prod1cys-cmd/RVN/README.md

# RVN — НИР «Равенство»: модуль первичной обработки сигналов судовой РЛС

НИР «Формирование облика программно-аппаратных средств первичной обработки сигналов судовой радиолокационной станции S- и X-диапазонов» для АО «Равенство» (договор № ОПР-002Н/8-2д от 01.04.2026, ДС № 1 от 18.09.2026). Исполнитель — ОКБ РЭС ГУАП.

В репозитории лежат отчёт о НИР, программа и методика испытаний с протоколами, конструкторская документация на модуль ПОС, плату ПОС, рабочее место и кабели, а также исходные документы (ТЗ, письма, закупки).

## Структура

| Папка | Что внутри |
|---|---|
| [Отчетная документация](Отчетная%20документация/) | Книги отчёта о НИР, ПМ АРБМ.468332.022ПМ, протоколы К-01…К-22 |
| [АРБМ.468332.022 Модуль ПОС](АРБМ.468332.022%20Модуль%20ПОС/) | КД на модуль ПОС (Э2, Э4), плату ПОС АРБМ.468157.011, рабочее место АРБМ.468915.018 и кабели |
| [Документы](Документы/) | ТЗ и ДС, протокол совещания ОПР-2, план-график, перечень отчётной документации, письма заказчику, закупки, патентный поиск, рабочие материалы |

## Состав отчёта о НИР (на 10.11.2026)

| Книга | Название | Файл |
|---|---|---|
| 1 | Аналитический обзор, методология и технические требования | `Отчетная документация/…Книга 1` |
| 2 | Алгоритмы, математическое моделирование и программное обеспечение (объединяются бывшие книги 2 и 4) | `…Книга 2`, `…Книга 2 Модели`, `…Книга 4` — до объединения |
| 3 | Техническая реализация и описание макетов | `…Книга 3` |
| 4 | Технико-экономическое обоснование | — |

Ссылки между книгами даются на уровне книги и раздела («книга 1, раздел 1»); книги отчёта в списки источников не включаются.

## Обозначения

| Обозначение | Изделие / документ |
|---|---|
| АРБМ.468332.022 | Модуль первичной обработки сигналов (модуль ПОС) |
| АРБМ.468157.011 | Плата ПОС (основа функциональных макетов 1 и 2) |
| АРБМ.468915.018 | Рабочее место модуля ПОС |
| АРБМ.468915.104…114 | Кабели рабочего места К4, К5, К6, К10, К14 |
| АРБМ.468332.022ПМ | Программа и методика лабораторных испытаний макетов |

Микросхема АЦП/ЦАП АО «Цифровые решения» в документах обозначается по ГОСТ — **К5119ПВ1Я** (в файлах САПР — Bazalt, А-ЦАП 8-400/8-1600).

## Форматы файлов

`.cdw` — КОМПАС-3D (рядом лежит PDF), `.docx` — Word, `.dxf` — чертежи для КОМПАС/AutoCAD, `.GTL/.GBL/…` — Gerber, `.NET` — списки соединений Altium.
