prod1cys-cmd/RVN/АРБМ.468332.022 Модуль ПОС/АРБМ.468157.011 - Плата ПОС/README.md

# АРБМ.468157.011 Плата ПОС

Печатная плата обработки на СнК Zynq-7000 XC7Z030-1FFG676I с АЦП/ЦАП К5119ПВ1Я, синтезатором HMC7044, усилителями ПЧ AD8367, памятью DDR3 1 ГБ, флеш-памятью 2 × MT25QU02G, микроконтроллером STM32H745, коммутатором Ethernet KSZ9893 и преобразователем USB FT4232HL. На ней собраны функциональные макеты 1 и 2.

| Файл / папка | Содержание |
|---|---|
| АРБМ.468157.011Э3 - Плата ПОС.pdf | Схема электрическая принципиальная |
| АРБМ.468157.011ПЭ3 - Плата ПОС (.docx, .pdf) | Перечень элементов |
| АРБМ.468157.011Э2 - Схема тактирования платы ПОС (.cdw, .pdf) | Тактирование: внешний опорный 10 МГц (X12, SMA) → HMC7044 с генераторами 100 МГц G3, G4 → 400 МГц на К5119ПВ1Я и банк 112 приёмопередатчиков |
| АРБМ.468157.011Э2- Схема питания платы ПОС (.cdw, .pdf) | Вторичное электропитание: ADP2384, TPS54622, TPS7A9201 |
| [Project Outputs for PCB_Project](Project%20Outputs%20for%20PCB_Project/) | Выходные файлы Altium: BOM, списки соединений, отчёты |
| [POS26 gerbers](POS26%20gerbers/) | Gerber-файлы, стек слоёв и бланк заказа плат |

Связанные документы: ТЗ на трассировку — `Документы/АРБМ.468157.011ТЗ…`; сборочный чертёж и альбом — `Документы/АРБМ_468157.011…pdf`; статус закупки компонентов — `Документы/Закупки (КП и перечни)/Статус_закупки.xlsx`.
