prod1cys-cmd/RVN/АРБМ.468332.022 Модуль ПОС/АРБМ.468157.011 - Плата ПОС/POS26 gerbers/README.md

# Gerber-файлы платы ПОС (POS26)

Файлы для изготовления платы находятся в папке [Gerbers](Gerbers/).
