prod1cys-cmd/RVN/АРБМ.468332.022 Модуль ПОС/АРБМ.468915.018 Рабочее место/Кабели/КД_кабели_АРБМ.468915.018/Результат/АРБМ.468915.114СБ К14.pdf

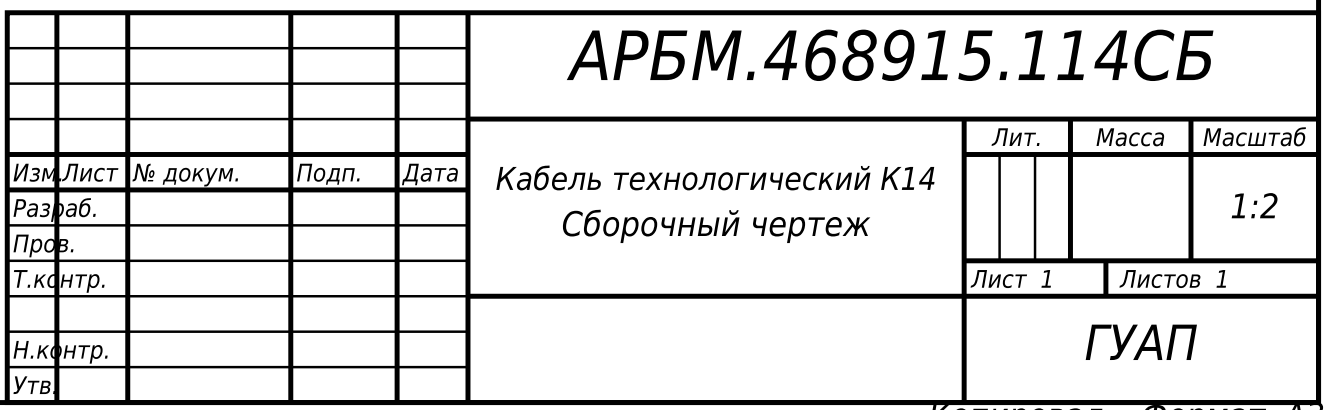
[picture p1: figure]
Изм.Лист; № докум.; Подп.; Дата; Разраб. Пров. Т.контр.; Н.контр. Утв.; Лит.; Масса; Масштаб; Лист 1; Листов 1; АРБМ.468915.114СБ; Кабель технологический К14 Сборочный чертеж; ГУАП

Копировал Формат A3

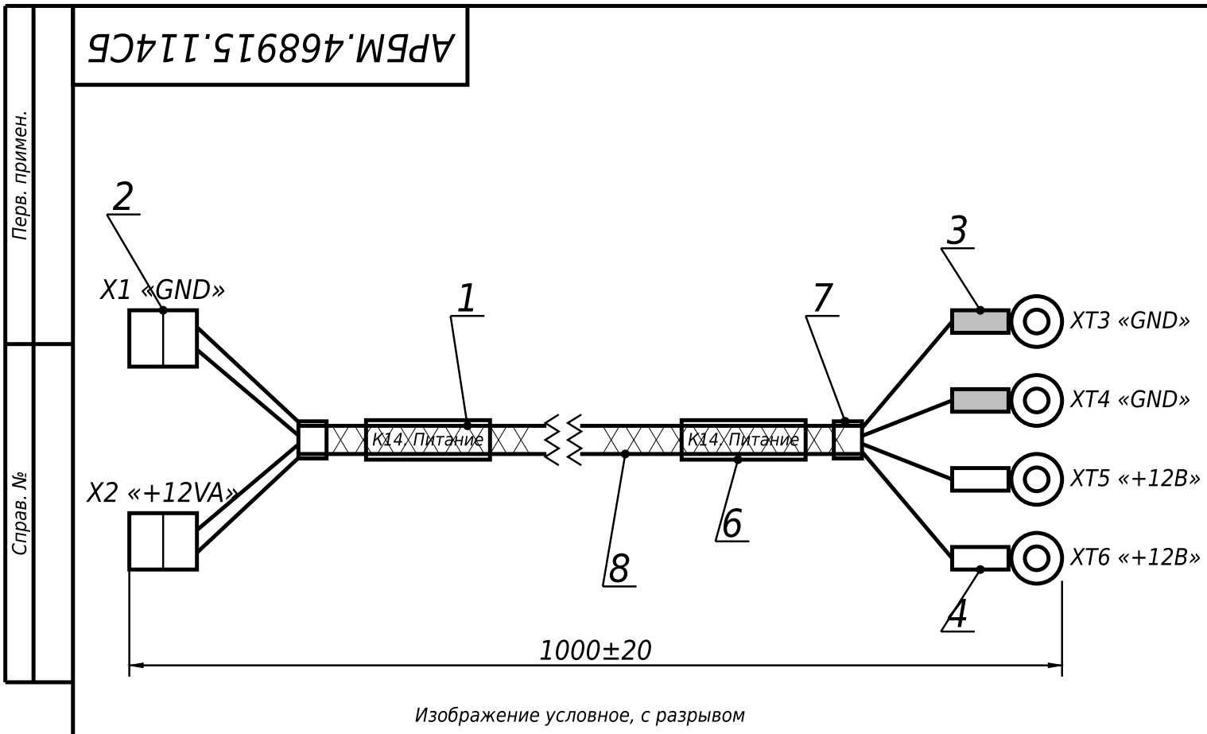
[picture p2: figure]
X1 «GND»; К14. Питание; XT3 «GND»; XT4 «GND»; Изображение условное, с разрывом

Инв. № подл. Подп. и дата Взам. инв. № Инв. № дубл. Подп. и дата Перв. примен. Справ. №

Схема соединений (запараллеливание цепей питания)

X1:1 | П1 | XT3
X1:2 | П2 | XT4
X2:1 | П3 | XT5
X2:2 | П4 | XT6

A8 CH1−

A8 CH1+

Таблица соединений
Провод | Откуда Цепь | | Марка, бирка | Куда | Примечание
П1 | X1:1 | GND | МГТФ 0,5; «П1» | XT3 (НКИ 1,5-4 чёрный) → A8 CH1− | Парал. с П2
П2 | X1:2 | GND | МГТФ 0,5; «П2» | XT4 (НКИ 1,5-4 чёрный) → A8 CH1− | Парал. с П1
П3 | X2:1 | +12VA | МГТФ 0,5; «П3» | XT5 (НКИ 1,5-4 красный) → A8 CH1+ | Парал. с П4
П4 | X2:2 | +12VA | МГТФ 0,5; «П4» | XT6 (НКИ 1,5-4 красный) → A8 CH1+ | Парал. с П3

1 * Размеры для справок.
2 Длину L = 1000 ± 20 мм измерять от торца розеток X1, X2 до торцов наконечников XT3–XT6.
3 Монтаж цепей П1–П4 вести проводом МГТФ 0,5 ТУ 16-505.185-71 по таблице соединений.
4 Цепи питания выполнить запараллеленными: П1 и П2 (GND) — от контактов X1:1 и X1:2 к наконечникам XT3, XT4; П3 и П4 (+12VA) — от X2:1 и X2:2 к XT5, XT6. Наконечники XT3, XT4 подключать к одной клемме CH1−, XT5, XT6 — к клемме CH1+ источника A8.
5 Заделку проводов в розетки 3-640427-2 выполнять методом IDC инструментом TE 58074-1 с головкой для MTA-156 согласно спецификации применения TE. Повторная заделка провода в тот же контакт не допускается.
6 Наконечники НКИ 1,5-4 обжимать инструментом для изолированных наконечников (матрица 0,5–1,5 мм²). Усилие на отрыв провода — не менее
40 Н.
7 Провода ствола заключить в оплётку поз. 8; торцы оплётки оплавить и закрепить трубкой поз. 7 длиной 25 мм.
8 Провода маркировать с двух сторон бирками поз. 5 «П1» … «П4» (шрифт 2,5 ГОСТ 2.304). У розеток X1, X2 и у наконечников установить бирки поз. 6 «К14. Питание».
9 Проверить цепи на обрыв и короткое замыкание по таблице соединений; сопротивление изоляции между цепями GND и +12VA — не менее 20 МОм при 100 В. Сопротивление каждой цепи (два провода параллельно) — не более 0,05 Ом.
