prod1cys-cmd/RVN/Документы/README.md

# Документы

Исходные и организационные документы НИР.

| Файл / папка | Содержание |
|---|---|
| [ТЗ](ТЗ/) | Техническое задание и дополнительное соглашение № 1 |
| Протокол № ОПР-2 от.docx | Протокол совещания по НИР с АО «Равенство» (02.09.2026) |
| План-график_работ_НИР.docx | План-график работ (приложение № 2 к ДС № 1) |
| Перечень_отчётной_документации_НИР (1).docx; Перечень отчетной документации (.cdw, .pdf) | Перечень отчётных документов и распределение содержания по книгам |
| [Письма](Письма/) | Письма главному конструктору АО «Равенство» |
| АРБМ.468157.011ТЗ - Техническое задание на проектирование платы ПОС.docx | ТЗ на трассировку платы ПОС |
| АРБМ_468157.011 - Плата ПОС.pdf, АРБМ_468157.011СБ - Плата ПОС.pdf | Альбом КД платы (СБ, Э3, ПЭ3) и сборочный чертёж |
| НИР Равенство Метрологическое обеспечение.docx | Рабочий документ метролога: контролируемые параметры, методы измерений, средства |
| НИРп1.3Отве(схема).docx | Рабочие материалы к п. 1.3 (функциональная архитектура) |
| Отчет_ПО_судового_локатора.docx | Исходный технический отчёт по ПО локатора (материал для книги ПО) |
| [Патентный поиск](Патентный%20поиск/) | Ссылки на найденные патенты |
| [Закупки (КП и перечни)](Закупки%20(КП%20и%20перечни)/) | Коммерческие предложения, счета, накладные, статус закупки ЭКБ |
