prod1cys-cmd/RVN/Отчетная документация/README.md

# Отчётная документация

Книги отчёта о НИР, программа и методика испытаний и протоколы. У каждого документа есть DOCX (редактируемый) и PDF.

| Файл | Содержание | Статус |
|---|---|---|
| АРБМ.468332.022ПЗ Модуль ПОС Книга 1 | Аналитический обзор, нормативные документы, патентные исследования, методология, технические требования | v8.5 |
| АРБМ.468332.022ПЗ Модуль ПОС Книга 2 | Алгоритмы первичной обработки: основной цикл, обработка градуса и оборота, азимутальная привязка, АПЧ, АРУ, оценка шума… | объединяется с книгой 4 в новую книгу 2 |
| АРБМ.468332.022ПЗ Модуль ПОС Книга 2 Модели | Математическая модель формирования и приёма сигнала, сценарии и результаты моделирования, программа модели | входит в новую книгу 2 |
| АРБМ.468332.022ПЗ Модуль ПОС Книга 3 | Техническая реализация и описание макетов: схемотехника модуля, макеты 1 и 2, стоимость компонентов, рекомендации на ОКР | v6 |
| АРБМ.468332.022ПЗ Модуль ПОС Книга 4 | Программное обеспечение (архитектура ПО, режимы, циклограмма, обмен, загрузка, журнал) | входит в новую книгу 2 |
| АРБМ.468332.022ПМ Модуль ПОС | Программа и методика лабораторных испытаний макетов (контроль 9.1–9.22) | — |
| [Протоколы_испытаний_К01-К22](Протоколы_испытаний_К01-К22/) | Бланки протоколов по каждому виду контроля ПМ | заполняются при испытаниях |

Нумерация книг после объединения: 1 — обзор, 2 — алгоритмы, модели и ПО, 3 — техническая реализация и макеты, 4 — ТЭО.

Замечания по согласованию книг ведутся в документах «Сверка книг 1–4» и «Проверка книги 1 и книги 3» (вне репозитория).
