prod1cys-cmd/RVN/АРБМ.468332.022 Модуль ПОС/АРБМ.468915.018 Рабочее место/README.md

# АРБМ.468915.018 Рабочее место модуля ПОС

Рабочее место для лабораторных испытаний макетов по АРБМ.468332.022ПМ.

| Файл / папка | Содержание |
|---|---|
| АРБМ.468915.018Э4 - Рабочее место модуля ПОС (.cdw, .pdf) | Схема соединений рабочего места: осциллограф TDS2022C, анализатор спектра R&S FSW26, генератор HP E4400B, ST-LINK, Platform Cable USB II, ПК, источник питания, мультиметр; кабели К1–К16 |
| [Кабели](Кабели/) | Чертежи кабелей рабочего места и модуля |
