prod1cys-cmd/RVN/Документы/Закупки (КП и перечни)/README.md

# Закупки ЭКБ

| Файл | Содержание |
|---|---|
| Статус_закупки.xlsx | Статус закупки по актуальному BOM платы ПОС (2 платы): заказано, пришло, недостающие позиции; лист «Накладные» |
| Коммерческое предложение № ГК-64486 488 от 28.07.2026 (5).pdf | КП ООО «ГК «СНАБЖЕНИЕ» |
| Счет NO ГК611392-488-1 от 24 августа 2026.pdf | Счёт ГК «СНАБЖЕНИЕ» (скан) |
| 17774774_061738882.pdf | Счёт АО «ЧИП и ДИП» № 17774774 |
| ГК СНАБЖЕНИЕ 2826-…, 2827-…, 2869-…, 2870-….pdf | УПД ГК «СНАБЖЕНИЕ» за 26.10 и 30.10.2026 (сканы) |
| Наклад.pdf, накладная_послед.pdf, накладная_последняя.pdf | Накладные (сканы) |

Цены из этих документов использованы в книге 3 (расчёт стоимости основных компонентов).
