prod1cys-cmd/RVN/Документы/Патентный поиск/README.md

# Патентный поиск

`патенты.docx` — ссылки на патенты (Google Patents), сгруппированные по темам поиска. Итоги патентных исследований — книга 1, раздел 5.
