prod1cys-cmd/RVN/Документы/Письма/README.md

# Письма

| Файл | Содержание |
|---|---|
| Письмо_параметры_импульсных_сигналов.docx | Запрос параметров импульсных сигналов модуля (запуск модулятора, защитный импульс и др.) |
| Письмо_взаимодействие_со_смежными_системами.docx | Запрос параметров взаимодействия модуля со смежными системами РЛС |

Адресат — главный конструктор НИР АО «Равенство» А.А. Козлов.
