prod1cys-cmd/RVN/Документы/ТЗ/README.md

# ТЗ

| Файл | Содержание |
|---|---|
| ТЗ НИР РЛС 3 (1).docx | Техническое задание на НИР (редактируемый текст) |
| ТЗ Равенство с подписями .pdf | Подписанное ТЗ |
| ДС 1 Равенство.pdf | Дополнительное соглашение № 1 от 18.09.2026: новая редакция ТЗ (два режима, два макета, примечание к п. 1.3.10) и план-график |
