prod1cys-cmd/RVN/АРБМ.468332.022 Модуль ПОС/АРБМ.468915.018 Рабочее место/Кабели/README.md

# Кабели

| Файл / папка | Содержание |
|---|---|
| Кабель BAZALT и HMC.cdw | Кабель к розетке XS3 «BAZALT и HMC» (сброс и сигналы К5119ПВ1Я и HMC7044) |
| Кабель CAN.cdw | Кабель к XS2 «CAN» |
| Кабель IO 1V8.cdw, Кабель IO 3V3 STM.cdw, Кабель IO 3V3 ZYNQ.cdw | Кабели линий ввода-вывода к XS4–XS6 |
| Кабель TO.cdw | Кабель к XS1 «ТО» (RS-232, RS-422, UART) |
| Кабель_технологический.cdw, СВЧ_Кабель.cdw | Технологический и СВЧ-кабели |
| [Кабели пдф](Кабели%20пдф/) | PDF тех же чертежей |
| [КД_кабели_АРБМ.468915.018](КД_кабели_АРБМ.468915.018/) | Сгенерированная КД на кабели рабочего места К4, К5, К6, К10, К14 |
