prod1cys-cmd/RVN/АРБМ.468332.022 Модуль ПОС/АРБМ.468915.018 Рабочее место/Кабели/Кабели пдф/README.md

# Кабели — PDF

PDF-копии чертежей кабелей из папки [Кабели](../): BAZALT и HMC, линии ввода-вывода 1,8 В, IO, кабель внешнего управления, технологический и СВЧ-кабель.
