prod1cys-cmd/RVN/АРБМ.468332.022 Модуль ПОС/АРБМ.468915.018 Рабочее место/Кабели/КД_кабели_АРБМ.468915.018/README.md

# КД на кабели рабочего места АРБМ.468915.018

| Папка | Содержание |
|---|---|
| [Генератор](Генератор/) | Python-скрипты, которые строят КД (чертежи СБ, спецификации) |
| [Результат](Результат/) | Готовые PDF, DXF, CSV и сводный `КД_кабели.md` |

Кабели: К4 (ЦАП1), К5 (ЦАП0), К6 — измерительные РК 50-3-29 с SMA; К10 — кабель внешнего управления; К14 — технологический.
