prod1cys-cmd/RVN/АРБМ.468332.022 Модуль ПОС/АРБМ.468915.018 Рабочее место/Кабели/КД_кабели_АРБМ.468915.018/Результат/README.md

# КД на кабели — результат генерации

| Файлы | Кабель |
|---|---|
| АРБМ.468915.104 К4 спецификация (.csv, .pdf), АРБМ.468915.104СБ К4 (.pdf, лист1.dxf) | К4 — измерительный, ЦАП1 |
| АРБМ.468915.105 … К5 | К5 — измерительный, ЦАП0 |
| АРБМ.468915.106 … К6 | К6 — измерительный |
| АРБМ.468915.110 … К10 (2 листа) | К10 — кабель внешнего управления |
| АРБМ.468915.114 … К14 | К14 — технологический |
| Комплект КД кабели (все листы).pdf | Все листы одним файлом |
| КД_кабели.md | Спецификации, таблицы соединений и технические требования в текстовом виде |
