prod1cys-cmd/RVN/АРБМ.468332.022 Модуль ПОС/АРБМ.468157.011 - Плата ПОС/Project Outputs for PCB_Project/BOM.xlsx

Designator | Name | Quantity | Comment
C1, C2, C7, C8, C15, C81, C82, C435, C436, C438, C494, C495, C496, C497, C498, C499, C500, C501, C502, C503, C504, C505, C506, C507, C508, C509 | GRM155R71C104KA88D | 26 | 0,1 мкФ 10% X7R 16В 0402_(Murata)
C3, C5, C9, C11, C17, C40, C53, C76, C474, C475, C476, C477, C478, C479, C480, C481 | GRM155R61C103KA01D | 16 | 0,01 мкФ 10% X5R 16В 0402_(Murata)
C4, C6, C10, C12, C437, C439 | CL10B475KQ8NQNC | 6 | 4,7 мкФ 10% X7R 6,3В 0603_(Samsung)
C13 | GCQ1555C1H180FB01D | 1 | 18 пФ 1% C0G 50В 0402_(Murata)
C14, C38, C174, C175, C176, C177, C178, C184, C185, C186, C187, C188, C195, C196, C197, C198, C199, C205, C206, C207, C208, C209, C215, C216, C217, C218, C219, C227, C228, C229, C230, C231, C236, C237, C238, C239, C240, C244, C245, C246, C247, C254, C255, C256, C257, C261, C262, C263, C264, C303, C304, C307, C308, C359, C362, C363 | GCM155R71C104JA55J | 56 | 0,1 мкФ 5% X7R 16В 0402_(Murata)
C16 | CC0402JRX7R9BB561 | 1 | 560 пФ 5% X7R 50В 0402_(Yageo)
C18, C117, C120, C336, C342, C358, C360, C364, C367 | GRT188R61C106KE13D | 9 | 10 мкФ 10% X5R 16В 0603_(Murata)
C19 | GRM188R61E475KE11D | 1 | 4,7 мкФ 10% X5R 25В 0603_(Murata)
C20, C148, C161, C169, C170, C265, C407, C409, C510, C511 | GRM21BR60J107ME15 | 10 | 100 мкФ 20% X5R 6,3В 0805_(Murata)
C21, C41, C44, C47, C48, C66, C69, C74, C97, C99, C100, C101, C102, C103, C104, C356, C357, C433, C434, C440, C441, C442 | GMC10X7R105J16NT | 22 | 1 мкФ 5% X7R 16V 0603_(Cal-chip electronics)
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
C296, C297, C298, C347, C351, C427, C429 | CC0603BRNPO9BN3R9 | 7 | 3,9 пФ 0.1 пФ NP0 50В 0603_(Yageo)
C299, C300, C301, C302, C348, C349, C350 | GRM155R61H105KE05D | 7 | 1 мкФ 10% X5R 50В 0402_(Murata)
C328 | 298D106X0016R2 | 1 | 10 мкФ 20% Тант. 16В 0805_(Vishay)
C332, C369 | GRM21BR61A476ME15K | 2 | 47 мкФ 20% X5R 10В 0805_(Murata)
C431, C432 | CC0201CPNPO9BN1R5 | 2 | 1,5 пФ 0.25 пФ NP0 50В 0603_(Yageo)
C444, C445, C446, C448, C449 | GRM1885C1H100JA01D | 5 | 10 пФ 5% NPO 50В 0603_(Murata)
C447 | GRM188R60J105KA01D | 1 | 1 мкФ 10% X5R 6,3В 0603_(Murata)
C450, C451, C455 | GRM188C81C225KA12D | 3 | 2,2 мкФ 10% X6S 16В 0603_(Murata)
C523, C527, C583, C588 | CBR06C101J5GACAUTO | 4 | 100 пФ 0,05пФ C0G 50В 0603_(Kemet)
C536, C537, C538, C539, C540, C541, C542, C543, C544, C545, C546, C547, C548, C549, C550, C551, C552, C553, C554, C555, C556, C557, C558, C559, C589, C590, C591, C592, C593, C594, C595, C596, C597, C598, C599, C600, C601, C602, C603, C604, C605, C606, C607, C622, C623, C624, C625, C626, C627, C628 | GRM033R71C103KE14D | 50 | 0,01 мкФ 10% C0G 16В 0201_(Murata)
C630, C631, C632, C634, C635, C636, C637, C638, C639, C640, C641, C642, C643, C644 | CGA2B2X8R2A222K050BA | 14 | 2200 пФ 10% X8R 100В 0402_(TDK)
C645, C646 | VJ0402D270FXCAJ | 2 | 27 пФ 1% NP0 200В 0402_(Vishay)
C647 | GRM033R61E104ME14D | 1 | 0,1 мкФ 20% X5R 25В 0201_(Murata)
DA2, DA3, DA4, DA5, DA6, DA7, DA8, DA9, DA10, DA11, DA12, DA13 | TPS7A9201DSKT | 12 | _(Texas Instruments)
DD1 | KSZ9893RNXC-TR | 1 | _(Microchip Technology)
DD5, DD6 | MT25QU02GCBB8E12-0SIT | 2 | _(Micron Technology)
DD7 | XC7Z030-1FFG676I | 1 | _(Xilinx)
DD9, DD25, DD46 | TMP112AIDRLT | 3 | _(Texas Instruments)
DD10 | HMC7044LP10BE | 1 | PLL HMC7044LP10BE Analog Devices
DD11, DD12, DD13, DD14, DD27, DD31, DD32, DD33 | TPS54622RHLR | 8 | _(Texas Instruments)
DD16, DD17, DD18, DD19, DD20 | 74AVC4T774GU | 5 | Supply Transceiver 74AVC4T774GU Nexperia
DD21, DD22, DD23, DD24, DD28, DD29, DD30 | ADP2384ACPZN-R7 | 7 | _(Analog Device)
DD26 | ADP2370ACPZ-1.8-R7 | 1 | _(Analog Devices)
DD34, DD37 | MCP2562FD-E/SN | 2 | _(Microchip Technology)
DD35 | STM32H745IIT6 | 1 | _(STMicroelectronics)
DD36 | 93LC56A | 1 | _(Microchip)
DD38 | FT4232HL | 1 | _(FTDI)
DD39 | MAX232ECDR | 1 | _(Texas Instruments)
DD40 | SN65C1168EMPWSEP | 1 | _(Texas Instruments)
DD41, DD42, DD43, DD44, DD45 | 74HC2G34 | 5 | _(Nexperia)
DD48 | IS43TR16512B-125KBL | 1 | _(ISSI)
G1 | ASEM1-25.000MHZ-LC-T | 1 | _(Abracon)
G2 | ASEM1-50.000MHZ-LC-T | 1 | _(Abracon)
G3 | DSC1123CI2-100.0000 | 1 | _(Microcip)
G4 | ABLNO-V-100.000MHZ-T2 | 1 | Generator ABLNO-V-100.000MHZ-T2 Abracon
L1, L2, L20, L21, L22, L23 | BLM18SG121TN1D | 6 | 0.025 Ohms 25% 3А 0603_(Murata)
L3, L13, L18 | XAL6060-682MEB | 3 | 6,8 мкГн 20% 9 А_(Coilcraft)
L4, L6 | 744771003 | 2 | 3,5 мкГн 20% 9,25А 12x12_(Wurth)
L5, L10, L15, L17, L19 | XAL4030-472MEC | 5 | 4,7 мкГн 20% 5,1А 1616_(Coilcraft)
L7, L8, L9, L14, L16 | AWVF006060282R2M00 | 5 | 2,2 мкГн 20% 5А 2424_(Pulse)
L12 | XAL4030-682ME | 1 | 6,8 мкГн 20% 3,9А 1616_(Coilcraft)
L24, L25, L26, L27, L28, L29, L30, L31 | LQW15CA1R0K00D | 8 | LQW15CA1R0K00D
L32, L33, L34, L35, L36, L37 | BLM15PX330SZ1D | 6 | 22 мОм 25% 3А 0402_(Murata)
R1, R2, R4, R5, R6, R18, R19, R20, R21, R22, R23, R24, R131, R132, R133, R134, R135, R136, R137, R138, R139, R140, R141, R142, R143, R144, R145, R147, R148, R149, R150, R151, R152, R153, R154, R155, R157, R158, R159, R160, R161, R164, R180, R321, R322, R324, R328, R329, R333, R335, R339, R340, R341, R342, R343, R349, R350, R351, R352, R353, R354, R355, R356, R357, R358, R359, R360, R397 | CR0603-J/-000ELF | 69 | 0 Ом 1% 0,1Вт 0603_(Bourns)
R7, R8, R9, R16, R17, R49, R50, R52, R61, R236, R388 | RC0402FR-074K7L | 11 | 4,7 кОм 1% 0,063Вт 0402_(Yageo)
R10, R100 | RT0402FRE076K04L | 2 | 6,04 кОм 1% 0,063Вт 0402_(Yageo)
R11, R12, R13, R14, R51, R53 | RT0603BRE07330RL | 6 | 330 Ом 0,1% 0,1Вт 0603_(Yageo)
R15, R91, R92, R106, R110, R239, R286, R287, R288 | RC0603FR-07100KP | 9 | 100 кОм 1% 0,1Вт 0603_(Yageo)
R25, R57 | RT0402BRD0733RL | 2 | 33 Ом 0,1% 0,063Вт 0402_(Yageo)
R26, R27, R28, R29, R30, R31, R32, R33 | RT0603BRD0749R9L | 8 | 49,9 Ом 0,1% 0,1Вт 0603_(Yageo)
R34 | RC0402FR-07240RL | 1 | 240 Ом 1% 62,5 мВт 0402_(Yageo)
R35, R36 | RC0402JR-0775RL | 2 | 75 Ом 5% 0,063Вт 0402_(Yageo)
R37, R38, R54, R56, R62, R63, R64, R65, R66, R67, R68, R69, R70, R71, R74, R75, R76, R87, R88, R209, R213, R215, R217, R250, R252, R253, R265, R266, R272, R281, R282, R305, R306, R313, R314, R315, R325, R327, R331, R332, R361, R362, R363, R364 | RC0402FR-070RL | 46 | 0 Ом 1% 0,063Вт 0402_(Yageo)
R41, R42, R43, R44, R45, R46 | RC0402FR-0722RL | 6 | 22 Ом 1% 0,062Вт 0402_(Yageo)
R47, R48 | CR0402-JW-101GLF | 2 | 100 Ом 5% 0,063Вт 0402_(Bourns)
R55 | RC0402FR-07200RL | 1 | 200 Ом 1% 0,063Вт 0402_(Yageo)
R58, R59, R60, R233, R234, R235, R385, R386, R387 | RC0402FR-075K1L | 9 | 5,1 кОм 1% 0,063Вт 0402_(Yageo)
R72, R73, R78, R80, R117, R118, R119, R120, R121, R122, R123, R124, R125, R126, R127, R128, R129, R146, R165, R166, R167, R168, R169, R170, R171, R172, R173, R174, R175, R176, R177, R178, R179, R181, R182, R183, R184, R185, R186, R187, R188, R189, R190, R191, R192, R193, R194, R195, R196, R197, R198, R199, R326, R330, R337, R344 | RC0603FR-0710KL | 56 | 10 кОм 1% 0,1Вт 0603_(Yageo)
R77 | RC0402FR-073K3L | 1 | 3,3 кОм 1% 0,063Вт 0402_(Yageo)
R79, R86, R130, R156, R162, R163, R320 | ERJ2RKF5100X | 7 | 510 Ом 1% 0,063Вт 0402_(Panasonic)
R81 | RC0402FR-1356R2L | 1 | 56,2 Ом 1% 0,063Вт 0402_(Yageo)
R82, R83 | RC0201FR-070RL | 2 | 0 Ом 1% 50мВт 0201_(YAGEO)
R84, R85, R97, R259, R260, R307, R309 | RT0402BRE071K5L | 7 | 1,5 кОм 0,1% 0,063Вт 0402_(Yageo)
R89, R90, R105, R109, R238, R283, R284, R285 | RC0402FR-1337K4L | 8 | 37,4 кОм 1% 0,063Вт 0402_(Yageo)
R93, R99, R240, R261, R262, R289, R310, R312 | CRCW04021K87FKED | 8 | 1,87 кОм 1% 0,063Вт 0402_(Vishay)
R94, R111, R114, R299, R304 | RC0603FR-076K8P | 5 | 6,8 кОм 1% 0,1Вт 0603_(Yageo)
R95, R96, R107, R112, R241, R290, R292, R293 | RC0402FR-1391KL | 8 | 91 кОм 1% 0,063Вт 0402_(Yageo)
R98 | RT0603BRE0711K8L | 1 | 11,8 кОм 1% 0,1Вт 0603_(Yageo)
R101, R104, R113, R115, R242, R297, R298, R302 | ERJ-1GEJ103C | 8 | 10 кОм 5% 0,05Вт 0603_(Panasonic)
R102 | RT0402BRD072K21L | 1 | 2,21 кОм 1% 0,062Вт 0402_(Yageo)
R103, R243, R303 | RC0402BR-0720KL | 3 | 20 кОм 0,1% 0,063Вт 0402_(Yageo)
R108, R291, R294 | RC0603FR-074R75L | 3 | 4,75 кОм 1% 0,1Вт 0603_(Yageo)
R116 | RC0603FR-0715KP | 1 | 15 кОм 1% 0,1Вт 0603_(Yageo)
R200, R201, R202, R203, R232, R244, R245, R246 | CSSH0805FTL500 | 8 | 0,5 мОм 1% 1Вт 0805_(Stackpole Electronics)
R204, R205, R206, R207, R247, R248, R249, R345, R346 | RC0402FR-0710KL | 9 | 10 кОм 1% 0,0625Вт 0402_(Yageo)
R208, R212, R214, R216, R256, R257, R258, R316, R317, R318, R319, R323, R338 | CR0603-FX-1200ELF | 13 | 120 Ом 1% 0,1Вт 0603_(Bourns)
R210 | RT0402BRE0733KL | 1 | 33 кОм 0,1% 0,063Вт 0402_(Yageo)
R211, R218, R255 | RC0603FR-0731K6L | 3 | 31,6 кОм 1% 0,1Вт 0603_(Yageo)
R219, R251, R254 | RC0603FR-1347KL | 3 | 47 кОм 1% 0,1Вт 0603_(Yageo)
R220 | TNPW040254K2BEED | 1 | 54,2 кОм 0,1% 0,063Вт 0402_(Vishay)
R221, R222, R223, R267, R268, R269 | RC0402FR-07100KL | 6 | 100 кОм 1% 0,063Вт 0402_(Yageo)
R224, R225, R226, R228, R237, R275 | RC0603FR-1010KL | 6 | 10 кОм 1% 0,1Вт 0603_(Yageo)
R227, R229, R276, R336 | AT0402BRD072K21L | 4 | 2,21 кОм 0,1% 0,063Вт 0402_(Yageo)
R230, R273 | TNPW060322K0BEEA | 2 | 22 кОм 0,1% 0,1Вт 0603_(Vishay)
R231, R264, R274, R279, R280, R300, R301, R311 | RC0603FR-073KP | 8 | 3 кОм 1% 0,1Вт 0603_(Yageo)
R263, R277, R278, R295, R296, R308, R334 | RC0603FR-0712KP | 7 | 12 кОм 1% 0,1Вт 0603_(Yageo)
R270 | RT0603BRE0747K5L | 1 | 47,5 кОм 0,1% 0,1Вт 0603_(Yageo)
R271 | RT0603BRD0715KL | 1 | 15 кОм 0,1% 0,1Вт 0603_(Yageo)
R347, R348, R373, R374, R375, R376 | RC0402FR-07100RL | 6 | 100 Ом 1% 0,063Вт 0402_(Yageo)
R365, R366, R367, R368, R369, R370, R371, R372, R389, R390, R391, R392, R393, R394, R395, R396 | CRCW020149R9FNED | 16 | 49,9 Ом 1% 0,063Вт 0201_(Vishay)
R377, R378, R379, R380, R381, R382, R383, R384 | CRCW060310R0JNEA | 8 | 10 Ом 5% 0,1Вт 0603_(Vishay)
T1 | PT61020EL | 1 | _(Bourns)
T2, T3, T4, T5, T6, T7, T8, T9, T10, T11, T12 | TCM2-33WX+ | 11 | RF Transformer TCM2-33WX+ Mini-Circuits
VD1, VD2, VD3, VD4, VD7, VD8, VD9, VD10 | SML-P11MTT86R | 8 | _(ROHM Semiconductors)
VD5, VD6 | SML-P11UTT86R | 2 | _(Semiconductors)
VD11, VD12 | PESD2CAN | 2 | _(Nexperia)
X1 | 17 21 110 2102 | 1 | _(Harting)
X2, X3 | 17 24 110 2102 | 2 | _(Harting)
X4, X6, X7, X13 | PLS-2 | 4 | PLS-2
X5 | PLS-3 | 1 | PLS-3
X8, X11 | 5103308-1 | 2 | _(TE Connectivity)
X10 | 5009010801 | 1 | _(Molex)
X12, X20, X21, X23, X24, X25, X26, X35, X36, X37, X38 | SMA-J-P-H-ST-TH1 | 11 | _(Samtec)
X14, X15, X16, X17, X18, X19, X27, X28, X29, X30, X31, X32, X33, X34 | S0991-46R | 14 | _( Harwin)
X39 | DS1095-06-BNR0 | 1 | _(Zhenqin)
Z1, Z13, Z14, Z15, Z16, Z17, Z18, Z19, Z20, Z23, Z24 | BLM18SN220TN1D | 11 | 22 Ом 25% 8А 0603_(Murata)
Z2, Z4, Z5, Z6, Z7, Z8, Z9, Z10, Z11, Z12, Z21, Z22 | MI0603M121R-10 | 12 | 120 Ом 2,5А 0603_(Laird Performance Materials)
Z3 | BLM31PG330SZ1L | 1 | 9 мОм 25% 6А 1206_(Murata)
ZQ1 | NX3225HA-25MHz-EXS00A-CH00343 | 1 | _(NDK)
ZQ2 | 7U-12.000-12-30-80-C-50 | 1 | _(SJK)
ZQ3 | NX3215SA-32.768KHZ-EXS00A-MU00525 | 1 | _(NDK)
