prod1cys-cmd/RVN/Документы/Закупки (КП и перечни)/Статус_закупки.xlsx

Sheet: Статус BOM
Статус закупки по актуальному BOM.xlsx
 |  | Количество плат: | 2
№ | Поз. обозначения | P/N по BOM | Параметры (BOM) | Нужно на 1 плату | Нужно на все платы | P/N поставки (осн.) | P/N поставки (доп.) | Заказано у ГК, шт (62100 + 492) | Заказано у ЧиД, шт | Пришло всего, шт | Нужно всего по этому P/N | Ручная отметка | СТАТУС | Комментарий
1 | C1, C2, C7, C8, C15, C81, C82, C435, C436, C438, C494, C495, C496, C497, C498, C499, C500, C501, C502, C503, C504, C505, C506, C507, C508, C509 | GRM155R71C104KA88D | 0,1 мкФ 10% X7R 16В 0402_(Murata) | 26 | 52 | GRM155R71C104KA88D |  | 485 | 0 | 485 | 52 |  | Пришло
2 | C3, C5, C9, C11, C17, C40, C53, C76, C474, C475, C476, C477, C478, C479, C480, C481 | GRM155R61C103KA01D | 0,01 мкФ 10% X5R 16В 0402_(Murata) | 16 | 32 | GRM155R61C103KA01D |  | 102 | 0 | 102 | 32 |  | Пришло
3 | C4, C6, C10, C12, C437, C439 | CL10B475KQ8NQNC | 4,7 мкФ 10% X7R 6,3В 0603_(Samsung) | 6 | 12 | CL10B475KQ8NQNC |  | 46 | 0 | 46 | 12 |  | Пришло
4 | C13, C128, C145 | GCM1555C1H180FA16D | 18 пФ 1% C0G 50В 0402_(Murata) | 3 | 6 | GCM1555C1H180FA16D |  | 33 | 0 | 33 | 6 |  | Пришло
5 | C14, C38, C121, C124, C132, C133, C146, C147, C155, C156, C158, C159, C160, C162, C163, C165, C166, C171, C172, C173, C174, C175, C176, C177, C178, C182, C183, C184, C185, C186, C187, C188, C193, C194, C195, C196, C197, C198, C199, C203, C204, C205, C206, C207, C208, C209, C213, C214, C215, C216, C217, C218, C219, C225, C226, C227, C228, C229, C230, C231, C236, C237, C238, C239, C240, C244, C245, C246, C247, C254, C255, C256, C257, C261, C262, C263, C264, C327, C333, C335, C345, C359, C362, C363, C371, C400, C401, C403, C404, C415, C416, C417, C424, C425, C426, C428, C430, C443 | GRM155R71C104JA88D | 100 нФ 5% X7R 16В 0402_(Murata) | 98 | 196 | GRM155R71C104JA88D |  | 398 | 0 | 336 | 204 |  | Пришло
6 | C16 | CC0402JRX7R9BB561 | 560 пФ 5% X7R 50В 0402_(Yageo) | 1 | 2 | CC0402JRX7R9BB561 |  | 33 | 0 | 33 | 2 |  | Пришло
7 | C18, C117, C120, C336, C342, C358, C360, C364, C367 | CC0603KRX5R7BB106 | 10 мкФ 10% X5R 16В 0603_(Yageo) | 9 | 18 | CC0603KRX5R7BB106 |  | 54 | 0 | 54 | 28 |  | Пришло
8 | C19, C35, C36, C150, C151, C152, C153, C154, C249, C250 | GRM188R60J476ME15D | 47 мкФ 20% X5R 6,3В 0603_(Murata) | 10 | 20 | GRM188R60J476ME15D |  | 49 | 0 | 49 | 20 |  | Пришло
9 | C20, C148, C161, C169, C170, C265, C409, C510, C511 | GRM21BR60J107ME15L | 100 мкФ 20% X5R 6,3В 0805_(Murata) | 9 | 18 | GRM21BR60J107ME15L |  | 82 | 0 | 82 | 18 |  | Пришло
10 | C21, C41, C44, C47, C48, C66, C69, C74, C97, C99, C100, C101, C102, C103, C104, C282, C355, C356, C357, C402, C433, C434, C440, C441, C442, C446, C447 | GMC10X7R105J16NT | 1 мкФ 5% X7R 16V 0603_(Cal-chip electronics) | 27 | 54 | GMC10X7R105J16NT |  | 50 | 0 | 50 | 54 |  | Пришло частично | недостаток добить GRM155R61H105KE05D
11 | C22, C23, C24, C25, C30, C32, C37, C91, C92, C93, C94, C95, C96, C98, C105, C106, C107, C108, C109, C110, C118, C119, C137, C140, C268, C270, C271, C272, C273, C274, C275, C277, C278, C279, C280, C281, C380, C381, C383, C384, C385, C386, C387, C390, C392, C406, C407, C418, C419, C456, C457, C458, C459, C460, C461, C462, C463, C464, C465, C466, C467, C468, C469, C470, C471, C472, C482, C483, C484, C485, C486, C487, C488, C489, C490, C491, C492, C493, C633, C642, C647, C648 | CC0603JRX7R7BB104 | 0,1 мкФ 5% X7R 16В 0603_(Yageo) | 82 | 164 | CC0603JRX7R7BB104 |  | 41 | 120 | 161 | 164 |  | Пришло частично | недостаток добить GCM155R71C104JA55J
12 | C26, C27 | GRT155R71A474KE01D | 0,47 мкФ 10% X7R 10В 0402_(Murata) | 2 | 4 | GRT155R71A474KE01D |  | 36 | 0 | 36 | 4 |  | Пришло
13 | C28, C29 | GRM32ER61E226KE15L | 22 мкФ 10% X5R 25В 0603_(Murata) | 2 | 4 | GRM32ER61E226KE15L |  | 36 | 0 | 36 | 4 |  | Пришло
14 | C31, C444, C445, C448, C449 | GRM1885C1H100JA01D | 10 пФ 5% NPO 50В 0603_(Murata) | 5 | 10 | CC0603JRNPO9BN100 | GRM1885C2A100JA01D | 16 | 15 | 31 | 10 |  | Пришло | Аналоги: CC0603JRNPO9BN100 (ГК, дог. 492) и GRM1885C2A100JA01D (ЧиД)
15 | C33, C34, C189, C192, C202, C210, C211, C212, C220, C221, C222, C223, C224, C232, C233, C234, C241, C242, C243, C248, C259, C260, C266, C267 | GRM155R61E474KE01D | 0,47 мкФ 10% X5R 25В 0402_(Murata) | 24 | 48 | GRM155R61E474KE01D |  | 93 | 0 | 93 | 48 |  | Пришло
16 | C39 | GRM155R71E103JA01D | 0,01 мкФ 5% X7R 25В 0402_(Murata) | 1 | 2 | GRM155R71E103JA01D |  | 41 | 0 | 41 | 6 |  | Пришло
17 | C42, C43, C45, C46, C50, C51, C52, C57, C58, C59, C60, C61, C62, C63, C64, C67, C70, C71, C72, C75, C83, C84, C85, C86, C87, C88, C89, C90, C520, C521, C524, C525, C528, C529, C530, C531, C532, C533, C534, C535, C570, C571, C572, C573, C574, C575, C576, C577, C578, C579, C580, C581, C584, C585, C586, C615, C616, C617, C618, C619, C620, C621 | GRM033R61C104KE84D | 0,1 мкФ 10% X5R 16В 0201_(Murata) | 62 | 124 | GRM033R61C104KE84D |  | 114 | 66 | 180 | 124 |  | Пришло
18 | C49, C284, C285, C286, C289, C290, C291, C292, C334, C337, C338, C339, C340, C341, C344 | GRM188R61E106KA73D | 10 мкФ 10% X5R 25В 0603_(Murata) | 15 | 30 | GRM188R61E106KA73D |  | 69 | 0 | 69 | 30 |  | Пришло
19 | C54, C55, C56, C68, C73, C77, C111, C112, C113, C114, C115, C116, C294, C522, C526, C582, C587 | GRM188R71H102KA01D | 1000 пФ 10% X7R 50В 0603_(Murata) | 17 | 34 | GRM188R71H102K |  | 0 | 46 | 46 | 34 |  | Пришло
20 | C65, C79, C80, C523, C527, C583, C588 | GRM1555C1H101JA01D | 100 пФ 5% NPO 50В 0402_(Murata) | 7 | 14 | GRM1555C1H101JA01D |  | 0 | 15 | 15 | 14 |  | Пришло
21 | C78, C126, C144 | GCM155R71H102KA37D | 1000 пФ 10% X7R 50В 0402_(Murata) | 3 | 6 | GCM155R71H102KA37D |  | 33 | 0 | 33 | 6 |  | Пришло
22 | C122, C123, C135, C136, C138, C143, C149, C324, C329, C379, C388, C389, C408 | GMC10X5R226M16NT | 22 мкФ 20% X5R 16В 0603_(Cal-chip electronics) | 13 | 26 | GMC10X5R226M16NT |  | 67 | 0 | 67 | 26 |  | Пришло
23 | C125, C305, C306, C309, C310, C325, C361, C365, C366, C393 | CC0402KRX7R9BB223 | 0,022 мкФ 10% X7R 50В 0402_(Yageo) | 10 | 20 | CC0402KRX7R9BB223 |  | 49 | 0 | 49 | 20 |  | Пришло
24 | C127, C326, C396 | GRM1885C2A220JA01J | 22 пФ 5% C0G 100В 0603_(Murata) | 3 | 6 | GRM1885C2A220JA01D |  | 0 | 15 | 15 | 6 |  | Пришло
25 | C129, C293, C313, C314, C315, C317, C318, C319, C332, C343, C369, C373, C374, C375, C376, C377, C378 | GRM21BR61A476ME15L | 47 мкФ 20% X5R 10В 0805_(Murata) | 17 | 34 | GRM21BR61A476ME15L |  | 103 | 0 | 103 | 34 |  | Пришло
26 | C130, C311, C312, C316, C320, C321, C352 | GRM32ER60J107ME20L | 100 мкФ 20% X5R 6,3В 1210_(Murata) | 7 | 14 | GRM32ER60J107ME20L |  | 43 | 0 | 43 | 14 |  | Пришло
27 | C131, C134, C330, C331, C353, C354, C368, C382, C397, C398, C410, C411, C412, C413, C414, C421, C422, C423 | GRM188R60J226MEA0D | 22 мкФ 20% X5R 6,3В 0603_(Murata) | 18 | 36 | GRM188R60J226MEA0D |  | 82 | 0 | 82 | 36 |  | Пришло
28 | C139, C391, C452, C453, C454 | CL05A106MQ5NUNC | 10 мкФ 20% X5R 6,3В 0402_(Samsung) | 5 | 10 | CC0603KRX5R7BB106 | GRM188R61E106KA73D | 123 | 0 | 123 | 28 |  | Пришло | Замена GRM188R61E106KA73D, CC0603KRX5R7BB106
29 | C141, C394 | GRM155R61C333KA01D | 0,033 мкФ 10% X5R 16В 0402_(Murata) | 2 | 4 | GRM155R61C333KA01D |  | 38 | 0 | 38 | 4 |  | Пришло
30 | C142, C399 | CC0201FRNPO9BN330 | 33 пФ 1% NP0 50В 0201_(Yageo) | 2 | 4 | CC0201FRNPO9BN330 |  | 38 | 0 | 38 | 4 |  | Пришло
31 | C157, C167 | 194D105X5015B2B | 1 мкФ 5% Тант. 15В Case"B"_(Vishay) | 2 | 4 | 194D105X5015B2B |  | 36 | 0 | 36 | 4 |  | Пришло
32 | C164, C168, C179, C180, C181, C190, C191, C200, C201, C251, C252, C253, C258, C512, C513, C514, C515, C516, C517, C518, C519, C560, C561, C562, C563, C564, C565, C566, C567, C568, C569, C608, C609, C610, C611, C612, C613, C614 | GRM155R61H474KE11D | 0,47 мкФ 10% X5R 50В 0402_(Murata) | 38 | 76 | GRM155R61H474KE11D |  | 64 | 46 | 110 | 76 |  | Пришло
33 | C235 | 293D475X9016A2TE3 | 4,7 мкФ 10% Тант. 16В 1206_(Vishay) | 1 | 2 | 293D475X9016A2TE3 |  | 33 | 0 | 23 | 2 |  | Пришло
34 | C269, C276, C370, C372, C395, C405, C420, C629 | GRT1885C1E103FA02D | 10 нФ 1% NP0 25В 0603_(Murata) | 8 | 16 | GRT1885C1E103FA02D |  | 62 | 0 | 62 | 16 |  | Пришло
35 | C283, C287 | C2012X7R1A475K125AC | 4,7 мкФ 10% X7R 10В 0805_(TDK) | 2 | 4 | C2012X7R1A475K125AC | GRM21BR71A475KA73L | 41 | 0 | 41 | 4 |  | Пришло
36 | C288, C346 | 600S4R7BW250XT | 4,7 пФ 0,1пФ NPO 250В 0603_(Kyocera) | 2 | 4 | 600S4R7BW250XT |  | 33 | 0 | 33 | 4 |  | Пришло
37 | C295 | GJM1555C1H6R4BB01D | 6,4 пФ 0,1пФ C0G 50В 0402_(Murata) | 1 | 2 | GJM1555C1H6R4BB01D | GJM1555C1H6R4CB01D | 70 | 0 | 60 | 2 |  | Пришло
38 | C296, C297, C298, C347, C351, C427, C429 | CC0603BRNPO9BN3R9 | 3,9 пФ 0,1пФ NP0 50В 0603_(Yageo) | 7 | 14 | CC0603BRNPO9BN3R9 |  | 46 | 0 | 46 | 14 |  | Пришло
39 | C299, C300, C301, C302, C348, C349, C350 | GRM155R61H105KE05D | 1 мкФ 10% X5R 50В 0402_(Murata) | 7 | 14 | GRM155R61H105KE05D |  | 85 | 0 | 85 | 14 |  | Пришло
40 | C303, C304, C307, C308 | GCM155R71C104JA55J | 0,1 мкФ 5% X7R 16В 0402_(Murata) | 4 | 8 | GRM155R71C104JA88D |  | 398 | 0 | 336 | 204 |  | Пришло
41 | C322, C473 | C0402C103J8RACTU | 0,01 мкФ 5% X7R 10В 0402_(Kemet) | 2 | 4 | GRM155R71E103JA01D | C0402C103J3RACTU | 41 | 9 | 50 | 6 |  | Пришло
42 | C323 | CC0603KRX5R7BB475 | 4,7 мкФ 10% X5R 16В 0603_(Yageo) | 1 | 2 | CC0603KRX5R7BB475 |  | 51 | 0 | 51 | 2 |  | Пришло
43 | C328 | 298D106X0016R2T | 10 мкФ 20% Тант. 16В 0805_(Vishay) | 1 | 2 | 298D106X0016R2T |  | 36 | 0 | 36 | 2 |  | Пришло
44 | C431, C432 | CC0201CPNPO9BN1R5 | 1,5 пФ 0.25 пФ NP0 50В 0603_(Yageo) | 2 | 4 | CC0201CPNPO9BN1R5 |  | 36 | 0 | 36 | 4 |  | Пришло
45 | C450, C451, C455 | GRM188C81C225KA12D | 2,2 мкФ 10% X6S 16В 0603_(Murata) | 3 | 6 | GRM188C81C225KA12D |  | 38 | 0 | 38 | 6 |  | Пришло
46 | C536, C537, C538, C539, C540, C541, C542, C543, C544, C545, C546, C547, C548, C549, C550, C551, C552, C553, C554, C555, C556, C557, C558, C559, C589, C590, C591, C592, C593, C594, C595, C596, C597, C598, C599, C600, C601, C602, C603, C604, C605, C606, C607, C622, C623, C624, C625, C626, C627, C628 | GRM033R71C103KE14D | 0,01 мкФ 10% C0G 16В 0201_(Murata) | 50 | 100 | GRM033R71C103KE14D |  | 36 | 109 | 145 | 100 |  | Пришло
47 | C630, C631, C632, C634, C635, C636, C637, C638, C639, C640, C641, C643, C644 | CGA2B2X8R2A222K050BA | 2200 пФ 10% X8R 100В 0402_(TDK) | 13 | 26 | GRM155R71E222KA01D |  | 0 | 41 | 41 | 26 |  | Пришло
48 | C645, C646 | VJ0402D270FXCAJ | 27 пФ 1% NP0 200В 0402_(Vishay) | 2 | 4 | CC0402JRNPO9BN270 |  | 0 | 10 | 10 | 4 |  | Пришло
49 | DA1, DA8, DA14, DA15 | AD8367ARU | _(Analog Devices) | 4 | 8 | AD8367ARUZ-RL7 |  | 8 | 0 | 0 | 8 |  | Заказано, не пришло
50 | DA2, DA3, DA4, DA5, DA6, DA7, DA9, DA10, DA11, DA12, DA13 | TPS7A9201DSKR | _(Texas Instruments) | 11 | 22 | TPS7A9201DSKR |  | 32 | 0 | 32 | 22 |  | Пришло
51 | DD1 | KSZ9893RNXC-TR | _(Microchip Technology) | 1 | 2 | KSZ9893RNXC-TR |  | 0 | 0 | 0 | 2 |  | Не заказано | В дог. 492 не вошёл, в других заказах нет — ЗАКАЗАТЬ
52 | DD2, DD41, DD43, DD44, DD45 | 74HC2G34GV | _(Nexperia) | 5 | 10 | 74HC2G34GV |  | 21 | 14 | 14 | 10 |  | Пришло
53 | DD5, DD6 | MT25QU02GCBB8E12-0SIT | _(Micron Technology) | 2 | 4 | MT25QU02GCBB8E12-0SIT |  | 0 | 4 | 4 | 4 |  | Пришло
54 | DD7 | XC7Z030-1FFG676I | _(Xilinx) | 1 | 2 | XC7Z030-1FFG676I |  | 3 | 0 | 3 | 2 |  | Пришло
55 | DD9, DD25, DD46 | TMP112AIDRLR | _(Texas Instruments) | 3 | 6 | TMP112AIDRLR |  | 12 | 0 | 12 | 6 |  | Пришло
56 | DD10 | HMC7044LP10BETR | PLL HMC7044LP10BETR Analog Devices | 1 | 2 | HMC7044LP10BETR |  | 3 | 0 | 3 | 2 |  | Пришло
57 | DD11, DD12, DD13, DD14, DD27, DD32, DD33 | TPS54622RHLR | _(Texas Instruments) | 7 | 14 | TPS54622RHLR |  | 3 | 0 | 3 | 14 |  | Пришло частично | Ожидаем поставку с Aliexpress 20шт
58 | DD16, DD17, DD18, DD19, DD20 | 74AVC4T774GUX | Supply Transceiver 74AVC4T774GUX Nexperia | 5 | 10 | 74AVC4T774GUX |  | 13 | 0 | 13 | 10 |  | Пришло
59 | DD21, DD22, DD23, DD24, DD28, DD29, DD30 | ADP2384ACPZN-R7 | _(Analog Device) | 7 | 14 | ADP2384ACPZN-R7 |  | 22 | 2 | 21 | 14 |  | Пришло
60 | DD26 | ADP2370ACPZ-1.8-R7 | _(Analog Devices) | 1 | 2 | ADP2370ACPZ-1.8-R7 |  | 6 | 0 | 0 | 2 |  | Заказано, не пришло
61 | DD34, DD37 | MCP2562FD-E/SN | _(Microchip Technology) | 2 | 4 | MCP2562FD-E/SN |  | 8 | 0 | 8 | 4 |  | Пришло
62 | DD35 | STM32H745IIT6 | _(STMicroelectronics) | 1 | 2 | STM32H745IIT6 |  | 5 | 0 | 0 | 2 |  | Заказано, не пришло
63 | DD36 | 93LC56A-I/SN | _(Microchip) | 1 | 2 | 93LC56A-I/SN |  | 0 | 3 | 3 | 2 |  | Пришло
64 | DD38 | FT4232HL | _(FTDI) | 1 | 2 | FT4232HL |  | 3 | 0 | 0 | 2 |  | Заказано, не пришло
65 | DD39 | MAX232ECDR | _(Texas Instruments) | 1 | 2 | MAX232ECDR |  | 22 | 0 | 19 | 2 |  | Пришло
66 | DD40 | SN65C1168EMPWSEP | _(Texas Instruments) | 1 | 2 | SN65C1168EPWR |  | 3 | 0 | 3 | 2 |  | Пришло
67 | DD47 | Bazalt-SBIS_MPW4_subst_v1 | Bazalt-SBIS_MPW4_subst_v1 | 1 | 2 | K5119ПВ1Я |  | 0 | 0 | 3 | 2 |  | Пришло
68 | DD48 | IS43TR16512B-125KBL | _(ISSI) | 1 | 2 | IS43TR16512B-125KBL |  | 11 | 0 | 0 | 2 |  | Заказано, не пришло
69 | G1 | ASEM1-25.000MHZ-LC-T | _(Abracon) | 1 | 2 | ASEM1-25.000MHZ-LC-T |  | 6 | 0 | 3 | 2 |  | Пришло
70 | G2 | ASEMB-50.000MHZ-LC-T | _(Abracon) | 1 | 2 | ASEMB-50.000MHZ-LC-T |  | 0 | 6 | 6 | 2 |  | Пришло | Получен в ЧиД (6 шт). ASEM1-50 от ГК (3 шт) в новом BOM не используется
71 | G3 | DSC1123CI2-100.0000 | _(Microcip) | 1 | 2 | DSC1123CI2-100.0000 |  | 3 | 0 | 3 | 2 |  | Пришло
72 | G4 | ABLNO-V-100.000MHZ-T2 | Generator ABLNO-V-100.000MHZ-T2 Abracon | 1 | 2 | ABLNO-V-100.000MHZ-T2 |  | 3 | 0 | 3 | 2 |  | Пришло
73 | L1, L2, L20, L21, L22, L23 | BLM18SG121TN1D | 0.025 Ohms 25% 3А 0603_(Murata) | 6 | 12 | BLM18SG121TN1D |  | 0 | 28 | 28 | 12 |  | Пришло
74 | L3, L13, L18 | XAL6060-682MEB | 6,8 мкГн 20% 9 А_(Coilcraft) | 3 | 6 | XAL6060-682MEB |  | 8 | 0 | 8 | 6 |  | Пришло
75 | L4, L5, L6, L10, L15, L19 | XAL4030-472MEC | 4,7 мкГн 20% 5,1А 1616_(Coilcraft) | 6 | 12 | XAL4030-472MEC |  | 13 | 0 | 13 | 12 |  | Пришло
76 | L7, L8, L9, L14, L16 | IHLP2020ABER2R2M01 | 2,2 мкГн 20% 3,4А 2020 _(Vishay) | 5 | 10 | IHLP2020ABER2R2M01 |  | 16 | 0 | 16 | 10 |  | Пришло
77 | L12 | XAL4030-682MEC | 6,8 мкГн 20% 3,9А 1616_(Coilcraft) | 1 | 2 | XAL4030-682MEC |  | 3 | 0 | 3 | 2 |  | Пришло
78 | L24, L25, L26, L27, L28, L29, L30, L31 | LQW15CA1R0K00D | 1 мкГн 10% 180мА 0402_(Murata) | 8 | 16 | MLZ1005M1R0WT000 | LQW15CA1R0K00D | 21 | 23 | 44 | 16 |  | Пришло | MLZ1005M1R0WT000 (ГК, 21) + оригинал (ЧиД, 23)
79 | L32, L33, L34, L35, L36, L37 | BLM15PX330SZ1D | 22 мОм 25% 3А 0402_(Murata) | 6 | 12 | BLM15PX330SZ1D |  | 0 | 17 | 17 | 12 |  | Пришло
80 | R1, R2, R4, R5, R6, R18, R19, R20, R21, R131, R132, R133, R134, R135, R136, R137, R138, R139, R140, R141, R142, R143, R144, R145, R147, R148, R149, R150, R151, R152, R153, R154, R155, R157, R158, R159, R160, R161, R164, R180, R321, R322, R324, R328, R329, R333, R335, R339, R340, R341, R342, R343, R349, R350, R351, R352, R353, R354, R355, R356, R357, R358, R359, R360, R397, R398, R422, R423, R424, R425 | CR0603-J/-000ELF | 0 Ом 1% 0,1Вт 0603_(Bourns) | 70 | 140 | CR0603-J/-000ELF |  | 147 | 0 | 147 | 140 |  | Пришло
81 | R3 | Не устанавливать 0603 | Резистор Не устанавливаем 0603 | 1 | 2 | Не устанавливать 0603 |  | 0 | 0 | 0 | 2 | Не устанавливается | Не устанавливается
82 | R7, R8, R9, R16, R17, R49, R50, R52, R61, R236, R280, R388, R399 | RC0402FR-074K7L | 4,7 кОм 1% 0,063Вт 0402_(Yageo) | 13 | 26 | RC0402FR-074K7L |  | 82 | 0 | 82 | 38 |  | Пришло
83 | R10, R100 | RT0402FRE076K04L | 6,04 кОм 1% 0,063Вт 0402_(Yageo) | 2 | 4 | RT0402FRE076K04L |  | 53 | 0 | 53 | 4 |  | Пришло
84 | R11, R12, R13, R14, R51, R53 | RT0603BRE07330RL | 330 Ом 0,1% 0,1Вт 0603_(Yageo) | 6 | 12 | RT0603BRE07330RL |  | 69 | 0 | 69 | 12 |  | Пришло
85 | R15, R91, R92, R106, R110, R219, R239, R287, R288 | ERJ3EKF1003V | 100 кОм 1% 0,1Вт 0603_(Panasonic Industry) | 9 | 18 | ERJ3EKF1003V |  | 74 | 0 | 74 | 18 |  | Пришло
86 | R22, R108, R294, R400, R401, R426 | RC0603FR-074K75L | 4,75 кОм 1% 0,1Вт 0603_(Yageo) | 6 | 12 | RC0402FR-074K7L |  | 82 | 0 | 82 | 38 |  | Пришло | Замена RC0402FR-074K7L
87 | R23, R24, R79, R86, R130, R156, R162, R163, R320 | ERJ2RKF5100X | 510 Ом 1% 0,063Вт 0402_(Panasonic) | 9 | 18 | ERJ2RKF5100X |  | 58 | 0 | 58 | 18 |  | Пришло
88 | R25, R57 | RT0402BRD0733RL | 33 Ом 0,1% 0,063Вт 0402_(Yageo) | 2 | 4 | RT0402BRD0733RL |  | 80 | 0 | 80 | 4 |  | Пришло
89 | R26, R27, R28, R29, R30, R31, R32, R33 | RT0603BRD0749R9L | 49,9 Ом 0,1% 0,1Вт 0603_(Yageo) | 8 | 16 | RT0603BRD0749R9L |  | 71 | 0 | 71 | 16 |  | Пришло
90 | R34 | RC0402FR-07240RL | 240 Ом 1% 62,5 мВт 0402_(Yageo) | 1 | 2 | RC0402FR-07240RL |  | 53 | 0 | 53 | 2 |  | Пришло
91 | R35, R36 | RC0402JR-0775RL | 75 Ом 5% 0,063Вт 0402_(Yageo) | 2 | 4 | RC0402JR-0775RL |  | 56 | 0 | 56 | 4 |  | Пришло
92 | R37, R38, R54, R56, R62, R63, R64, R65, R66, R67, R68, R69, R70, R71, R74, R75, R76, R87, R88, R209, R213, R215, R217, R250, R252, R253, R265, R266, R272, R278, R281, R305, R306, R313, R314, R315, R325, R327, R331, R332, R361, R362, R363, R364 | RC0402FR-070RL | 0 Ом 1% 0,063Вт 0402_(Yageo) | 44 | 88 | RC0402FR-070RL |  | 149 | 0 | 149 | 88 |  | Пришло
93 | R39, R40 | Не устанавливаем | Резистор Не устанавливаем 0402 | 2 | 4 | Не устанавливаем |  | 0 | 0 | 0 | 4 | Не устанавливается | Не устанавливается
94 | R41, R42, R43, R44, R45, R46 | RC0402FR-0722RL | 22 Ом 1% 0,062Вт 0402_(Yageo) | 6 | 12 | RC0402FR-0722RL |  | 66 | 0 | 66 | 12 |  | Пришло
95 | R47, R48 | CR0402-JW-101GLF | 100 Ом 5% 0,063Вт 0402_(Bourns) | 2 | 4 | RC0402JR-07100RL |  | 6 | 0 | 6 | 4 |  | Пришло
96 | R55 | RC0402FR-07200RL | 200 Ом 1% 0,063Вт 0402_(Yageo) | 1 | 2 | RC0402FR-07200RL |  | 56 | 0 | 56 | 2 |  | Пришло
97 | R58, R59, R60, R233, R234, R235, R385, R386, R387 | RC0402FR-075K1L | 5,1 кОм 1% 0,063Вт 0402_(Yageo) | 9 | 18 | RC0402FR-075K1L |  | 79 | 0 | 79 | 18 |  | Пришло
98 | R72, R73, R78, R80, R101, R104, R113, R115, R117, R118, R119, R120, R121, R122, R123, R124, R125, R126, R127, R128, R129, R146, R165, R166, R167, R168, R169, R170, R171, R172, R173, R174, R175, R176, R177, R178, R179, R181, R182, R183, R184, R185, R186, R187, R188, R189, R190, R191, R192, R193, R194, R195, R196, R197, R198, R199, R204, R205, R206, R207, R224, R225, R226, R228, R237, R242, R247, R248, R249, R275, R282, R297, R298, R299, R302, R326, R330, R337, R344, R377, R378, R379, R380, R381, R382, R383, R384, R410, R417 | RC0603FR-0710KL | 10 кОм 1% 0,1Вт 0603_(Yageo) | 89 | 178 | RC0603FR-0710KL |  | 84 | 95 | 179 | 178 |  | Пришло
99 | R77 | RC0402FR-073K3L | 3,3 кОм 1% 0,063Вт 0402_(Yageo) | 1 | 2 | RC0402FR-073K3L |  | 53 | 0 | 53 | 2 |  | Пришло
100 | R81 | RC0402FR-1356R2L | 56,2 Ом 1% 0,063Вт 0402_(Yageo) | 1 | 2 | RC0402FR-1356R2L |  | 53 | 0 | 53 | 2 |  | Пришло
101 | R82, R83 | RC0201FR-070RL | 0 Ом 1% 50мВт 0201_(YAGEO) | 2 | 4 | RC0201FR-070RL |  | 141 | 0 | 141 | 4 |  | Пришло
102 | R84, R85, R97, R259, R260, R307, R309 | RT0402BRE071K5L | 1,5 кОм 0,1% 0,063Вт 0402_(Yageo) | 7 | 14 | RT0402BRE071K5L |  | 63 | 0 | 63 | 14 |  | Пришло
103 | R89, R90, R105, R109, R238, R284, R285 | RC0402FR-1337K4L | 37,4 кОм 1% 0,063Вт 0402_(Yageo) | 7 | 14 | RC0402FR-1337K4L |  | 71 | 0 | 71 | 14 |  | Пришло
104 | R93, R99, R240, R261, R262, R289, R310, R312 | CRCW04021K87FKED | 1,87 кОм 1% 0,063Вт 0402_(Vishay) | 8 | 16 | CRCW04021K87FKED |  | 63 | 0 | 63 | 16 |  | Пришло
105 | R94, R111, R114, R304 | RC0603FR-076K8P | 6,8 кОм 1% 0,1Вт 0603_(Yageo) | 4 | 8 | RC0603FR-076K8P |  | 58 | 0 | 58 | 8 |  | Пришло
106 | R95, R96, R107, R112, R241, R292, R293 | RC0402FR-1391KL | 91 кОм 1% 0,063Вт 0402_(Yageo) | 7 | 14 | RC0402FR-1391KL |  | 71 | 0 | 71 | 14 |  | Пришло
107 | R98 | RT0603BRE0711K8L | 11,8 кОм 1% 0,1Вт 0603_(Yageo) | 1 | 2 | RT0603BRE0711K8L |  | 53 | 0 | 53 | 2 |  | Пришло
108 | R102, R227, R229, R276, R336 | RT0402BRD072K21L | 2,21 кОм 0,1% 0,063Вт 0402_(Yageo) | 5 | 10 | RT0402BRD072K21L |  | 61 | 0 | 61 | 10 |  | Пришло
109 | R103, R243, R303 | RC0402BR-0720KL | 20 кОм 0,1% 0,063Вт 0402_(Yageo) | 3 | 6 | RC0402BR-0720KL |  | 63 | 0 | 63 | 6 |  | Пришло
110 | R116 | RC0603FR-0715KP | 15 кОм 1% 0,1Вт 0603_(Yageo) | 1 | 2 | RC0603FR-0715KP |  | 53 | 0 | 53 | 2 |  | Пришло
111 | R200, R201, R202, R203, R232, R244, R245, R246 | CSSH0805FTL500 | 0,5 мОм 1% 1Вт 0805_(Stackpole Electronics) | 8 | 16 | CSSH0805FTL500 |  | 71 | 0 | 71 | 16 |  | Пришло
112 | R208, R212, R214, R216, R256, R257, R258, R316, R317, R318, R319, R323, R338 | ERJ3EKF1200V | 120 Ом 1% 0,1Вт 0603_(Panasonic Industry) | 13 | 26 | ERJ3EKF1200V |  | 84 | 0 | 84 | 26 |  | Пришло
113 | R210 | RT0402BRE0733KL | 33 кОм 0,1% 0,063Вт 0402_(Yageo) | 1 | 2 | RT0402BRE0733KL |  | 53 | 0 | 53 | 2 |  | Пришло
114 | R211, R218, R255 | RC0603FR-0731K6L | 31,6 кОм 1% 0,1Вт 0603_(Yageo) | 3 | 6 | RC0603FR-0731K6L |  | 58 | 0 | 58 | 6 |  | Пришло
115 | R220 | TNPW040254K2BEED | 54,2 кОм 0,1% 0,063Вт 0402_(Vishay) | 1 | 2 | TNPW040254K2BEED |  | 53 | 0 | 53 | 2 |  | Пришло
116 | R221, R222, R223, R267, R268, R269, R345, R346, R347, R348, R373, R374, R375, R376, R411, R418 | RC0402FR-07100KL | 100 кОм 1% 0,063Вт 0402_(Yageo) | 16 | 32 | RC0402FR-07100KL |  | 66 | 0 | 66 | 32 |  | Пришло
117 | R230, R273 | TNPW060322K0BEEA | 22 кОм 0,1% 0,1Вт 0603_(Vishay) | 2 | 4 | TNPW060322K0BEEA |  | 56 | 0 | 56 | 4 |  | Пришло
118 | R231, R264, R274, R279, R300, R301, R311 | RC0603FR-073KL | 3 кОм 1% 0,1Вт 0603_(Yageo) | 7 | 14 | RC0603FR-073KL |  | 69 | 23 | 92 | 14 |  | Пришло
119 | R251, R254 | RC0603FR-1347KL | 47 кОм 1% 0,1Вт 0603_(Yageo) | 2 | 4 | RC0603FR-1347KL |  | 58 | 0 | 58 | 4 |  | Пришло
120 | R263, R277, R295, R296, R308, R334 | RC0603FR-0712KP | 12 кОм 1% 0,1Вт 0603_(Yageo) | 6 | 12 | RC0603FR-0712KP |  | 53 | 0 | 53 | 12 |  | Пришло
121 | R270 | RT0603BRE0747K5L | 47,5 кОм 0,1% 0,1Вт 0603_(Yageo) | 1 | 2 | RT0603BRE0747K5L |  | 53 | 0 | 53 | 2 |  | Пришло
122 | R271 | RT0603BRD0715KL | 15 кОм 0,1% 0,1Вт 0603_(Yageo) | 1 | 2 | RT0603BRD0715KL |  | 53 | 0 | 53 | 2 |  | Пришло
123 | R283, R286, R408, R415 | RC0603FR-0757R6L | 57,6 Ом 1% 0,1Вт 0603_(Yageo) | 4 | 8 | RC0603FR-0757R6L |  | 0 | 0 | 16 | 8 |  | Пришло
124 | R290, R291, R403, R405, R409, R413, R416, R419 | RC0603FR-07174RL | 174 Ом 1% 0,1 Вт 0603 _(Yageo) | 8 | 16 | RC0603FR-07174RL |  | 0 | 0 | 16 | 16 |  | Пришло
125 | R365, R366, R367, R368, R369, R370, R371, R372, R389, R390, R391, R392, R393, R394, R395, R396 | CRCW020149R9FNED | 49,9 Ом 1% 0,063Вт 0201_(Vishay) | 16 | 32 | CRCW020149R9FNED |  | 100 | 0 | 100 | 32 |  | Пришло
126 | R402, R404, R406, R407, R412, R414, R420, R421 | RC0603FR-074R7L | 4,7 Ом 1% 0,1Вт 0603_(Yageo) | 8 | 16 | RC0603FR-074R7L |  | 0 | 0 | 30 | 16 |  | Пришло
127 | T1 | PT61020EL | _(Bourns) | 1 | 2 | PT61020EL |  | 3 | 0 | 3 | 2 |  | Пришло
128 | T2, T3, T4, T5, T6, T7, T8, T9, T10, T11, T12 | TCM2-33WX+ | RF Transformer TCM2-33WX+ Mini-Circuits | 11 | 22 | TCM2-33WX+ |  | 0 | 20 | 20 | 22 |  | Пришло частично | 2 шт не хватает
129 | VD1, VD2, VD3, VD4, VD7, VD8, VD9, VD10 | SML-P11MTT86R | _(ROHM Semiconductors) | 8 | 16 | SML-P11MTT86R |  | 24 | 0 | 24 | 16 |  | Пришло
130 | VD5, VD6 | SML-P11UTT86R | _(Semiconductors) | 2 | 4 | SML-P11UTT86R |  | 6 | 0 | 6 | 4 |  | Пришло
131 | VD11, VD12 | PESD2CAN215 | _(Nexperia) | 2 | 4 | PESD2CAN215 |  | 6 | 0 | 6 | 4 |  | Пришло
132 | VD13, VD14, VD15, VD16, VD17, VD18 | PESD3V3L2BT | _(Nexperia) | 6 | 12 | PESD3V3L2BT |  | 16 | 0 | 0 | 12 |  | Заказано, не пришло
133 | X1 | 17 21 110 2102 | _(Harting) | 1 | 2 | 17 21 110 2102 |  | 0 | 0 | 3 | 2 |  | Пришло
134 | X2, X3 | 17 24 110 2102 | _(Harting) | 2 | 4 | 5352152-1 |  | 6 | 0 | 6 | 4 |  | Пришло
135 | X4, X6, X7, X13, X43 | PLS-2 | PLS-2 | 5 | 10 | DS1021-1x4SF11-B |  | 50 | 0 | 50 | 16 |  | Пришло
136 | X5, X22, X40 | PLS-3 | PLS-3 | 3 | 6 | DS1021-1x4SF11-B |  | 50 | 0 | 50 | 16 |  | Пришло
137 | X8, X11 | 5103308-1 | _(TE Connectivity) | 2 | 4 | 5103308-1 |  | 6 | 0 | 6 | 4 |  | Пришло
138 | X9 | 09 35 002 2102 | _(Harting) | 1 | 2 | TJ8P8C (DS1125) |  | 0 | 0 | 0 | 2 | Заказано, не пришло | Заказано, не пришло | заказано на ЧиД 3шт
139 | X10 | 500901-0801 | _(Molex) | 1 | 2 | 500901-0801 |  | 0 | 3 | 3 | 2 |  | Пришло
140 | X12, X20, X21, X23, X24, X25, X26, X35, X36, X37, X38 | SMA-J-P-H-ST-TH1 | _(Samtec) | 11 | 22 | SMA-KWE-14.5 |  | 0 | 0 | 0 | 22 | Заказано, не пришло | Заказано, не пришло | заменен на угловой разъем SMA-KWE-14.5, заказано на Aliexpress 15 шт
141 | X14, X15, X16, X17, X18, X19, X27, X28, X29, X30, X31, X32, X33, X34 | S0991-46R | _( Harwin) | 14 | 28 | S0991-46R |  | 37 | 0 | 37 | 28 |  | Пришло
142 | X39 | DS1095-06-BNR0 | _(Zhenqin) | 1 | 2 | DS1095-06-BNR0 |  | 3 | 0 | 3 | 2 |  | Пришло
143 | X41, X42 | 640445-2 | _(TE Connectivity) | 2 | 4 | 640445-2 |  | 0 | 10 | 10 | 4 |  | Пришло
144 | X44, X45 | 47053-1000 | _(Molex) | 2 | 4 | 47053-1000 |  | 0 | 0 | 0 | 4 | Заказано, не пришло | Заказано, не пришло | заказано на ЧиД 4шт
146 | Z1, Z13, Z14, Z15, Z16, Z17, Z18, Z19, Z20, Z23, Z24, Z25 | BLM18SN220TN1D | 22 Ом 25% 8А 0603_(Murata) | 12 | 24 | BLM18SN220TN1D |  | 19 | 0 | 0 | 24 |  | Заказано, не пришло
147 | Z2, Z4, Z5, Z6, Z7, Z8, Z9, Z10, Z11, Z12 | MI0603M121R-10 | 120 Ом 2,5А 0603_(Laird Performance Materials) | 10 | 20 | MI0603M121R-10 |  | 37 | 0 | 37 | 20 |  | Пришло
148 | Z3 | BLM31PG330SZ1L | 9 мОм 25% 6А 1206_(Murata) | 1 | 2 | BLM31PG330SZ1L |  | 6 | 0 | 6 | 2 |  | Пришло
149 | Z21, Z22 | BLM18AG102SN1D | 500 mOhms 25% 400 mА 0603_(Murata) | 2 | 4 | BLM18AG102SN1D |  | 6 | 0 | 6 | 4 |  | Пришло
150 | ZQ1 | NX3225HA-25MHz-EXS00A-CH00343 | _(NDK) | 1 | 2 | NX3225HA-25MHZ |  | 3 | 0 | 3 | 2 |  | Пришло
151 | ZQ2 | 7U-12.000-12-30-80-C-50 | _(SJK) | 1 | 2 | 7U-12.000-12-30-80-C-50 |  | 0 | 3 | 3 | 2 |  | Пришло
152 | ZQ3 | NX3215SA-32.768KHZ-EXS00A-MU00525 | _(NDK) | 1 | 2 | NX3215SA |  | 10 | 0 | 5 | 2 |  | Пришло

Sheet: Накладные
Документ | Договор / счёт | № п/п | P/N | Кол-во, шт | Есть в BOM?
УПД 2298/611392 от 14.09.2026 | 62100 | 1 | GRM155R71C104JA88D | 336 | да
УПД 2298/611392 от 14.09.2026 | 62100 | 2 | CC0603BRNPO9BN3R9 | 46 | да
УПД 2298/611392 от 14.09.2026 | 62100 | 3 | GRM155R71C104KA88D | 485 | да
УПД 2298/611392 от 14.09.2026 | 62100 | 4 | GRM155R61C103KA01D | 102 | да
УПД 2298/611392 от 14.09.2026 | 62100 | 5 | CL10B475KQ8NQNC | 46 | да
УПД 2298/611392 от 14.09.2026 | 62100 | 6 | GCM1555C1H180FA16D | 33 | да
УПД 2298/611392 от 14.09.2026 | 62100 | 7 | CC0402JRX7R9BB561 | 33 | да
УПД 2298/611392 от 14.09.2026 | 62100 | 8 | CC0603KRX5R7BB106 | 54 | да
УПД 2298/611392 от 14.09.2026 | 62100 | 9 | GRM188R61E475KE11D | 43 | НЕТ
УПД 2298/611392 от 14.09.2026 | 62100 | 10 | GRM21BR60J107ME15L | 82 | да
УПД 2298/611392 от 14.09.2026 | 62100 | 11 | CC0603JRX7R7BB104 | 41 | да
УПД 2298/611392 от 14.09.2026 | 62100 | 12 | GRT155R71A474KE01D | 36 | да
УПД 2298/611392 от 14.09.2026 | 62100 | 13 | GRM32ER61E226KE15L | 36 | да
УПД 2298/611392 от 14.09.2026 | 62100 | 14 | GRM155R61E474KE01D | 93 | да
УПД 2298/611392 от 14.09.2026 | 62100 | 15 | GRM155R71E103JA01D | 41 | да
УПД 2298/611392 от 14.09.2026 | 62100 | 16 | GRM033R61C104KE84D | 114 | да
УПД 2298/611392 от 14.09.2026 | 62100 | 17 | GRM033R71C103KE14D | 36 | да
УПД 2298/611392 от 14.09.2026 | 62100 | 18 | GRM033R71E102KA01D | 62 | НЕТ
УПД 2298/611392 от 14.09.2026 | 62100 | 19 | CC0402GRNPO9BN101 | 38 | НЕТ
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
В рабочем порядке чип и дип | - | 2 | RC0603FR-0757R6L | 16 | да
В рабочем порядке чип и дип | - | 3 | RC0603FR-07174RL | 16 | да
В рабочем порядке DS | - | 4 | K5119ПВ1Я | 3 | да
В рабочем порядке со склада кб | - | 5 | 17 21 110 2102 | 3 | да

Sheet: Заказы
Поставщик | Договор / счёт | Документ | № стр. | P/N | Наименование | Заказано, шт | Пришло по этому договору, шт | Не пришло, шт | Есть в BOM?
ГК Снабжение | 62100 | Спецификация №1 к дог. 62100 от 28.07.2026 (= перечень давальческого сырья) | 1 | 594D108X06R3R2T | 594D108X06R3R2T 1 мФ 20% Тант. 6.3 В 2812 VISHAY SPRAGUE Конденсатор | 43 | 43 | 0 | НЕТ
ГК Снабжение | 62100 | Спецификация №1 к дог. 62100 от 28.07.2026 (= перечень давальческого сырья) | 2 | GRM155R71C104JA88D | GRM155R71C104JA88D Murata Конденсатор | 155 | 336 | 0 | да
ГК Снабжение | 62100 | Спецификация №1 к дог. 62100 от 28.07.2026 (= перечень давальческого сырья) | 3 | CC0603BRNPO9BN3R9 | CC0603BRNPO9BN3R9 3,9 пФ 0.1 пФ NP0 50В 0603 Yageo Конденсатор | 46 | 46 | 0 | да
ГК Снабжение | 62100 | Спецификация №1 к дог. 62100 от 28.07.2026 (= перечень давальческого сырья) | 4 | CC0201CPNPO9BN1R5 | CC0201CPNPO9BN1R5 1,5 пФ 0.25 пФ NP0 50В 0603 Yageo Конденсатор | 36 | 36 | 0 | да
ГК Снабжение | 62100 | Спецификация №1 к дог. 62100 от 28.07.2026 (= перечень давальческого сырья) | 5 | GRM188C81C225KA12D | GRM188C81C225KA12D 2,2 мкФ 10% X6S 16В 0603 Murata Конденсатор | 38 | 38 | 0 | да
ГК Снабжение | 62100 | Спецификация №1 к дог. 62100 от 28.07.2026 (= перечень давальческого сырья) | 6 | GRM155R71C104KA88D | GRM155R71C104KA88D 0,1 мкФ 10% X7R 16В 0402 Murata Конденсатор | 485 | 485 | 0 | да
ГК Снабжение | 62100 | Спецификация №1 к дог. 62100 от 28.07.2026 (= перечень давальческого сырья) | 7 | GRM155R61C103KA01D | GRM155R61C103KA01D 0,01 мкФ 10% X5R 16В 0402, мин. 102 шт. Murata Конденсатор | 102 | 102 | 0 | да
ГК Снабжение | 62100 | Спецификация №1 к дог. 62100 от 28.07.2026 (= перечень давальческого сырья) | 8 | CL10B475KQ8NQNC | CL10B475KQ8NQNC 4,7 мкФ 10% X7R 6,3В 0603 Samsung Конденсатор | 46 | 46 | 0 | да
ГК Снабжение | 62100 | Спецификация №1 к дог. 62100 от 28.07.2026 (= перечень давальческого сырья) | 9 | GCM1555C1H180FA16D | GCM1555C1H180FA16D 18 пФ 1% C0G 50В 0402 Murata Конденсатор | 33 | 33 | 0 | да
ГК Снабжение | 62100 | Спецификация №1 к дог. 62100 от 28.07.2026 (= перечень давальческого сырья) | 10 | GRM155R71C104JA88D | GRM155R71C104JA88D 0,1 мкФ 5% X7R 16В 0402 Murata Конденсатор | 181 | 336 | 0 | да
ГК Снабжение | 62100 | Спецификация №1 к дог. 62100 от 28.07.2026 (= перечень давальческого сырья) | 11 | CC0402JRX7R9BB561 | CC0402JRX7R9BB561 560 пФ 5% X7R 50В 0402 Yageo Конденсатор | 33 | 33 | 0 | да
ГК Снабжение | 62100 | Спецификация №1 к дог. 62100 от 28.07.2026 (= перечень давальческого сырья) | 12 | CC0603KRX5R7BB106 | CC0603KRX5R7BB106 10 мкФ 10% X5R 16В 0603 Yageo Конденсатор | 54 | 54 | 0 | да
ГК Снабжение | 62100 | Спецификация №1 к дог. 62100 от 28.07.2026 (= перечень давальческого сырья) | 13 | GRM188R61E475KE11D | GRM188R61E475KE11D 4,7 мкФ 10% X5R 25В 0603 Murata Конденсатор | 43 | 43 | 0 | НЕТ
ГК Снабжение | 62100 | Спецификация №1 к дог. 62100 от 28.07.2026 (= перечень давальческого сырья) | 14 | GRM21BR60J107ME15L | GRM21BR60J107ME15L 100 мкФ 20% X5R 6,3В 0805 Murata Конденсатор | 82 | 82 | 0 | да
ГК Снабжение | 62100 | Спецификация №1 к дог. 62100 от 28.07.2026 (= перечень давальческого сырья) | 15 | GMC10X7R105J16NT | GMC10X7R105J16NT 1 мкФ 5% X7R 16V 0603, мин. 50 шт. CAL-CHIP ELECTRONICS Конденсатор | 50 | 50 | 0 | да
ГК Снабжение | 62100 | Спецификация №1 к дог. 62100 от 28.07.2026 (= перечень давальческого сырья) | 16 | CC0603JRX7R7BB104 | CC0603JRX7R7BB104 0,1 мкФ 5% X7R 16В 0603 Yageo Конденсатор | 41 | 41 | 0 | да
ГК Снабжение | 62100 | Спецификация №1 к дог. 62100 от 28.07.2026 (= перечень давальческого сырья) | 17 | GRT155R71A474KE01D | GRT155R71A474KE01D Murata Конденсатор | 36 | 36 | 0 | да
ГК Снабжение | 62100 | Спецификация №1 к дог. 62100 от 28.07.2026 (= перечень давальческого сырья) | 18 | GRM32ER61E226KE15L | GRM32ER61E226KE15L 22 мкФ 10% X5R 25В 0603 Murata Конденсатор | 36 | 36 | 0 | да
ГК Снабжение | 62100 | Спецификация №1 к дог. 62100 от 28.07.2026 (= перечень давальческого сырья) | 19 | GRM155R61E474KE01D | GRM155R61E474KE01D 0,47 мкФ 10% X5R 25В 0402 Murata Конденсатор | 93 | 93 | 0 | да
ГК Снабжение | 62100 | Спецификация №1 к дог. 62100 от 28.07.2026 (= перечень давальческого сырья) | 20 | GRM155R71E103JA01D | GRM155R71E103JA01D Murata Конденсатор | 41 | 41 | 0 | да
ГК Снабжение | 62100 | Спецификация №1 к дог. 62100 от 28.07.2026 (= перечень давальческого сырья) | 21 | GRM033R61C104KE84D | GRM033R61C104KE84D 0,1 мкФ 10% X5R 16В 0201 Murata Конденсатор | 114 | 114 | 0 | да
ГК Снабжение | 62100 | Спецификация №1 к дог. 62100 от 28.07.2026 (= перечень давальческого сырья) | 22 | GRM033R71C103KE14D | GRM033R71C103KE14D 0,01 мкФ Cap 0201 X7R 16 В Murata Конденсатор | 36 | 36 | 0 | да
ГК Снабжение | 62100 | Спецификация №1 к дог. 62100 от 28.07.2026 (= перечень давальческого сырья) | 23 | GRM033R71E102KA01D | GRM033R71E102KA01D Murata Конденсатор | 62 | 62 | 0 | НЕТ
ГК Снабжение | 62100 | Спецификация №1 к дог. 62100 от 28.07.2026 (= перечень давальческого сырья) | 24 | CC0402GRNPO9BN101 | CC0402GRNPO9BN101 Yageo Конденсатор | 38 | 38 | 0 | НЕТ
ГК Снабжение | 62100 | Спецификация №1 к дог. 62100 от 28.07.2026 (= перечень давальческого сырья) | 25 | GCM155R71H102KA37D | GCM155R71H102KA37D 0,001 мкФ Cap 0402 NPO 50 В Murata Конденсатор | 33 | 33 | 0 | да
ГК Снабжение | 62100 | Спецификация №1 к дог. 62100 от 28.07.2026 (= перечень давальческого сырья) | 26 | GRM155R61C473JA01J | GRM155R61C473JA01J 4,7 мкФ Cap 0402 X5R 16 В Murata Конденсатор | 108 | 108 | 0 | НЕТ
ГК Снабжение | 62100 | Спецификация №1 к дог. 62100 от 28.07.2026 (= перечень давальческого сырья) | 27 | GRM033R6YA104KE14D | GRM033R6YA104KE14D 0,1 мкФ Cap 0201 X7R 16 В Murata Конденсатор | 140 | 140 | 0 | НЕТ
ГК Снабжение | 62100 | Спецификация №1 к дог. 62100 от 28.07.2026 (= перечень давальческого сырья) | 28 | CC0603KRX5R7BB475 | CC0603KRX5R7BB475 4,7 мкФ 10% X5R 16В 0603 Yageo Конденсатор | 51 | 51 | 0 | да
ГК Снабжение | 62100 | Спецификация №1 к дог. 62100 от 28.07.2026 (= перечень давальческого сырья) | 29 | GMC10X5R226M16NT | GMC10X5R226M16NT CAL-CHIP ELECTRONICS Конденсатор | 67 | 67 | 0 | да
ГК Снабжение | 62100 | Спецификация №1 к дог. 62100 от 28.07.2026 (= перечень давальческого сырья) | 30 | CC0603JRX7R7BB474 | CC0603JRX7R7BB474 0,47 мкФ 5% X7R 16В 0603 Yageo Конденсатор | 43 | 43 | 0 | НЕТ
ГК Снабжение | 62100 | Спецификация №1 к дог. 62100 от 28.07.2026 (= перечень давальческого сырья) | 31 | GCM1885C1H112GA16D | GCM1885C1H112GA16D 1100 пФ 2% NP0 50В 0603 Murata Конденсатор | 43 | 43 | 0 | НЕТ
ГК Снабжение | 62100 | Спецификация №1 к дог. 62100 от 28.07.2026 (= перечень давальческого сырья) | 32 | GRT1885C1E103FA02D | GRT1885C1E103FA02D 10 нФ 1% NP0 25В 0603 Murata Конденсатор | 62 | 62 | 0 | да
ГК Снабжение | 62100 | Спецификация №1 к дог. 62100 от 28.07.2026 (= перечень давальческого сырья) | 33 | GRM188R60J226MEA0D | GRM188R60J226MEA0D 22 мкФ 20% X5R 6,3В 0603 Murata Конденсатор | 82 | 82 | 0 | да
ГК Снабжение | 62100 | Спецификация №1 к дог. 62100 от 28.07.2026 (= перечень давальческого сырья) | 34 | GRM155R61C333KA01D | GRM155R61C333KA01D 0,033 мкФ 10% X5R 16В 0402 Murata Конденсатор | 38 | 38 | 0 | да
ГК Снабжение | 62100 | Спецификация №1 к дог. 62100 от 28.07.2026 (= перечень давальческого сырья) | 35 | CC0201FRNPO9BN330 | CC0201FRNPO9BN330 33 пФ 1% NP0 50В 0201 Yageo Конденсатор | 38 | 38 | 0 | да
ГК Снабжение | 62100 | Спецификация №1 к дог. 62100 от 28.07.2026 (= перечень давальческого сырья) | 36 | GRM188R60J476ME15D | GRM188R60J476ME15D 47 мкФ 20% X5R 6,3В 0603 Murata Конденсатор | 49 | 49 | 0 | да
ГК Снабжение | 62100 | Спецификация №1 к дог. 62100 от 28.07.2026 (= перечень давальческого сырья) | 37 | 194D105X5015B2B | 194D105X5015B2B 1 мкФ 5% Тант. 15В Case"B" VISHAY Конденсатор | 36 | 36 | 0 | да
ГК Снабжение | 62100 | Спецификация №1 к дог. 62100 от 28.07.2026 (= перечень давальческого сырья) | 38 | GRM155R61H474KE11D | GRM155R61H474KE11D 4,7 мкФ 10% X5R 50В 0402 Murata Конденсатор | 64 | 64 | 0 | да
ГК Снабжение | 62100 | Спецификация №1 к дог. 62100 от 28.07.2026 (= перечень давальческого сырья) | 39 | 293D475X9016A2TE3 | 293D475X9016A2TE3 4,7 мкФ 10% Тант. 16В 1206 VISHAY Конденсатор | 33 | 23 | 10 | да
ГК Снабжение | 62100 | Спецификация №1 к дог. 62100 от 28.07.2026 (= перечень давальческого сырья) | 40 | C2012X7R1A475K125AC | C2012X7R1A475K125AC 4,7 мкФ 10% X7R 10В 0805 TDK Конденсатор | 36 | 36 | 0 | да
ГК Снабжение | 62100 | Спецификация №1 к дог. 62100 от 28.07.2026 (= перечень давальческого сырья) | 41 | GRM188R61E106KA73D | GRM188R61E106KA73D 10 мкФ 10% X5R 25В 0603 Murata Конденсатор | 69 | 69 | 0 | да
ГК Снабжение | 62100 | Спецификация №1 к дог. 62100 от 28.07.2026 (= перечень давальческого сырья) | 42 | 600S4R7BW250XT | 600S4R7BW250XT 4,7 пФ 0,1пФ NPO 250В 0603 KYOCERA AVX COMPONENTS Конденсатор | 33 | 33 | 0 | да
ГК Снабжение | 62100 | Спецификация №1 к дог. 62100 от 28.07.2026 (= перечень давальческого сырья) | 43 | GRM21BR61A476ME15L | GRM21BR61A476ME15L 47 мкФ 20% X5R 10В 0805 Murata Конденсатор | 67 | 103 | 0 | да
ГК Снабжение | 62100 | Спецификация №1 к дог. 62100 от 28.07.2026 (= перечень давальческого сырья) | 44 | CC0402KRX7R7BB102 | CC0402KRX7R7BB102 1000 пФ 10% X7R 16В 0402 Yageo Конденсатор | 33 | 33 | 0 | НЕТ
ГК Снабжение | 62100 | Спецификация №1 к дог. 62100 от 28.07.2026 (= перечень давальческого сырья) | 45 | GJM1555C1H6R4BB01D | GJM1555C1H6R4BB01D 6,4 пФ 0,25пФ C0G 50В 0402, мин. 60 шт. Murata Конденсатор | 60 | 60 | 0 | да
ГК Снабжение | 62100 | Спецификация №1 к дог. 62100 от 28.07.2026 (= перечень давальческого сырья) | 46 | GRM155R61H105KE05D | GRM155R61H105KE05D 1 мкФ 10% X5R 50В 0402 Murata Конденсатор | 85 | 85 | 0 | да
ГК Снабжение | 62100 | Спецификация №1 к дог. 62100 от 28.07.2026 (= перечень давальческого сырья) | 47 | CC0402KRX7R9BB223 | CC0402KRX7R9BB223 0,022 мкФ 10% X7R 50В 0402 Yageo Конденсатор | 49 | 49 | 0 | да
ГК Снабжение | 62100 | Спецификация №1 к дог. 62100 от 28.07.2026 (= перечень давальческого сырья) | 48 | GRM32ER60J107ME20L | GRM32ER60J107ME20L 100 мкФ 20% X5R 6,3В 1210 Murata Конденсатор | 43 | 43 | 0 | да
ГК Снабжение | 62100 | Спецификация №1 к дог. 62100 от 28.07.2026 (= перечень давальческого сырья) | 49 | 298D106X0016R2T | 298D106X0016R2T 10 мкФ 20% Тант. 16В 0805 VISHAY Конденсатор | 36 | 36 | 0 | да
ГК Снабжение | 62100 | Спецификация №1 к дог. 62100 от 28.07.2026 (= перечень давальческого сырья) | 50 | GRM21BR61A476ME15L | GRM21BR61A476ME15L 47 мкФ 20% X5R 10В 0805 Murata Конденсатор | 36 | 103 | 0 | да
ГК Снабжение | 62100 | Спецификация №1 к дог. 62100 от 28.07.2026 (= перечень давальческого сырья) | 51 | 600S8R2BW250XT4K | 600S8R2BW250XT4K 8,2 пФ ±0,1 пФ NPO 250В 0603 KYOCERA AVX COMPONENTS Конденсатор | 33 | 0 | 33 | НЕТ
ГК Снабжение | 62100 | Спецификация №1 к дог. 62100 от 28.07.2026 (= перечень давальческого сырья) | 52 | GCM0335C1E150FA16J | GCM0335C1E150FA16J 15 пФ 1% NP0 25В 0201 Murata Конденсатор | 33 | 33 | 0 | НЕТ
ГК Снабжение | 62100 | Спецификация №1 к дог. 62100 от 28.07.2026 (= перечень давальческого сырья) | 53 | TPS7A9201DSKR | TPS7A9201DSKR Texas Instruments Микросхема | 32 | 32 | 0 | да
ГК Снабжение | 62100 | Спецификация №1 к дог. 62100 от 28.07.2026 (= перечень давальческого сырья) | 54 | TPS54622RHLR | TPS54622RHLR Texas Instruments Микросхема | 3 | 3 | 0 | да
ГК Снабжение | 62100 | Спецификация №1 к дог. 62100 от 28.07.2026 (= перечень давальческого сырья) | 55 | TMP112AIDRLR | TMP112AIDRLR R-упаковка, мин. 12 шт. Texas Instruments Микросхема | 12 | 12 | 0 | да
ГК Снабжение | 62100 | Спецификация №1 к дог. 62100 от 28.07.2026 (= перечень давальческого сырья) | 56 | MAX232ECDR | MAX232ECDR Texas Instruments Микросхема | 19 | 19 | 0 | да
ГК Снабжение | 62100 | Спецификация №1 к дог. 62100 от 28.07.2026 (= перечень давальческого сырья) | 57 | SN65C1168EPWR | SN65C1168EPWR Texas Instruments Микросхема | 3 | 3 | 0 | да
ГК Снабжение | 62100 | Спецификация №1 к дог. 62100 от 28.07.2026 (= перечень давальческого сырья) | 58 | MCP2562FD-E/SN | MCP2562FD-E/SN Microchip Микросхема | 8 | 8 | 0 | да
ГК Снабжение | 62100 | Спецификация №1 к дог. 62100 от 28.07.2026 (= перечень давальческого сырья) | 59 | STM32H745IIT6 | STM32H745IIT6 ST Microelectronics Микросхема | 3 | 0 | 3 | да
ГК Снабжение | 62100 | Спецификация №1 к дог. 62100 от 28.07.2026 (= перечень давальческого сырья) | 60 | IS43TR16512B-125KBL | IS43TR16512B-125KBL INTEGRATED SILICON SOLUTION INC Микросхема | 11 | 0 | 11 | да
ГК Снабжение | 62100 | Спецификация №1 к дог. 62100 от 28.07.2026 (= перечень давальческого сырья) | 61 | XC7Z030-1FFG676I | XC7Z030-1FFG676I XILINX Микросхема | 3 | 3 | 0 | да
ГК Снабжение | 62100 | Спецификация №1 к дог. 62100 от 28.07.2026 (= перечень давальческого сырья) | 62 | HMC7044LP10BETR | HMC7044LP10BETR Analog Devices Микросхема | 3 | 3 | 0 | да
ГК Снабжение | 62100 | Спецификация №1 к дог. 62100 от 28.07.2026 (= перечень давальческого сырья) | 63 | SN74AVC2T45DCTR | SN74AVC2T45DCTR Texas Instruments Микросхема | 3 | 3 | 0 | НЕТ
ГК Снабжение | 62100 | Спецификация №1 к дог. 62100 от 28.07.2026 (= перечень давальческого сырья) | 64 | 74AVC4T774GUX | 74AVC4T774GUX NEXPERIA Микросхема | 13 | 13 | 0 | да
ГК Снабжение | 62100 | Спецификация №1 к дог. 62100 от 28.07.2026 (= перечень давальческого сырья) | 65 | ADP2384ACPZN-R7 | ADP2384ACPZN-R7 Analog Devices Микросхема | 19 | 19 | 0 | да
ГК Снабжение | 62100 | Спецификация №1 к дог. 62100 от 28.07.2026 (= перечень давальческого сырья) | 66 | ADP2370ACPZ-1.8-R7 | ADP2370ACPZ-1.8-R7 Analog Devices Микросхема | 3 | 0 | 3 | да
ГК Снабжение | 62100 | Спецификация №1 к дог. 62100 от 28.07.2026 (= перечень давальческого сырья) | 67 | NXS0506GU-Q100X | NXS0506GU-Q100X NEXPERIA Микросхема | 3 | 3 | 0 | НЕТ
ГК Снабжение | 62100 | Спецификация №1 к дог. 62100 от 28.07.2026 (= перечень давальческого сырья) | 68 | FT4232HL | FT4232HL FTDI Микросхема | 3 | 0 | 3 | да
ГК Снабжение | 62100 | Спецификация №1 к дог. 62100 от 28.07.2026 (= перечень давальческого сырья) | 69 | ASEM1-25.000MHZ-LC-T | ASEM1-25.000MHZ-LC-T ABRACON CORPORATION Кварцевый генератор | 3 | 3 | 0 | да
ГК Снабжение | 62100 | Спецификация №1 к дог. 62100 от 28.07.2026 (= перечень давальческого сырья) | 70 | ASEM1-50.000MHZ-LC-T | ASEM1-50.000MHZ-LC-T ABRACON CORPORATION Кварцевый генератор | 3 | 3 | 0 | НЕТ
ГК Снабжение | 62100 | Спецификация №1 к дог. 62100 от 28.07.2026 (= перечень давальческого сырья) | 71 | DSC1123CI2-100.0000 | DSC1123CI2-100.0000 Microchip Кварцевый генератор | 3 | 3 | 0 | да
ГК Снабжение | 62100 | Спецификация №1 к дог. 62100 от 28.07.2026 (= перечень давальческого сырья) | 72 | ABLNO-V-100.000MHZ-T2 | ABLNO-V-100.000MHZ-T2 Abracon Кварцевый генератор | 3 | 3 | 0 | да
ГК Снабжение | 62100 | Спецификация №1 к дог. 62100 от 28.07.2026 (= перечень давальческого сырья) | 73 | BLM18AG102SN1D | BLM18AG102SN1D Murata Индуктивность | 6 | 6 | 0 | да
ГК Снабжение | 62100 | Спецификация №1 к дог. 62100 от 28.07.2026 (= перечень давальческого сырья) | 74 | XAL6060-682MEB | XAL6060-682MEB Coilcraft Индуктивность | 8 | 8 | 0 | да
ГК Снабжение | 62100 | Спецификация №1 к дог. 62100 от 28.07.2026 (= перечень давальческого сырья) | 75 | 744771003 | 744771003 3,5 мкГн 20% 9,25А 12x12 WURTH ELEKTRONIK Индуктивность | 6 | 6 | 0 | НЕТ
ГК Снабжение | 62100 | Спецификация №1 к дог. 62100 от 28.07.2026 (= перечень давальческого сырья) | 76 | XAL4030-472MEC | XAL4030-472MEC Coilcraft Индуктивность | 13 | 13 | 0 | да
ГК Снабжение | 62100 | Спецификация №1 к дог. 62100 от 28.07.2026 (= перечень давальческого сырья) | 77 | IHLP2020ABER2R2M01 | IHLP2020ABER2R2M01 2,2 мкГн 20% 5А 2424 VISHAY Индуктивность | 16 | 16 | 0 | да
ГК Снабжение | 62100 | Спецификация №1 к дог. 62100 от 28.07.2026 (= перечень давальческого сырья) | 78 | XAL4030-682MEC | XAL4030-682MEC 6,8 мкГн 20% 3,9А 1616, возможен старый год Coilcraft Индуктивность | 3 | 3 | 0 | да
ГК Снабжение | 62100 | Спецификация №1 к дог. 62100 от 28.07.2026 (= перечень давальческого сырья) | 79 | ERJ3EKF1200V | ERJ3EKF1200V 120 Ом 1% 0,1Вт 0603 Panasonic Резистор | 84 | 84 | 0 | да
ГК Снабжение | 62100 | Спецификация №1 к дог. 62100 от 28.07.2026 (= перечень давальческого сырья) | 80 | CR0603-J/-000ELF | CR0603-J/-000ELF 0 Ом 1% 0,1Вт 0603 Bourns Резистор | 147 | 147 | 0 | да
ГК Снабжение | 62100 | Спецификация №1 к дог. 62100 от 28.07.2026 (= перечень давальческого сырья) | 81 | RC0402FR-07100RL | RC0402FR-07100RL 100 Ом 1% 0,063Вт 0402 Yageo Резистор | 61 | 61 | 0 | НЕТ
ГК Снабжение | 62100 | Спецификация №1 к дог. 62100 от 28.07.2026 (= перечень давальческого сырья) | 82 | RC0402FR-070RL | RC0402FR-070RL 0 Ом 1% 0,063Вт 0402 Yageo Резистор | 149 | 149 | 0 | да
ГК Снабжение | 62100 | Спецификация №1 к дог. 62100 от 28.07.2026 (= перечень давальческого сырья) | 83 | RC0603FR-0710KL | RC0603FR-0710KL 10 кОм 1% 0,1Вт 0603 Yageo Резистор | 84 | 84 | 0 | да
ГК Снабжение | 62100 | Спецификация №1 к дог. 62100 от 28.07.2026 (= перечень давальческого сырья) | 84 | RC0402FR-074K7L | RC0402FR-074K7L 4,7 кОм 1% 0,063Вт 0402 Yageo Резистор | 82 | 82 | 0 | да
ГК Снабжение | 62100 | Спецификация №1 к дог. 62100 от 28.07.2026 (= перечень давальческого сырья) | 85 | RT0402FRE076K04L | RT0402FRE076K04L 6,04 кОм 1% 0,063Вт 0402 Yageo Резистор | 53 | 53 | 0 | да
ГК Снабжение | 62100 | Спецификация №1 к дог. 62100 от 28.07.2026 (= перечень давальческого сырья) | 86 | RT0603BRE07330RL | RT0603BRE07330RL 330 Ом 0,1% 0,1Вт 0603 Yageo Резистор | 69 | 69 | 0 | да
ГК Снабжение | 62100 | Спецификация №1 к дог. 62100 от 28.07.2026 (= перечень давальческого сырья) | 87 | ERJ3EKF1003V | ERJ3EKF1003V 100 кОм 1% 0,1Вт 0603 Panasonic Резистор | 74 | 74 | 0 | да
ГК Снабжение | 62100 | Спецификация №1 к дог. 62100 от 28.07.2026 (= перечень давальческого сырья) | 88 | RT0603BRD0749R9L | RT0603BRD0749R9L 49,9 Ом 0,1% 0,1Вт 0603 Yageo Резистор | 71 | 71 | 0 | да
ГК Снабжение | 62100 | Спецификация №1 к дог. 62100 от 28.07.2026 (= перечень давальческого сырья) | 89 | RC0402FR-07240RL | RC0402FR-07240RL 240 Ом 1% 62,5 мВт 0402 Yageo Резистор | 53 | 53 | 0 | да
ГК Снабжение | 62100 | Спецификация №1 к дог. 62100 от 28.07.2026 (= перечень давальческого сырья) | 90 | RC0402JR-0775RL | RC0402JR-0775RL 75 Ом 5% 0,063Вт 0402 Yageo Резистор | 56 | 56 | 0 | да
ГК Снабжение | 62100 | Спецификация №1 к дог. 62100 от 28.07.2026 (= перечень давальческого сырья) | 91 | RC0402FR-07200RL | RC0402FR-07200RL 200 Ом 1% 0,063Вт 0402 Yageo Резистор | 56 | 56 | 0 | да
ГК Снабжение | 62100 | Спецификация №1 к дог. 62100 от 28.07.2026 (= перечень давальческого сырья) | 92 | RT0402BRD0733RL | RT0402BRD0733RL мин. 80 шт. Yageo Резистор | 80 | 80 | 0 | да
ГК Снабжение | 62100 | Спецификация №1 к дог. 62100 от 28.07.2026 (= перечень давальческого сырья) | 93 | RC0402FR-075K1L | RC0402FR-075K1L 5,1 кОм 1% 0,063Вт 0402 Yageo Резистор | 79 | 79 | 0 | да
ГК Снабжение | 62100 | Спецификация №1 к дог. 62100 от 28.07.2026 (= перечень давальческого сырья) | 94 | RC0402FR-073K3L | RC0402FR-073K3L 3,3 кОм Res 0402 1% Yageo Резистор | 53 | 53 | 0 | да
ГК Снабжение | 62100 | Спецификация №1 к дог. 62100 от 28.07.2026 (= перечень давальческого сырья) | 95 | AC0402FR-07110KL | AC0402FR-07110KL 10 кОм Res 0402 1% Yageo Резистор | 183 | 183 | 0 | НЕТ
ГК Снабжение | 62100 | Спецификация №1 к дог. 62100 от 28.07.2026 (= перечень давальческого сырья) | 96 | RC0402FR-1356R2L | RC0402FR-1356R2L 56,2 Ом Res 0402 1% Yageo Резистор | 53 | 53 | 0 | да
ГК Снабжение | 62100 | Спецификация №1 к дог. 62100 от 28.07.2026 (= перечень давальческого сырья) | 97 | RC0201FR-070RL | RC0201FR-070RL 0 Ом 1% 50мВт 0201 Yageo Резистор | 141 | 141 | 0 | да
ГК Снабжение | 62100 | Спецификация №1 к дог. 62100 от 28.07.2026 (= перечень давальческого сырья) | 98 | RT0402BRD071K5L | RT0402BRD071K5L 1,5 кОм Res 0402 1% Yageo Резистор | 56 | 56 | 0 | НЕТ
ГК Снабжение | 62100 | Спецификация №1 к дог. 62100 от 28.07.2026 (= перечень давальческого сырья) | 99 | ERJ2RKF5100X | ERJ2RKF5100X 510 Ом Res 0402 1% Panasonic Резистор | 58 | 58 | 0 | да
ГК Снабжение | 62100 | Спецификация №1 к дог. 62100 от 28.07.2026 (= перечень давальческого сырья) | 100 | RC0402FR-1337K4L | RC0402FR-1337K4L 37,4 кОм 1% 0,063Вт 0402 Yageo Резистор | 71 | 71 | 0 | да
ГК Снабжение | 62100 | Спецификация №1 к дог. 62100 от 28.07.2026 (= перечень давальческого сырья) | 101 | RC0402FR-07470RL | RC0402FR-07470RL 470 Ом 1% 0,063Вт 0402 Yageo Резистор | 63 | 63 | 0 | НЕТ
ГК Снабжение | 62100 | Спецификация №1 к дог. 62100 от 28.07.2026 (= перечень давальческого сырья) | 102 | RC0402FR-1391KL | RC0402FR-1391KL 91 кОм 1% 0,063Вт 0402 Yageo Резистор | 71 | 71 | 0 | да
ГК Снабжение | 62100 | Спецификация №1 к дог. 62100 от 28.07.2026 (= перечень давальческого сырья) | 103 | RT0402BRE071K5L | RT0402BRE071K5L 1,5 кОм 0,1% 0,063Вт 0402 Yageo Резистор | 63 | 63 | 0 | да
ГК Снабжение | 62100 | Спецификация №1 к дог. 62100 от 28.07.2026 (= перечень давальческого сырья) | 104 | RT0603BRE0711K8L | RT0603BRE0711K8L 11,8 кОм 1% 0,1Вт 0603 Yageo Резистор | 53 | 53 | 0 | да
ГК Снабжение | 62100 | Спецификация №1 к дог. 62100 от 28.07.2026 (= перечень давальческого сырья) | 105 | CRCW04021K87FKED | CRCW04021K87FKED 1,87 кОм 1% 0,063Вт 0402 VISHAY Резистор | 63 | 63 | 0 | да
ГК Снабжение | 62100 | Спецификация №1 к дог. 62100 от 28.07.2026 (= перечень давальческого сырья) | 106 | RC0402BR-0720KL | RC0402BR-0720KL 20 кОм 0,1% 0,063Вт 0402 Yageo Резистор | 63 | 63 | 0 | да
ГК Снабжение | 62100 | Спецификация №1 к дог. 62100 от 28.07.2026 (= перечень давальческого сырья) | 107 | RC0201JR-0710KL | RC0201JR-0710KL 10 кОм 5% 0,05Вт 0603 Yageo Резистор | 71 | 71 | 0 | НЕТ
ГК Снабжение | 62100 | Спецификация №1 к дог. 62100 от 28.07.2026 (= перечень давальческого сырья) | 108 | RC0603FR-074R75L | RC0603FR-074R75L 4,75 кОм 1% 0,1Вт 0603 Yageo Резистор | 58 | 58 | 0 | НЕТ
ГК Снабжение | 62100 | Спецификация №1 к дог. 62100 от 28.07.2026 (= перечень давальческого сырья) | 109 | RC0603FR-076K8P | RC0603FR-076K8P 6,8 кОм 1% 0,1Вт 0603 Yageo Резистор | 58 | 58 | 0 | да
ГК Снабжение | 62100 | Спецификация №1 к дог. 62100 от 28.07.2026 (= перечень давальческого сырья) | 110 | RC0603FR-0715KP | RC0603FR-0715KP 15 кОм 1% 0,1Вт 0603 Yageo Резистор | 53 | 53 | 0 | да
ГК Снабжение | 62100 | Спецификация №1 к дог. 62100 от 28.07.2026 (= перечень давальческого сырья) | 111 | CSSH0805FTL500 | CSSH0805FTL500 0,5 мОм 1% 1Вт 0805 SEI STACKPOLE ELECTRONICS INC Резистор | 71 | 71 | 0 | да
ГК Снабжение | 62100 | Спецификация №1 к дог. 62100 от 28.07.2026 (= перечень давальческого сырья) | 112 | RC0402FR-0710KL | RC0402FR-0710KL 10 кОм 1% 0,0625Вт 0402 Yageo Резистор | 82 | 82 | 0 | НЕТ
ГК Снабжение | 62100 | Спецификация №1 к дог. 62100 от 28.07.2026 (= перечень давальческого сырья) | 113 | RT0402BRE0733KL | RT0402BRE0733KL 33 кОм 0,1% 0,063Вт 0402 Yageo Резистор | 53 | 53 | 0 | да
ГК Снабжение | 62100 | Спецификация №1 к дог. 62100 от 28.07.2026 (= перечень давальческого сырья) | 114 | RC0603FR-0731K6L | RC0603FR-0731K6L 31,6 кОм 1% 0,1Вт 0603 Yageo Резистор | 58 | 58 | 0 | да
ГК Снабжение | 62100 | Спецификация №1 к дог. 62100 от 28.07.2026 (= перечень давальческого сырья) | 115 | RC0603FR-1347KL | RC0603FR-1347KL 47 кОм 1% 0,1Вт 0603 Yageo Резистор | 58 | 58 | 0 | да
ГК Снабжение | 62100 | Спецификация №1 к дог. 62100 от 28.07.2026 (= перечень давальческого сырья) | 116 | TNPW040254K2BEED | TNPW040254K2BEED 54,2 кОм 0,1% 0,063Вт 0402 VISHAY DALE Резистор | 53 | 53 | 0 | да
ГК Снабжение | 62100 | Спецификация №1 к дог. 62100 от 28.07.2026 (= перечень давальческого сырья) | 117 | RC0402FR-07100KL | RC0402FR-07100KL 100 кОм 1% 0,063Вт 0402 Yageo Резистор | 66 | 66 | 0 | да
ГК Снабжение | 62100 | Спецификация №1 к дог. 62100 от 28.07.2026 (= перечень давальческого сырья) | 118 | RT0402BRD072K21L | RT0402BRD072K21L 2,21 кОм 0,1% 0,063Вт 0402 Yageo Резистор | 61 | 61 | 0 | да
ГК Снабжение | 62100 | Спецификация №1 к дог. 62100 от 28.07.2026 (= перечень давальческого сырья) | 119 | TNPW060322K0BEEA | TNPW060322K0BEEA 22 кОм 0,1% 0,1Вт 0603 VISHAY Резистор | 56 | 56 | 0 | да
ГК Снабжение | 62100 | Спецификация №1 к дог. 62100 от 28.07.2026 (= перечень давальческого сырья) | 120 | RC0603FR-073KL | RC0603FR-073KL Yageo Резистор | 69 | 69 | 0 | да
ГК Снабжение | 62100 | Спецификация №1 к дог. 62100 от 28.07.2026 (= перечень давальческого сырья) | 121 | RC0603FR-07249KL | RC0603FR-07249KL 249 кОм 1% 0,1Вт 0603 Yageo Резистор | 53 | 53 | 0 | НЕТ
ГК Снабжение | 62100 | Спецификация №1 к дог. 62100 от 28.07.2026 (= перечень давальческого сырья) | 122 | RP0603BRE07200KL | RP0603BRE07200KL 200 кОм 0.1% 100мВт 0603 Yageo Резистор | 53 | 53 | 0 | НЕТ
ГК Снабжение | 62100 | Спецификация №1 к дог. 62100 от 28.07.2026 (= перечень давальческого сырья) | 123 | AC0402FR-0744K2L | AC0402FR-0744K2L 44,2 кОм 1% 0,063Вт 0402 Yageo Резистор | 53 | 53 | 0 | НЕТ
ГК Снабжение | 62100 | Спецификация №1 к дог. 62100 от 28.07.2026 (= перечень давальческого сырья) | 124 | RC0603FR-0712K4L | RC0603FR-0712K4L 12,4 кОм 1% 0,1Вт 0603 Yageo Резистор | 53 | 53 | 0 | НЕТ
ГК Снабжение | 62100 | Спецификация №1 к дог. 62100 от 28.07.2026 (= перечень давальческого сырья) | 125 | RT0603BRE0747K5L | RT0603BRE0747K5L 47,5 кОм 0,1% 0,1Вт 0603 Yageo Резистор | 53 | 53 | 0 | да
ГК Снабжение | 62100 | Спецификация №1 к дог. 62100 от 28.07.2026 (= перечень давальческого сырья) | 126 | RT0603BRD0715KL | RT0603BRD0715KL 15 кОм 0,1% 0,1Вт 0603 Yageo Резистор | 53 | 53 | 0 | да
ГК Снабжение | 62100 | Спецификация №1 к дог. 62100 от 28.07.2026 (= перечень давальческого сырья) | 127 | RC0402FR-0722RL | RC0402FR-0722RL 22 Ом 0402 Yageo Резистор | 66 | 66 | 0 | да
ГК Снабжение | 62100 | Спецификация №1 к дог. 62100 от 28.07.2026 (= перечень давальческого сырья) | 128 | RC0603FR-0712KP | RC0603FR-0712KP 12 кОм 1% 0,1Вт 0603 Yageo Резистор | 53 | 53 | 0 | да
ГК Снабжение | 62100 | Спецификация №1 к дог. 62100 от 28.07.2026 (= перечень давальческого сырья) | 129 | RC0201FR-0718RL | RC0201FR-0718RL 18 Ом Res 0201 1% Yageo Резистор | 61 | 61 | 0 | НЕТ
ГК Снабжение | 62100 | Спецификация №1 к дог. 62100 от 28.07.2026 (= перечень давальческого сырья) | 130 | RC0201FR-071K1L | RC0201FR-071K1L 1,1 кОм Res 0201 1% Yageo Резистор | 61 | 61 | 0 | НЕТ
ГК Снабжение | 62100 | Спецификация №1 к дог. 62100 от 28.07.2026 (= перечень давальческого сырья) | 131 | CRCW020149R9FNED | CRCW020149R9FNED мин. 100 шт. VISHAY Резистор | 100 | 100 | 0 | да
ГК Снабжение | 62100 | Спецификация №1 к дог. 62100 от 28.07.2026 (= перечень давальческого сырья) | 132 | RC0201FR-07100RL | RC0201FR-07100RL 100 Ом Res 0201 1% Yageo Резистор | 71 | 71 | 0 | НЕТ
ГК Снабжение | 62100 | Спецификация №1 к дог. 62100 от 28.07.2026 (= перечень давальческого сырья) | 133 | RC0201FR-0710RL | RC0201FR-0710RL 07-упаковка Yageo Резистор | 71 | 71 | 0 | НЕТ
ГК Снабжение | 62100 | Спецификация №1 к дог. 62100 от 28.07.2026 (= перечень давальческого сырья) | 134 | RC0603FR-07887KL | RC0603FR-07887KL 887K kOhm 0603 1% Yageo Резистор | 76 | 76 | 0 | НЕТ
ГК Снабжение | 62100 | Спецификация №1 к дог. 62100 от 28.07.2026 (= перечень давальческого сырья) | 135 | RC0402JR-07200KL | RC0402JR-07200KL 0402 200 кОм, 5% Yageo Резистор | 76 | 76 | 0 | НЕТ
ГК Снабжение | 62100 | Спецификация №1 к дог. 62100 от 28.07.2026 (= перечень давальческого сырья) | 136 | RC0402JR-07820RL | RC0402JR-07820RL 820 Ом 0402 ± 5% Yageo Резистор | 76 | 76 | 0 | НЕТ
ГК Снабжение | 62100 | Спецификация №1 к дог. 62100 от 28.07.2026 (= перечень давальческого сырья) | 137 | RC0402FR-078K06L | RC0402FR-078K06L 8.06кОм 0402 +1% 0.063Вт Yageo Резистор | 76 | 76 | 0 | НЕТ
ГК Снабжение | 62100 | Спецификация №1 к дог. 62100 от 28.07.2026 (= перечень давальческого сырья) | 138 | RC0402JR-074K7L | RC0402JR-074K7L 0.062Вт 0402 4.7 кОм, 5% Yageo Резистор | 76 | 76 | 0 | НЕТ
ГК Снабжение | 62100 | Спецификация №1 к дог. 62100 от 28.07.2026 (= перечень давальческого сырья) | 139 | RC0402FR-0739RL | RC0402FR-0739RL 0.062Вт 0402 39 Ом 1% Yageo Резистор | 260 | 260 | 0 | НЕТ
ГК Снабжение | 62100 | Спецификация №1 к дог. 62100 от 28.07.2026 (= перечень давальческого сырья) | 140 | PT61020EL | PT61020EL Bourns Индуктивность | 3 | 3 | 0 | да
ГК Снабжение | 62100 | Спецификация №1 к дог. 62100 от 28.07.2026 (= перечень давальческого сырья) | 141 | PESD2CAN215 | PESD2CAN215 NEXPERIA Диод | 6 | 6 | 0 | да
ГК Снабжение | 62100 | Спецификация №1 к дог. 62100 от 28.07.2026 (= перечень давальческого сырья) | 142 | SML-P11MTT86R | SML-P11MTT86R ROHM SEMICONDUCTOR Светодиод | 24 | 24 | 0 | да
ГК Снабжение | 62100 | Спецификация №1 к дог. 62100 от 28.07.2026 (= перечень давальческого сырья) | 143 | SMLD12EN1WT86 | SMLD12EN1WT86 ROHM SEMICONDUCTOR Светодиод | 47 | 47 | 0 | НЕТ
ГК Снабжение | 62100 | Спецификация №1 к дог. 62100 от 28.07.2026 (= перечень давальческого сырья) | 144 | SML-P11UTT86R | SML-P11UTT86R ROHM SEMICONDUCTOR Светодиод | 6 | 6 | 0 | да
ГК Снабжение | 62100 | Спецификация №1 к дог. 62100 от 28.07.2026 (= перечень давальческого сырья) | 145 | DS1021-1x4SF11-B | DS1021-1x4SF11-B Connfly Соединитель | 50 | 50 | 0 | да
ГК Снабжение | 62100 | Спецификация №1 к дог. 62100 от 28.07.2026 (= перечень давальческого сырья) | 146 | 5103308-1 | 5103308-1 TE Соединитель | 6 | 6 | 0 | да
ГК Снабжение | 62100 | Спецификация №1 к дог. 62100 от 28.07.2026 (= перечень давальческого сырья) | 147 | DS1021-2x3SF11-B | DS1021-2x3SF11-B Connfly Соединитель | 3 | 3 | 0 | НЕТ
ГК Снабжение | 62100 | Спецификация №1 к дог. 62100 от 28.07.2026 (= перечень давальческого сырья) | 148 | DS1021-2x6SF11-B | DS1021-2x6SF11-B Connfly Соединитель | 3 | 3 | 0 | НЕТ
ГК Снабжение | 62100 | Спецификация №1 к дог. 62100 от 28.07.2026 (= перечень давальческого сырья) | 149 | DS1021-2x5SF11-B | DS1021-2x5SF11-B Connfly Разъем | 16 | 16 | 0 | НЕТ
ГК Снабжение | 62100 | Спецификация №1 к дог. 62100 от 28.07.2026 (= перечень давальческого сырья) | 150 | 09350022102 | 09350022102 Harting Разъем | 3 | 3 | 0 | НЕТ
ГК Снабжение | 62100 | Спецификация №1 к дог. 62100 от 28.07.2026 (= перечень давальческого сырья) | 151 | S0991-46R | S0991-46R HARW Разъем | 37 | 37 | 0 | да
ГК Снабжение | 62100 | Спецификация №1 к дог. 62100 от 28.07.2026 (= перечень давальческого сырья) | 152 | SMA-J-P-H-ST-TH1 | SMA-J-P-H-ST-TH1 SAMTEC INC Разъем | 37 | 37 | 0 | НЕТ
ГК Снабжение | 62100 | Спецификация №1 к дог. 62100 от 28.07.2026 (= перечень давальческого сырья) | 153 | USB3140-30-0170-0-C | USB3140-30-0170-0-C USB type B GLOBAL CONNECTOR TECHNOLOGY Разъем | 3 | 3 | 0 | НЕТ
ГК Снабжение | 62100 | Спецификация №1 к дог. 62100 от 28.07.2026 (= перечень давальческого сырья) | 154 | BLM18SN220TN1D | BLM18SN220TN1D 22 Ом 25% 8А 0603 Murata Индуктивность | 19 | 0 | 19 | да
ГК Снабжение | 62100 | Спецификация №1 к дог. 62100 от 28.07.2026 (= перечень давальческого сырья) | 155 | MI0603M121R-10 | MI0603M121R-10 120 Ом 2,5А 0603 QNITY LAIRD Ферритовый сердечник | 37 | 37 | 0 | да
ГК Снабжение | 62100 | Спецификация №1 к дог. 62100 от 28.07.2026 (= перечень давальческого сырья) | 156 | BLM31PG330SZ1L | BLM31PG330SZ1L 9 мОм 25% 6А 1206 Murata Индуктивность | 6 | 6 | 0 | да
ГК Снабжение | 62100 | Спецификация №1 к дог. 62100 от 28.07.2026 (= перечень давальческого сырья) | 157 | NX3225HA-25MHZ | NX3225HA-25MHZ NDK Кварцевый резонатор | 3 | 3 | 0 | да
ГК Снабжение | 62100 | Спецификация №1 к дог. 62100 от 28.07.2026 (= перечень давальческого сырья) | 158 | NX3215SA | NX3215SA 32.768KHz EXS00A-MU00525 мин. 5 шт. NDK Кварцевый резонатор | 5 | 5 | 0 | да
ЧИП и ДИП | 17774774 | Счёт 17774774 от 26.08.2026 | 1 | ADP2384ACPZN-R7 | ADP2384ACPZN-R7, Синхронный понижающий DC-DC преобразователь, ADJ, 4A, 1.4МГц [FCSP_WQ-24]\Analog Devices | 2 | 2 | 0 | да
ЧИП и ДИП | 17774774 | Счёт 17774774 от 26.08.2026 | 2 | 93LC56A-I/SN | 93LC56A-I/SN, Микросхема\Microchip | 3 | 3 | 0 | да
ЧИП и ДИП | 17774774 | Счёт 17774774 от 26.08.2026 | 3 | CC0603JRX7R7BB104 | 0.1мкФ X7R 16В 5% 0603, CC0603JRX7R7BB104, Конденсатор керамический smd\Yageo | 120 | 120 | 0 | да
ЧИП и ДИП | 17774774 | Счёт 17774774 от 26.08.2026 | 4 | GRM1885C2A220JA01D | 22пФ NP0 100В 5% 0603,GRM1885C2A220JA01D, Конденсатор керамический smd\Murata | 15 | 15 | 0 | да
ЧИП и ДИП | 17774774 | Счёт 17774774 от 26.08.2026 | 5 | CC0402JRNPO9BN270 | 27пФ NP0 50В 5% 0402, CC0402JRNPO9BN270, Конденсатор керамический smd\Yageo | 10 | 10 | 0 | да
ЧИП и ДИП | 17774774 | Счёт 17774774 от 26.08.2026 | 6 | GRM033R61C104KE84D | GRM033R61C104KE84D, Конденсатор\Murata | 66 | 66 | 0 | да
ЧИП и ДИП | 17774774 | Счёт 17774774 от 26.08.2026 | 7 | GRM155R61H474KE11D | GRM155R61H474KE11D, Конденсатор\Murata | 46 | 46 | 0 | да
ЧИП и ДИП | 17774774 | Счёт 17774774 от 26.08.2026 | 8 | GRM188R71H102K | 1000пФ X7R 50В 10% 0603, GRM188R71H102K, Конденсатор керамический smd\Murata | 46 | 46 | 0 | да
ЧИП и ДИП | 17774774 | Счёт 17774774 от 26.08.2026 | 9 | GRM033R71C103KE14D | GRM033R71C103KE14D, Многослойный керамический конденсатор, 0.01 мкФ, 16 В, 0201 [0603 Метрический], ± 10%, X7R\Murata | 109 | 109 | 0 | да
ЧИП и ДИП | 17774774 | Счёт 17774774 от 26.08.2026 | 10 | GRM155R71E222KA01D | Кер.чип.конд. 0402 X7R 2.2нФ 25В 10%, GRM155R71E222KA01D, Конденсатор\Murata | 41 | 41 | 0 | да
ЧИП и ДИП | 17774774 | Счёт 17774774 от 26.08.2026 | 11 | C0402C103J3RACTU | C0402C103J3RACTU, Многослойный керамический конденсатор, 0402 [1005 Метрический], 0.01 мкФ, 25 В, ± 5%, X7R, серия C\Kemet | 9 | 9 | 0 | да
ЧИП и ДИП | 17774774 | Счёт 17774774 от 26.08.2026 | 12 | GRM1555C1H101JA01D | 100пФ 50В NP0 5% 0402, GRM1555C1H101JA01D, Конденсатор керамический smd\Murata | 15 | 15 | 0 | да
ЧИП и ДИП | 17774774 | Счёт 17774774 от 26.08.2026 | 13 | GRM1885C2A100JA01D | 10пФ NP0 100В 5% 0603, GRM1885C2A100JA01D, Конденсатор керамический smd\Murata | 15 | 15 | 0 | да
ЧИП и ДИП | 17774774 | Счёт 17774774 от 26.08.2026 | 14 | RC0603FR-073KL | 0.1Вт 0603 3 кОм, 1%, RC0603FR-073KL, Чип резистор (SMD)\Yageo | 23 | 23 | 0 | да
ЧИП и ДИП | 17774774 | Счёт 17774774 от 26.08.2026 | 15 | RC0603FR-0710KL | 0.1Вт 0603 10 кОм, 1%, RC0603FR-0710KL, Чип резистор (SMD)\Yageo | 95 | 95 | 0 | да
ЧИП и ДИП | 17774774 | Счёт 17774774 от 26.08.2026 | 16 | CRCW060310R0JNEA | CRCW060310R0JNEA, Резистор\Vishay | 23 | 23 | 0 | НЕТ
ЧИП и ДИП | 17774774 | Счёт 17774774 от 26.08.2026 | 17 | LQW15CA1R0K00D | LQW15CA1R0K00D, Индуктивность SMD 0402 \Murata | 23 | 23 | 0 | да
ЧИП и ДИП | 17774774 | Счёт 17774774 от 26.08.2026 | 18 | BLM18SG121TN1D | BLM18SG121TN1D, 120 Ом, 3А, 0603, Дроссель подавления ЭМП\Murata | 28 | 28 | 0 | да
ЧИП и ДИП | 17774774 | Счёт 17774774 от 26.08.2026 | 19 | BLM15PX330SZ1D | BLM15PX330SZ1D, 3A 1 22m- 33-@100MHz ±25% 0402 Ferrite Beads ROHS, Фильтр\Murata | 17 | 17 | 0 | да
ЧИП и ДИП | 17774774 | Счёт 17774774 от 26.08.2026 | 20 | ASEMB-50.000MHZ-LC-T | ASEMB-50.000MHZ-LC-T, Генератор\Abracon | 6 | 6 | 0 | да
ЧИП и ДИП | 17774774 | Счёт 17774774 от 26.08.2026 | 21 | 7U-12.000-12-30-80-C-50 | 12Мгц, smd 3.2×2.5×0.7мм, Кварцевый резонатор\SJK | 3 | 3 | 0 | да
ЧИП и ДИП | 17774774 | Счёт 17774774 от 26.08.2026 | 22 | TCM2-33WX+ | TCM2-33WX+, Трансформатор\Mini-Circuits | 20 | 20 | 0 | да
ЧИП и ДИП | 17774774 | Счёт 17774774 от 26.08.2026 | 23 | 640445-2 | 640445-2, Разъем, Разъём\TE Connectivity | 10 | 10 | 0 | да
ЧИП и ДИП | 17774774 | Счёт 17774774 от 26.08.2026 | 24 | 500901-0801 | 500901-0801, Держатель, Разъем\Molex | 3 | 3 | 0 | да
ЧИП и ДИП | 17774774 | Счёт 17774774 от 26.08.2026 | 25 | 74HC2G34GV | 74HC2G34GV\NXP | 14 | 14 | 0 | да
ЧИП и ДИП | 17774774 | Счёт 17774774 от 26.08.2026 | 26 | MT25QU02GCBB8E12-0SIT | Микросхема MT25QU02GCBB8E12-0SIT\Microchip | 4 | 4 | 0 | да
ГК Снабжение | 62129 | Спецификация №1 от 06.10.2026 к дог. 62129/492 | 1 | CC0603JRNPO9BN100 | CC0603JRNPO9BN100 возможная замена YAG Конденсатор | 16 | 16 | 0 | да
ГК Снабжение | 62129 | Спецификация №1 от 06.10.2026 к дог. 62129/492 | 2 | GJM1555C1H6R4CB01D | GJM1555C1H6R4CB01D мин. 10 шт. MURATA Конденсатор | 10 | 0 | 10 | да
ГК Снабжение | 62129 | Спецификация №1 от 06.10.2026 к дог. 62129/492 | 3 | DS1095-06-BNR0 | DS1095-06-BNR0 CONNFLY Разъем | 3 | 3 | 0 | да
ГК Снабжение | 62129 | Спецификация №1 от 06.10.2026 к дог. 62129/492 | 4 | 5352152-1 | 5352152-1 возможная замена TE Соединитель | 6 | 6 | 0 | да
ГК Снабжение | 62129 | Спецификация №1 от 06.10.2026 к дог. 62129/492 | 5 | RC0603JR-0710RL | RC0603JR-0710RL возможная замена YAG Резистор | 21 | 21 | 0 | НЕТ
ГК Снабжение | 62129 | Спецификация №1 от 06.10.2026 к дог. 62129/492 | 6 | RC0402JR-07100RL | RC0402JR-07100RL возможная замена YAG Резистор | 6 | 6 | 0 | да
ГК Снабжение | 62129 | Спецификация №1 от 06.10.2026 к дог. 62129/492 | 7 | MLZ1005M1R0WT000 | MLZ1005M1R0WT000 возможная замена TDK Индуктор | 21 | 21 | 0 | да
ГК Снабжение | 62129 | Спецификация №1 от 06.10.2026 к дог. 62129/492 | 8 | 17041541201 | 17041541201 возможная замена HARTING Разъем | 6 | 0 | 6 | НЕТ
ГК Снабжение | 62129 | Спецификация №1 от 06.10.2026 к дог. 62129/492 | 9 | PESD3V3L2BT | PESD3V3L2BT UMW Диод | 16 | 0 | 16 | да
ГК Снабжение | 62129 | Спецификация №1 от 06.10.2026 к дог. 62129/492 | 10 | DS1035-15FWNSISS | DS1035-15FWNSISS возможная замена CONNFLY Розетка | 16 | 16 | 0 | НЕТ
ГК Снабжение | 62129 | Спецификация №1 от 06.10.2026 к дог. 62129/492 | 11 | NX3215SA | NX3215SA 32.768KHz EXS00A-MU00525 мин. 5 шт. NDK Кварцевый резонатор | 5 | 0 | 5 | да
ГК Снабжение | 62129 | Спецификация №1 от 06.10.2026 к дог. 62129/492 | 12 | EXC-CL3225U1 | EXC-CL3225U1 EOL Panasonic Ферритовая бусина | 3 | 0 | 3 | НЕТ
ГК Снабжение | 62129 | Спецификация №1 от 06.10.2026 к дог. 62129/492 | 13 | HX1148NL | HX1148NL PULSE ELECTRONICS Трансформатор | 3 | 0 | 3 | НЕТ
ГК Снабжение | 62129 | Спецификация №1 от 06.10.2026 к дог. 62129/492 | 14 | ASEM1-25.000MHZ-LC-T | ASEM1-25.000MHZ-LC-T ABRACON Кварцевый генератор | 3 | 0 | 3 | да
ГК Снабжение | 62129 | Спецификация №1 от 06.10.2026 к дог. 62129/492 | 15 | CPC1018NTR | CPC1018NTR IXYS Реле | 10 | 10 | 0 | НЕТ
ГК Снабжение | 62129 | Спецификация №1 от 06.10.2026 к дог. 62129/492 | 16 | LQM2HPN1R0MG0L | LQM2HPN1R0MG0L MUR Катушка индуктивности | 5 | 5 | 0 | НЕТ
ГК Снабжение | 62129 | Спецификация №1 от 06.10.2026 к дог. 62129/492 | 17 | ADM7150ARDZ-3.3-R7 | ADM7150ARDZ-3.3-R7 SOP Analog Devices Микросхема | 5 | 0 | 5 | НЕТ
ГК Снабжение | 62129 | Спецификация №1 от 06.10.2026 к дог. 62129/492 | 18 | ADP2370ACPZ-1.8-R7 | ADP2370ACPZ-1.8-R7 Analog Devices Стабилизатор | 3 | 0 | 3 | да
ГК Снабжение | 62129 | Спецификация №1 от 06.10.2026 к дог. 62129/492 | 19 | MAX232ECDR | MAX232ECDR SOP16 Texas Instruments Приемопередатчик | 3 | 0 | 3 | да
ГК Снабжение | 62129 | Спецификация №1 от 06.10.2026 к дог. 62129/492 | 20 | ADM7150ARDZ-5.0-R7 | ADM7150ARDZ-5.0-R7 SOIC8 Analog Devices Стабилизатор | 3 | 0 | 3 | НЕТ
ГК Снабжение | 62129 | Спецификация №1 от 06.10.2026 к дог. 62129/492 | 21 | ADP2384ACPZN-R7 | ADP2384ACPZN-R7 QFN24 Analog Devices Стабилизатор | 3 | 0 | 3 | да
ГК Снабжение | 62129 | Спецификация №1 от 06.10.2026 к дог. 62129/492 | 22 | 74HC2G34GV | 74HC2G34GV,125 NEXPERIA Микросхема | 21 | 0 | 21 | да
ГК Снабжение | 62129 | Спецификация №1 от 06.10.2026 к дог. 62129/492 | 23 | STM32H745IIT6 | STM32H745IIT6 LQFP176 STMicroelectronics Микросхема | 2 | 0 | 2 | да
ГК Снабжение | 62129 | Спецификация №1 от 06.10.2026 к дог. 62129/492 | 24 | GRM188R60J105KA01D | GRM188R60J105KA01D MUR Конденсатор | 3 | 0 | 3 | НЕТ
ГК Снабжение | 62129 | Спецификация №1 от 06.10.2026 к дог. 62129/492 | 25 | GRM155R71C104JA88D | GRM155R71C104JA88D MURATA Конденсатор | 62 | 0 | 62 | да
ГК Снабжение | 62129 | Спецификация №1 от 06.10.2026 к дог. 62129/492 | 26 | GRM21BR71A475KA73L | GRM21BR71A475KA73L MURATA Конденсатор | 5 | 5 | 0 | да
ГК Снабжение | 62129 | Спецификация №1 от 06.10.2026 к дог. 62129/492 | 27 | RC0402FR-07301RL | RC0402FR-07301RL YAG Резистор | 10 | 10 | 0 | НЕТ
ГК Снабжение | 62129 | Спецификация №1 от 06.10.2026 к дог. 62129/492 | 28 | AD8367ARUZ-RL7 | AD8367ARUZ-RL7 Analog Devices Усилитель | 8 | 0 | 8 | да
Aliexpress | - | - | - | SMA-KWE-14.5 | SMA-KWE-14.5 разъем | 15 | 0 | 15 | да
Aliexpress | - | - | - | TPS54622RHLR | TPS54622RHLR синхронный понижающий преобразователь WYORESY | 20 | 0 | 20 | да
ЧИП и ДИП | - | - | - | 47053-1000 | 47053-1000, Разъем 4pin, 2.54 мм, штыревой, на плату | 4 | 0 | 4 | да
ЧИП и ДИП | - | - | - | TJ8P8C (DS1125) | TJ8P8C (DS1125), Розетка 8P8C (RJ45) на плату угловая экранированная | 3 | 0 | 3 | да
ЧИП и ДИП | - | - | - | RC0603FR-0757R6L |  | 16 | 16 | 0 | да
ЧИП и ДИП | - | - | - | RC0603FR-07174RL |  | 16 | 16 | 0 | да
ЧИП и ДИП | - | - | - | RC0603FR-074R7L |  | 30 | 30 | 0 | да
