prod1cys-cmd/RVN/АРБМ.468332.022 Модуль ПОС/АРБМ.468915.018 Рабочее место/Кабели/КД_кабели_АРБМ.468915.018/Результат/АРБМ.468915.105СБ К5 лист1.dxf

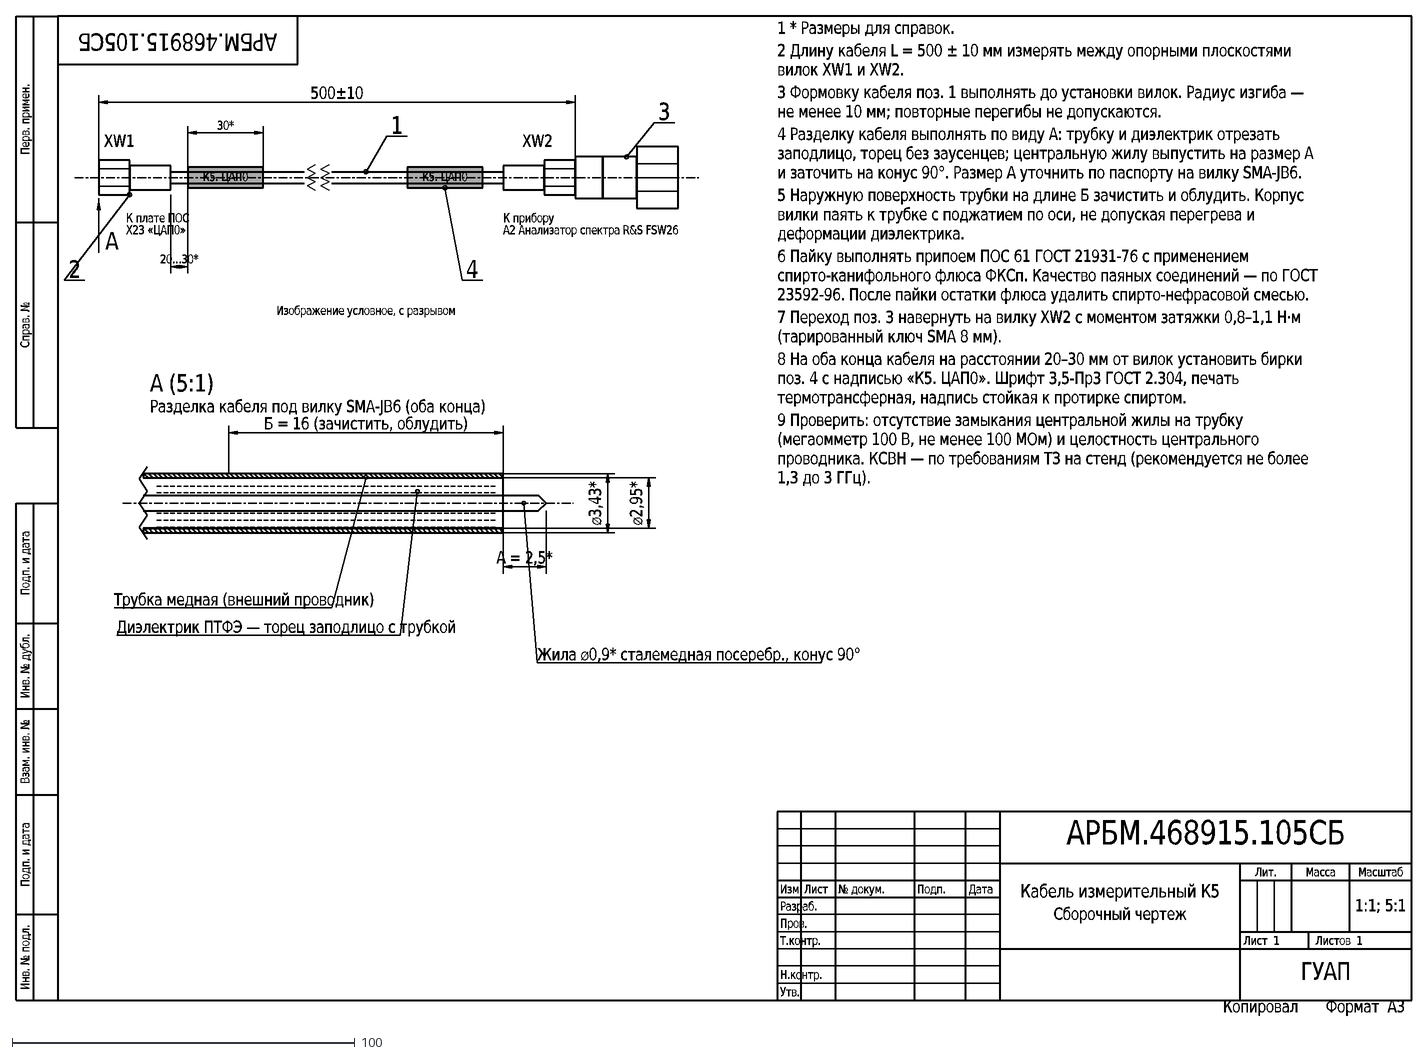
[picture p84: CAD file, 2026-11-10]
АРБМ.468332.022 Модуль ПОС/АРБМ.468915.018 Рабочее место/Кабели/КД_кабели_АРБМ.468915.018/Результат/АРБМ.468915.105СБ К5 лист1.dxf
Копировал
Формат A3
Инв. № подл.
Подп. и дата
Взам. инв. №
Инв. № дубл.
Перв. примен.
Справ. №
АРБМ.468915.105СБ
К5. ЦАП0
XW1
XW2
К плате ПОС
X23 «ЦАП0»
К прибору
A2 Анализатор спектра R&S FSW26
500±10
20…30*
30*
1
2
3
4
А
Изображение условное, с разрывом
Б = 16 (зачистить, облудить)
А = 2,5*
⌀3,43*
⌀2,95*
А (5:1)
Разделка кабеля под вилку SMA-JB6 (оба конца)
Трубка медная (внешний проводник)
Диэлектрик ПТФЭ — торец заподлицо с трубкой
Жила ⌀0,9* сталемедная посеребр., конус 90°
1 * Размеры для справок.
2 Длину кабеля L = 500 ± 10 мм измерять между опорными плоскостями
вилок XW1 и XW2.
3 Формовку кабеля поз. 1 выполнять до установки вилок. Радиус изгиба —
не менее 10 мм; повторные перегибы не допускаются.
4 Разделку кабеля выполнять по виду А: трубку и диэлектрик отрезать
заподлицо, торец без заусенцев; центральную жилу выпустить на размер А
и заточить на конус 90°. Размер А уточнить по паспорту на вилку SMA-JB6.
5 Наружную поверхность трубки на длине Б зачистить и облудить. Корпус
вилки паять к трубке с поджатием по оси, не допуская перегрева и
деформации диэлектрика.
6 Пайку выполнять припоем ПОС 61 ГОСТ 21931-76 с применением
спирто-канифольного флюса ФКСп. Качество паяных соединений — по ГОСТ
23592-96. После пайки остатки флюса удалить спирто-нефрасовой смесью.
7 Переход поз. 3 навернуть на вилку XW2 с моментом затяжки 0,8–1,1 Н·м
(тарированный ключ SMA 8 мм).
8 На оба конца кабеля на расстоянии 20–30 мм от вилок установить бирки
поз. 4 с надписью «К5. ЦАП0». Шрифт 3,5-Пр3 ГОСТ 2.304, печать
термотрансферная, надпись стойкая к протирке спиртом.
9 Проверить: отсутствие замыкания центральной жилы на трубку
(мегаомметр 100 В, не менее 100 МОм) и целостность центрального
проводника. КСВН — по требованиям ТЗ на стенд (рекомендуется не более
1,3 до 3 ГГц).
Изм.
Лист
№ докум.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
