prod1cys-cmd/RVN/АРБМ.468332.022 Модуль ПОС/АРБМ.468915.018 Рабочее место/Кабели/КД_кабели_АРБМ.468915.018/Результат/АРБМ.468915.110СБ К10 лист2.dxf

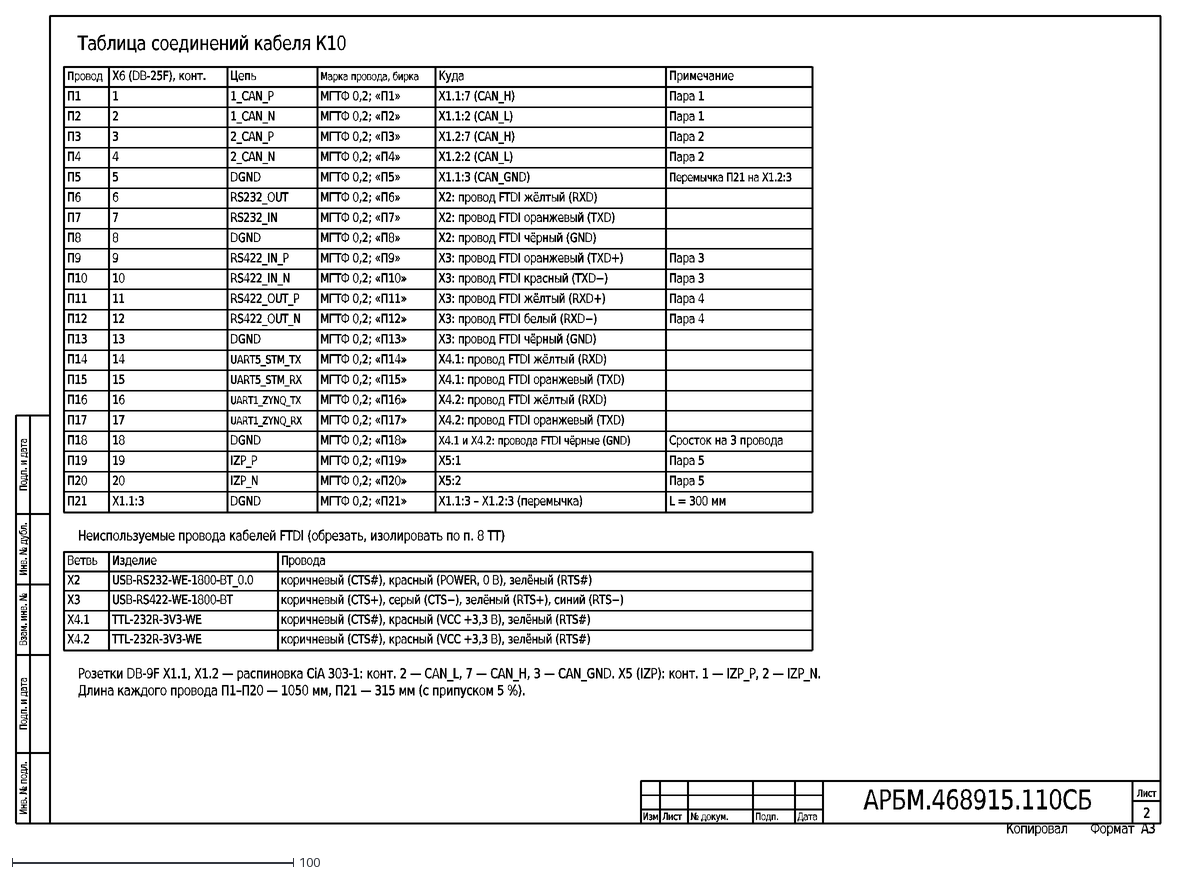
[picture p85: CAD file, 2026-11-10]
АРБМ.468332.022 Модуль ПОС/АРБМ.468915.018 Рабочее место/Кабели/КД_кабели_АРБМ.468915.018/Результат/АРБМ.468915.110СБ К10 лист2.dxf
Копировал
Формат A3
Инв. № подл.
Подп. и дата
Взам. инв. №
Инв. № дубл.
Таблица соединений кабеля К10
Провод
X6 (DB-25F), конт.
Цепь
Марка провода, бирка
Куда
Примечание
П1
1
1_CAN_P
МГТФ 0,2; «П1»
X1.1:7 (CAN_H)
Пара 1
П2
2
1_CAN_N
МГТФ 0,2; «П2»
X1.1:2 (CAN_L)
П3
3
2_CAN_P
МГТФ 0,2; «П3»
X1.2:7 (CAN_H)
Пара 2
П4
4
2_CAN_N
МГТФ 0,2; «П4»
X1.2:2 (CAN_L)
П5
5
DGND
МГТФ 0,2; «П5»
X1.1:3 (CAN_GND)
Перемычка П21 на X1.2:3
П6
6
RS232_OUT
МГТФ 0,2; «П6»
X2: провод FTDI жёлтый (RXD)
П7
7
RS232_IN
МГТФ 0,2; «П7»
X2: провод FTDI оранжевый (TXD)
П8
8
МГТФ 0,2; «П8»
X2: провод FTDI чёрный (GND)
П9
9
RS422_IN_P
МГТФ 0,2; «П9»
X3: провод FTDI оранжевый (TXD+)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
