prod1cys-cmd/RVN/АРБМ.468332.022 Модуль ПОС/АРБМ.468915.018 Рабочее место/Кабели/КД_кабели_АРБМ.468915.018/Результат/АРБМ.468915.114СБ К14 лист1.dxf

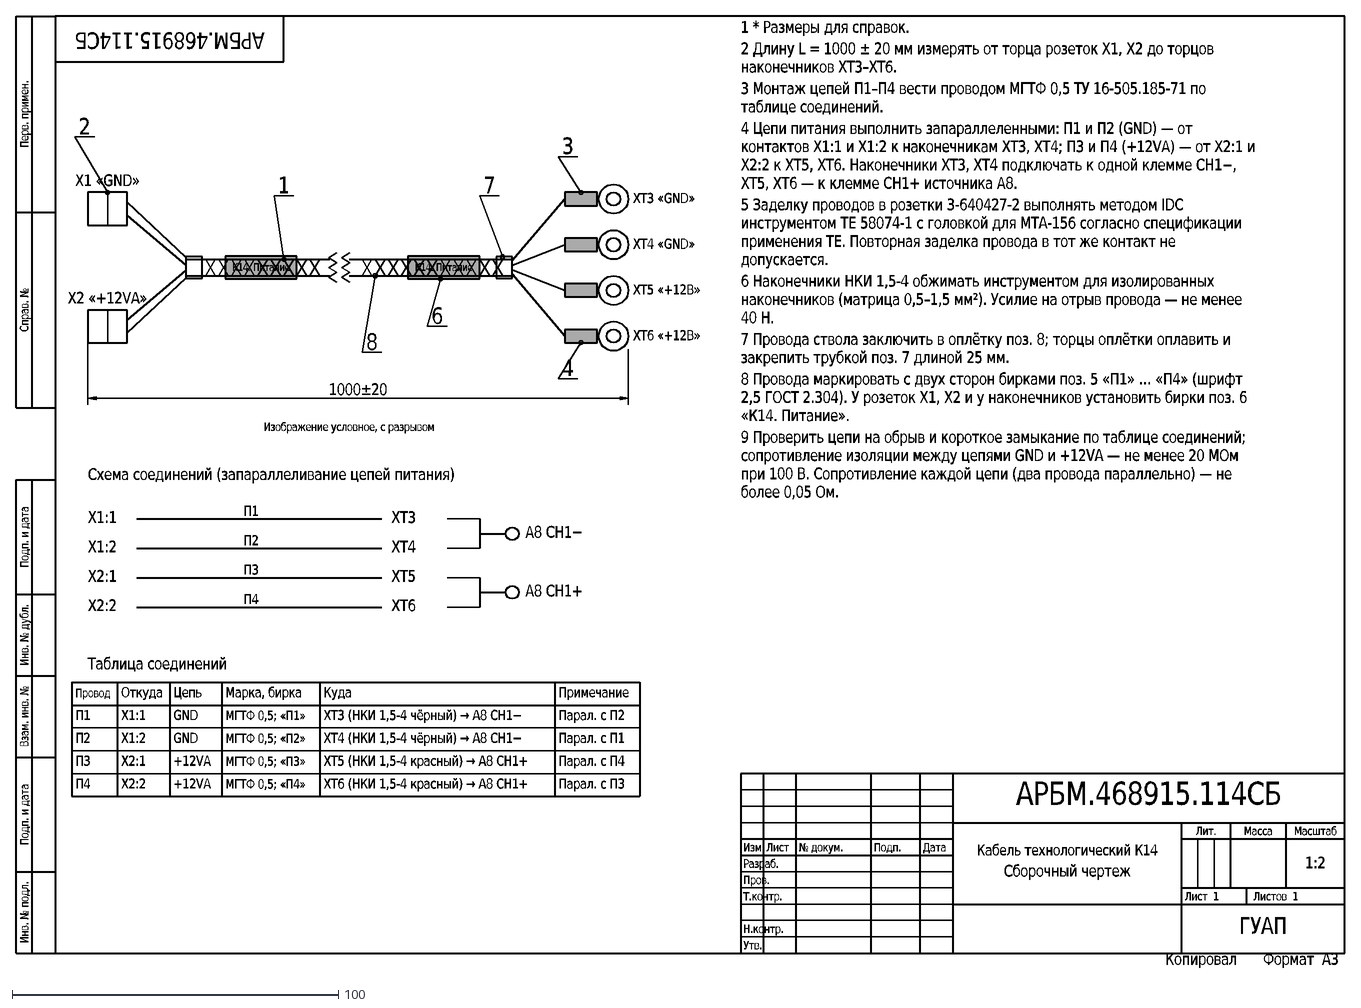
[picture p87: CAD file, 2026-11-10]
АРБМ.468332.022 Модуль ПОС/АРБМ.468915.018 Рабочее место/Кабели/КД_кабели_АРБМ.468915.018/Результат/АРБМ.468915.114СБ К14 лист1.dxf
Копировал
Формат A3
Инв. № подл.
Подп. и дата
Взам. инв. №
Инв. № дубл.
Перв. примен.
Справ. №
АРБМ.468915.114СБ
X1 «GND»
X2 «+12VA»
К14. Питание
XT3 «GND»
XT4 «GND»
XT5 «+12В»
XT6 «+12В»
1000±20
2
1
8
7
3
4
6
Изображение условное, с разрывом
Схема соединений (запараллеливание цепей питания)
X1:1
П1
XT3
X1:2
П2
XT4
X2:1
П3
XT5
X2:2
П4
XT6
A8 CH1−
A8 CH1+
Таблица соединений
Провод
Откуда
Цепь
Марка, бирка
Куда
Примечание
GND
МГТФ 0,5; «П1»
XT3 (НКИ 1,5-4 чёрный) → A8 CH1−
Парал. с П2
МГТФ 0,5; «П2»
XT4 (НКИ 1,5-4 чёрный) → A8 CH1−
Парал. с П1
+12VA
МГТФ 0,5; «П3»
XT5 (НКИ 1,5-4 красный) → A8 CH1+
Парал. с П4
МГТФ 0,5; «П4»
XT6 (НКИ 1,5-4 красный) → A8 CH1+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
