prod1cys-cmd/RVN/АРБМ.468332.022 Модуль ПОС/АРБМ.468915.018 Рабочее место/Кабели/КД_кабели_АРБМ.468915.018/Результат/АРБМ.468915.110СБ К10 лист1.dxf

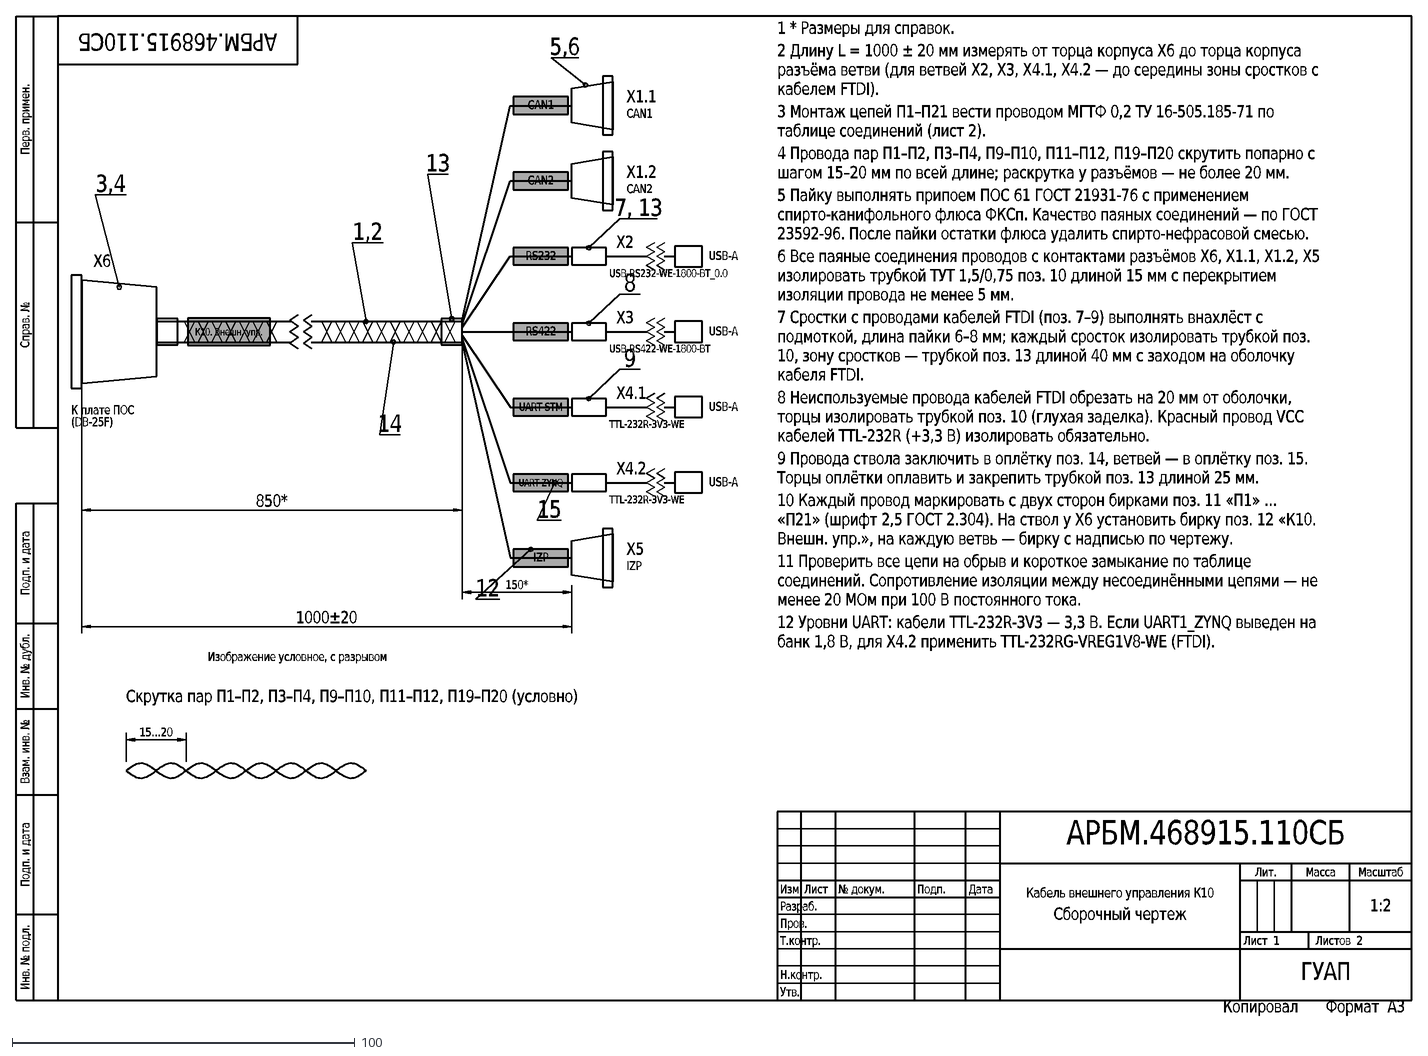
[picture p88: CAD file, 2026-11-10]
АРБМ.468332.022 Модуль ПОС/АРБМ.468915.018 Рабочее место/Кабели/КД_кабели_АРБМ.468915.018/Результат/АРБМ.468915.110СБ К10 лист1.dxf
Копировал
Формат A3
Инв. № подл.
Подп. и дата
Взам. инв. №
Инв. № дубл.
Перв. примен.
Справ. №
АРБМ.468915.110СБ
X6
К плате ПОС
(DB-25F)
К10. Внешн. упр.
X1.1
CAN1
X1.2
CAN2
X2
USB-A
USB-RS232-WE-1800-BT_0.0
RS232
X3
USB-RS422-WE-1800-BT
RS422
X4.1
TTL-232R-3V3-WE
UART STM
X4.2
UART ZYNQ
X5
IZP
1000±20
850*
150*
3,4
1,2
14
13
5,6
7, 13
8
9
15
12
Изображение условное, с разрывом
15…20
Скрутка пар П1–П2, П3–П4, П9–П10, П11–П12, П19–П20 (условно)
1 * Размеры для справок.
2 Длину L = 1000 ± 20 мм измерять от торца корпуса X6 до торца корпуса
разъёма ветви (для ветвей X2, X3, X4.1, X4.2 — до середины зоны сростков с
кабелем FTDI).
3 Монтаж цепей П1–П21 вести проводом МГТФ 0,2 ТУ 16-505.185-71 по
таблице соединений (лист 2).
4 Провода пар П1–П2, П3–П4, П9–П10, П11–П12, П19–П20 скрутить попарно с
шагом 15–20 мм по всей длине; раскрутка у разъёмов — не более 20 мм.
5 Пайку выполнять припоем ПОС 61 ГОСТ 21931-76 с применением
спирто-канифольного флюса ФКСп. Качество паяных соединений — по ГОСТ
23592-96. После пайки остатки флюса удалить спирто-нефрасовой смесью.
6 Все паяные соединения проводов с контактами разъёмов X6, X1.1, X1.2, X5
изолировать трубкой ТУТ 1,5/0,75 поз. 10 длиной 15 мм с перекрытием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
