prod1cys-cmd/RVN/АРБМ.468332.022 Модуль ПОС/АРБМ.468157.011 - Плата ПОС/АРБМ.468157.011Э3 - Плата ПОС.pdf

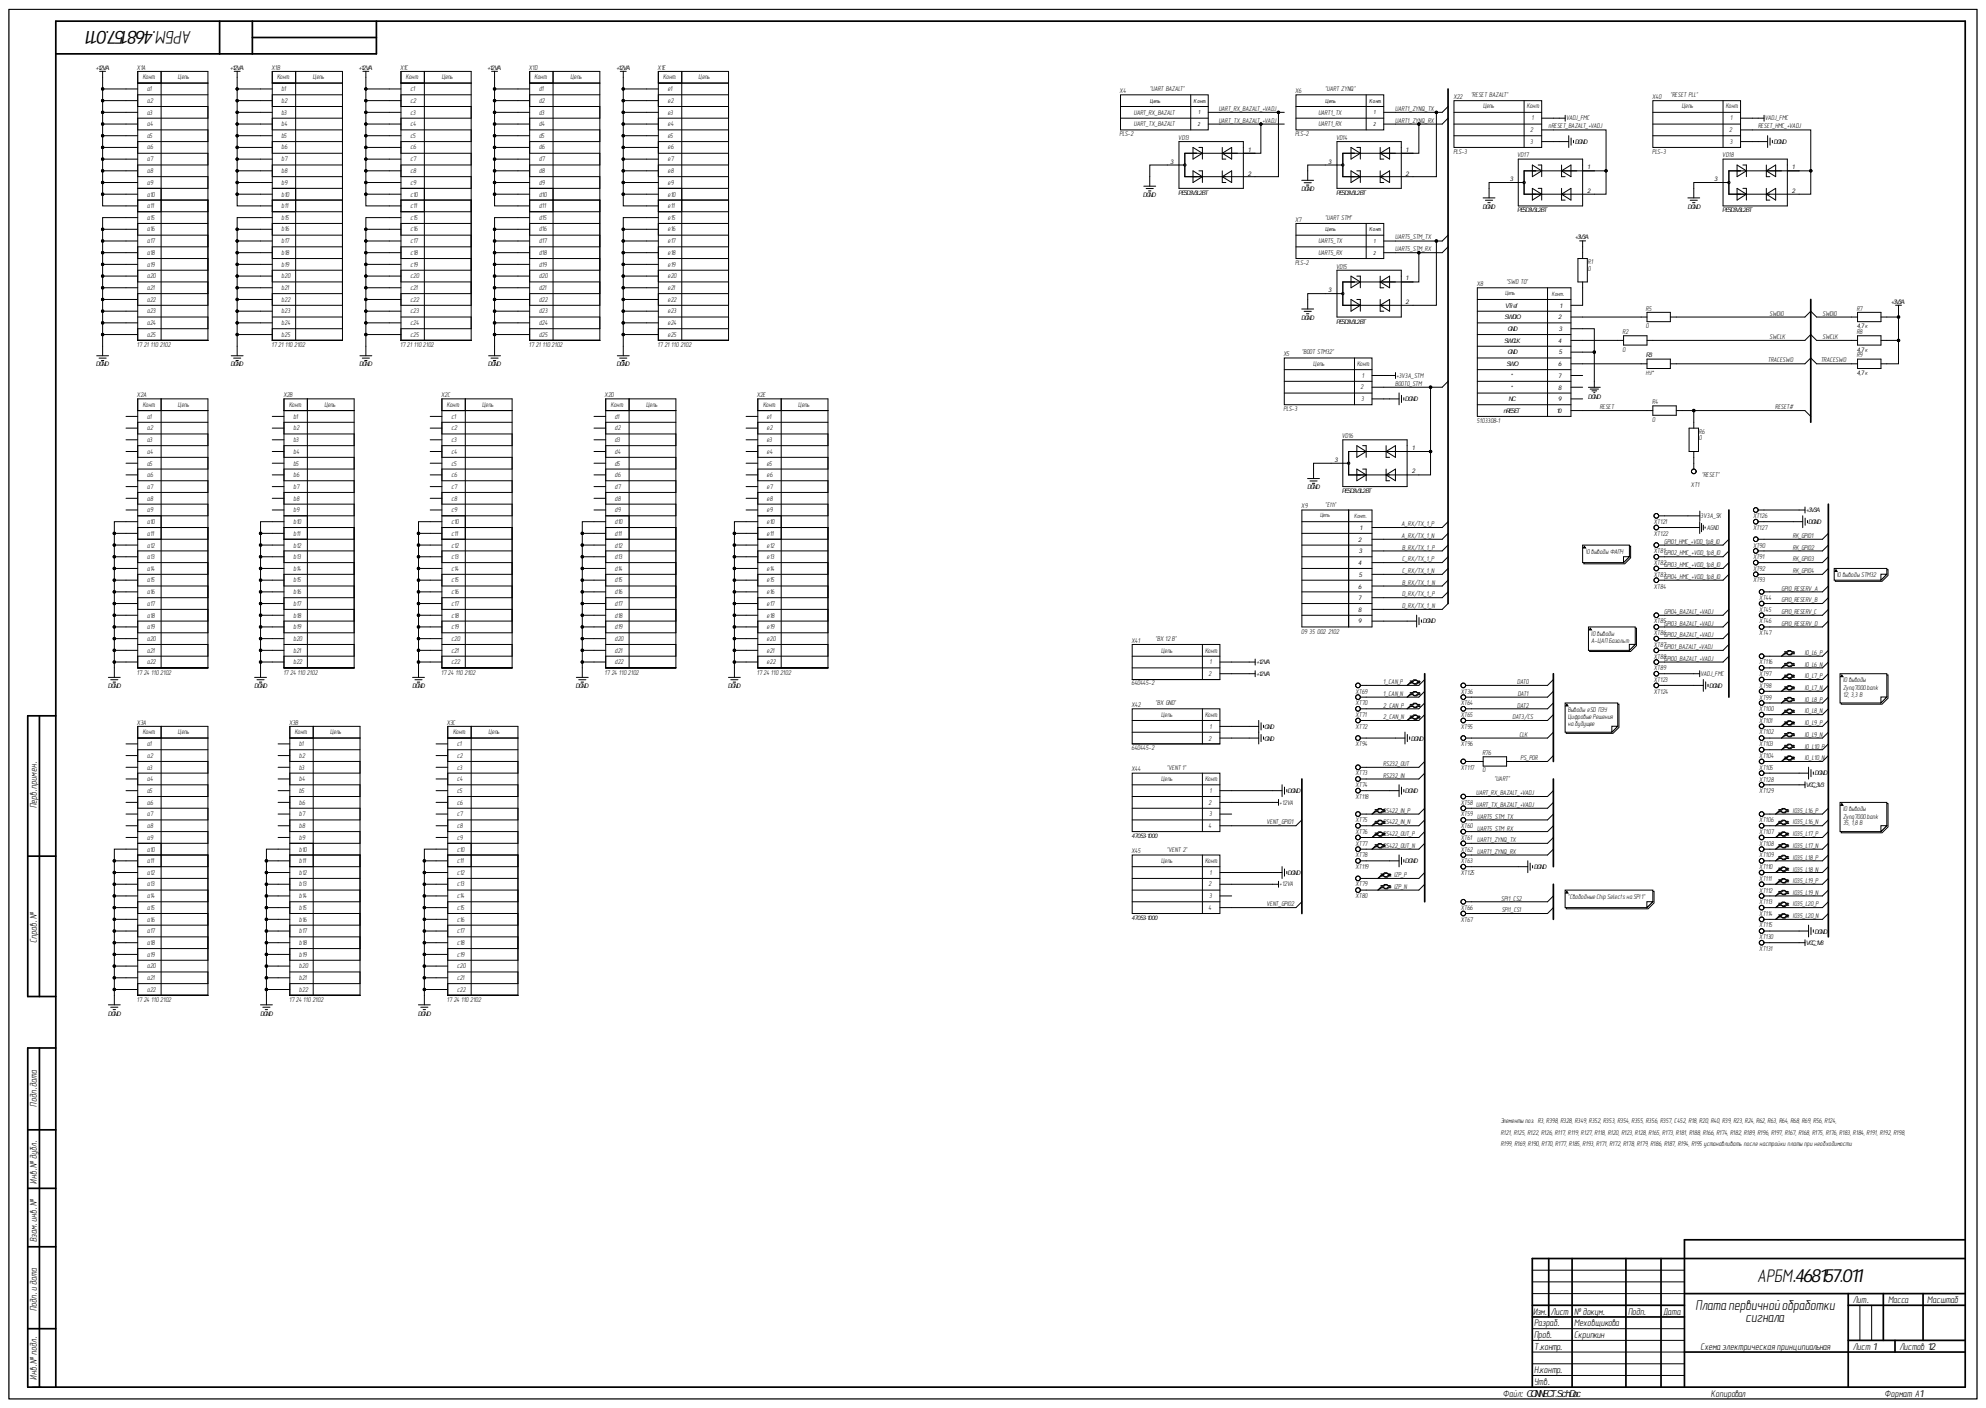
[picture p90: page 1]

2 X7 Ц епь | К о

UA RT5_ TX | нт. 12 | UA RT5_ | STM_ RX

VTref SWDIO GND SWCLK GNDSWO**NC nRESET | 12345678910 | RE SE T# | R84,7 SWCLK TRACESWO к R9

3 X5 "BOOT

Инв.№ подл. Подп.и дата Взам.инв.№ Инв.№ дубл. Подп.дата Справ.№ Перв.примен.

АРБМ . 468157.011

Платапервичнойобработки сигнала С х е ма э л е ктр ч е ая н ц альная | . | Мас са | Масштаб

Из м . | Ли с т | № д о к у | По п | Дата
Разр аб. | | Мех вщи кова

Н. н тр
Утв

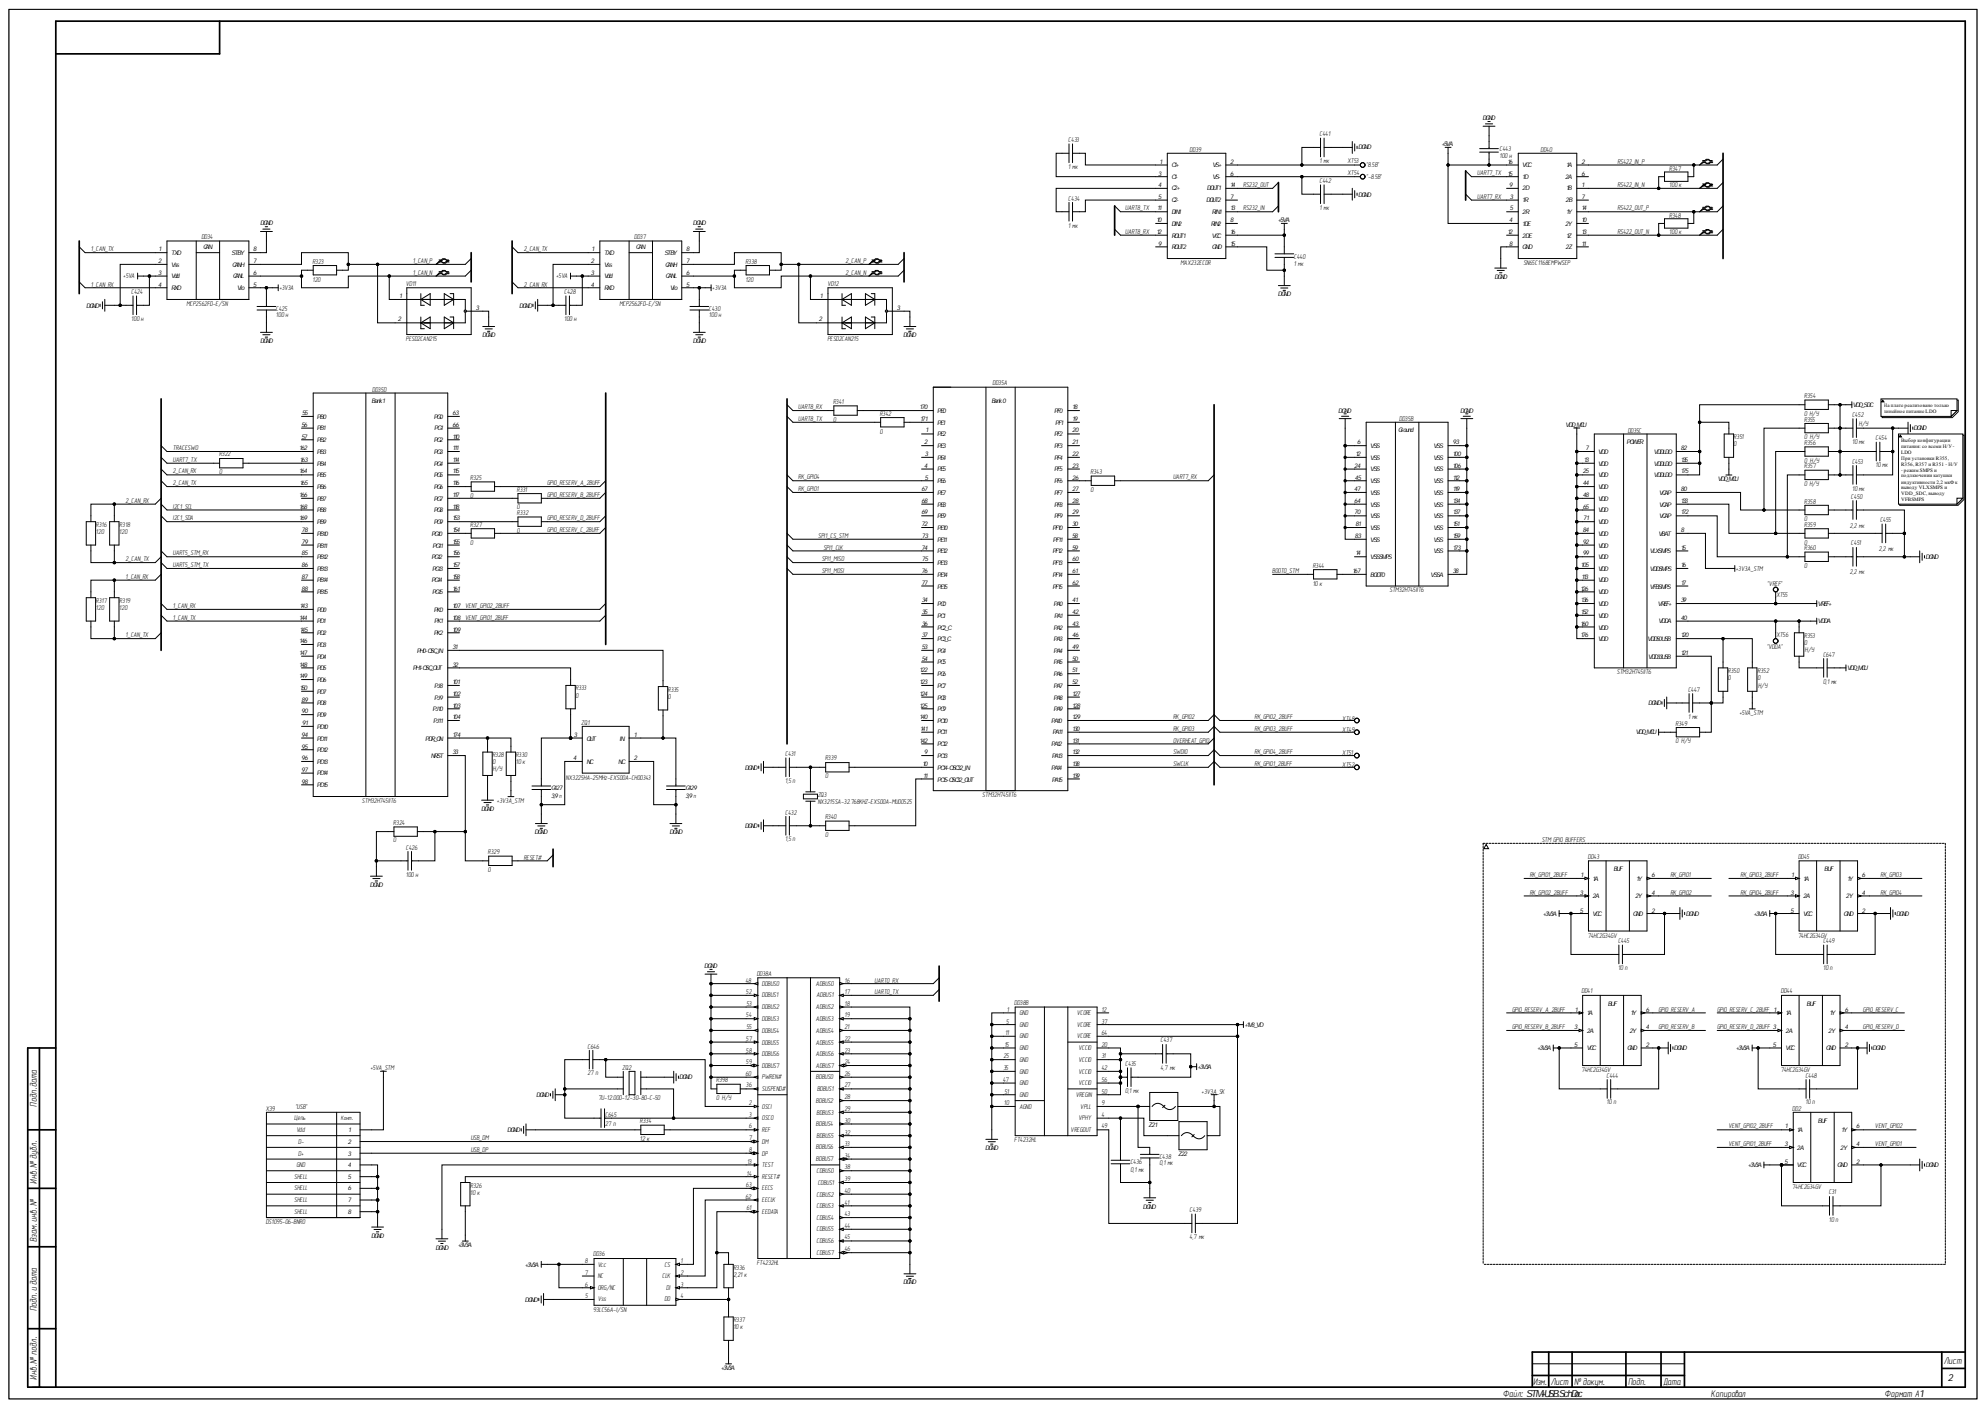
[picture p91: page 2]

C1- 3 | XT54 | UART7_TX | 1D 15 | R347

UART8_RX | DIN2 10 | 1DE 4 | R348

На плате реализовано только
линейное питание LDO

2 нв.№ подл. Подп.и дата Взам.инв.№ Инв.№ дубл. Подп.дата

Vcc 8 | CLK DI

ORG/NC 6 | 3

Лист

ALTIUMGOSTBOM2.0KEV

Изм. Лист | № докум. | Подп. | Дата

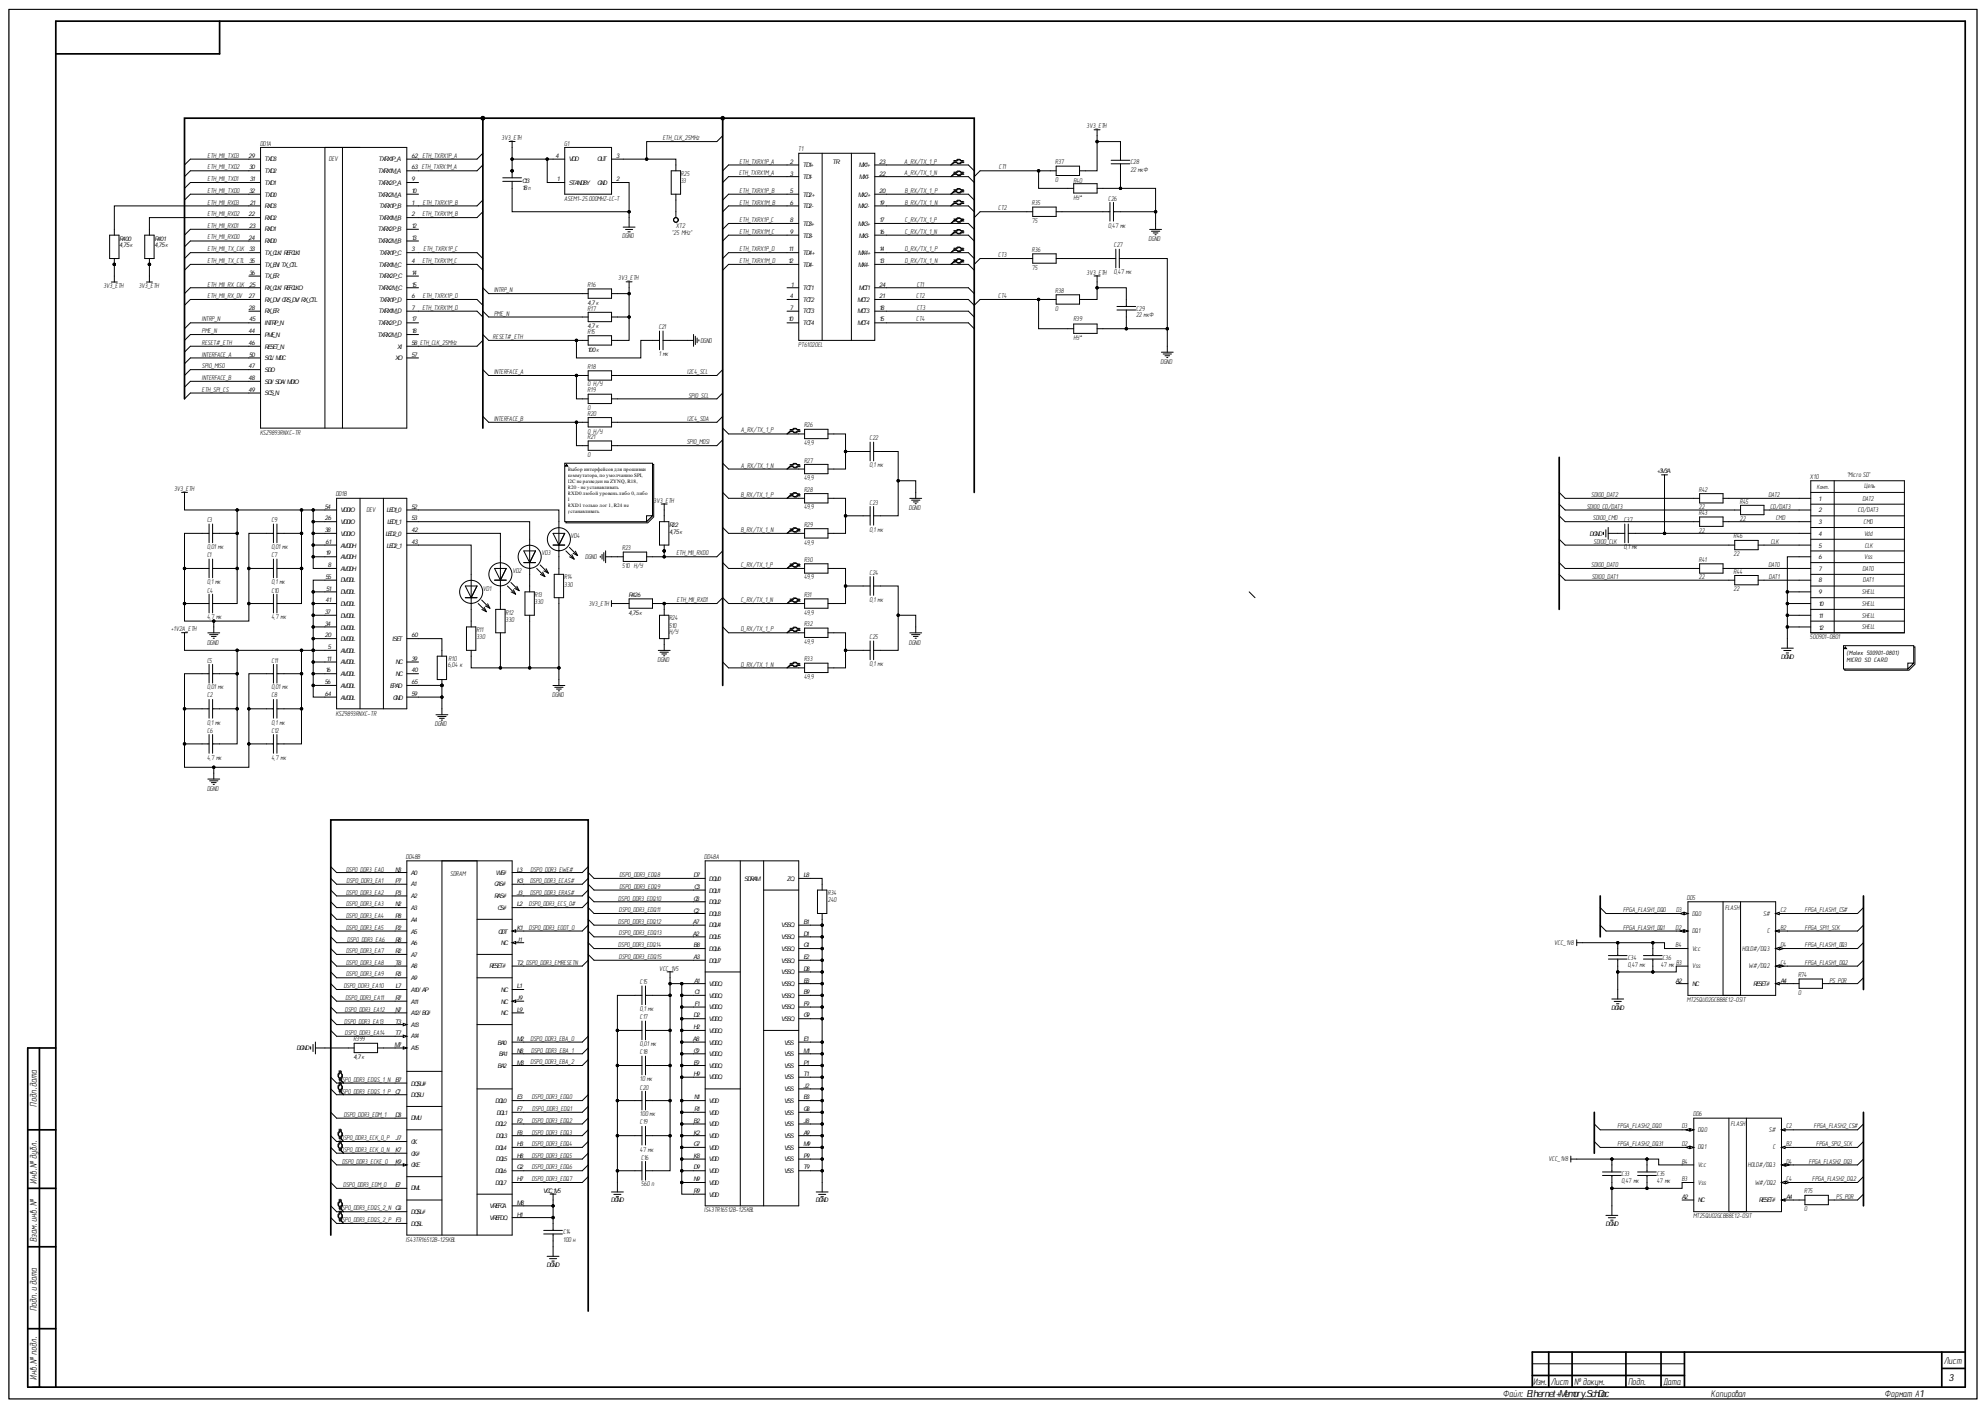
[picture p92: page 3]

RE SE T#_ E TH 46 I NTE RFA C E_A 50 | 58 57 | I NTE RFA C E_A | 100 к | I | PT61 020E L

SHELL SHELL

DSP0_ DDR3_ E A 1 P7 | K3 DSP0_ DDR3_ E C A S# | DSP0_ DDR3_ E DQ 9 C3

DSP0_ DDR3_ E A 2 P3 | J3 DSP0_ DDR3_ E RA S# | DSP0_ DDR3_ E DQ 1 0 C8 | VSSQ VSSQ VSSQ VSSQ VSSQ VSSQ VSSQ VSSQ VSSQ

нв.№ подл. Подп.и дата Взам.инв.№ Инв.№ дубл. Подп.дата

DSP0_ DDR3_ E DQ S_ 2_ N G3 | VREFCA VREFDQ

DQSL# DQSL | H1

I S43 TR1 65 1 2B- | 1 25 KBL | C 1

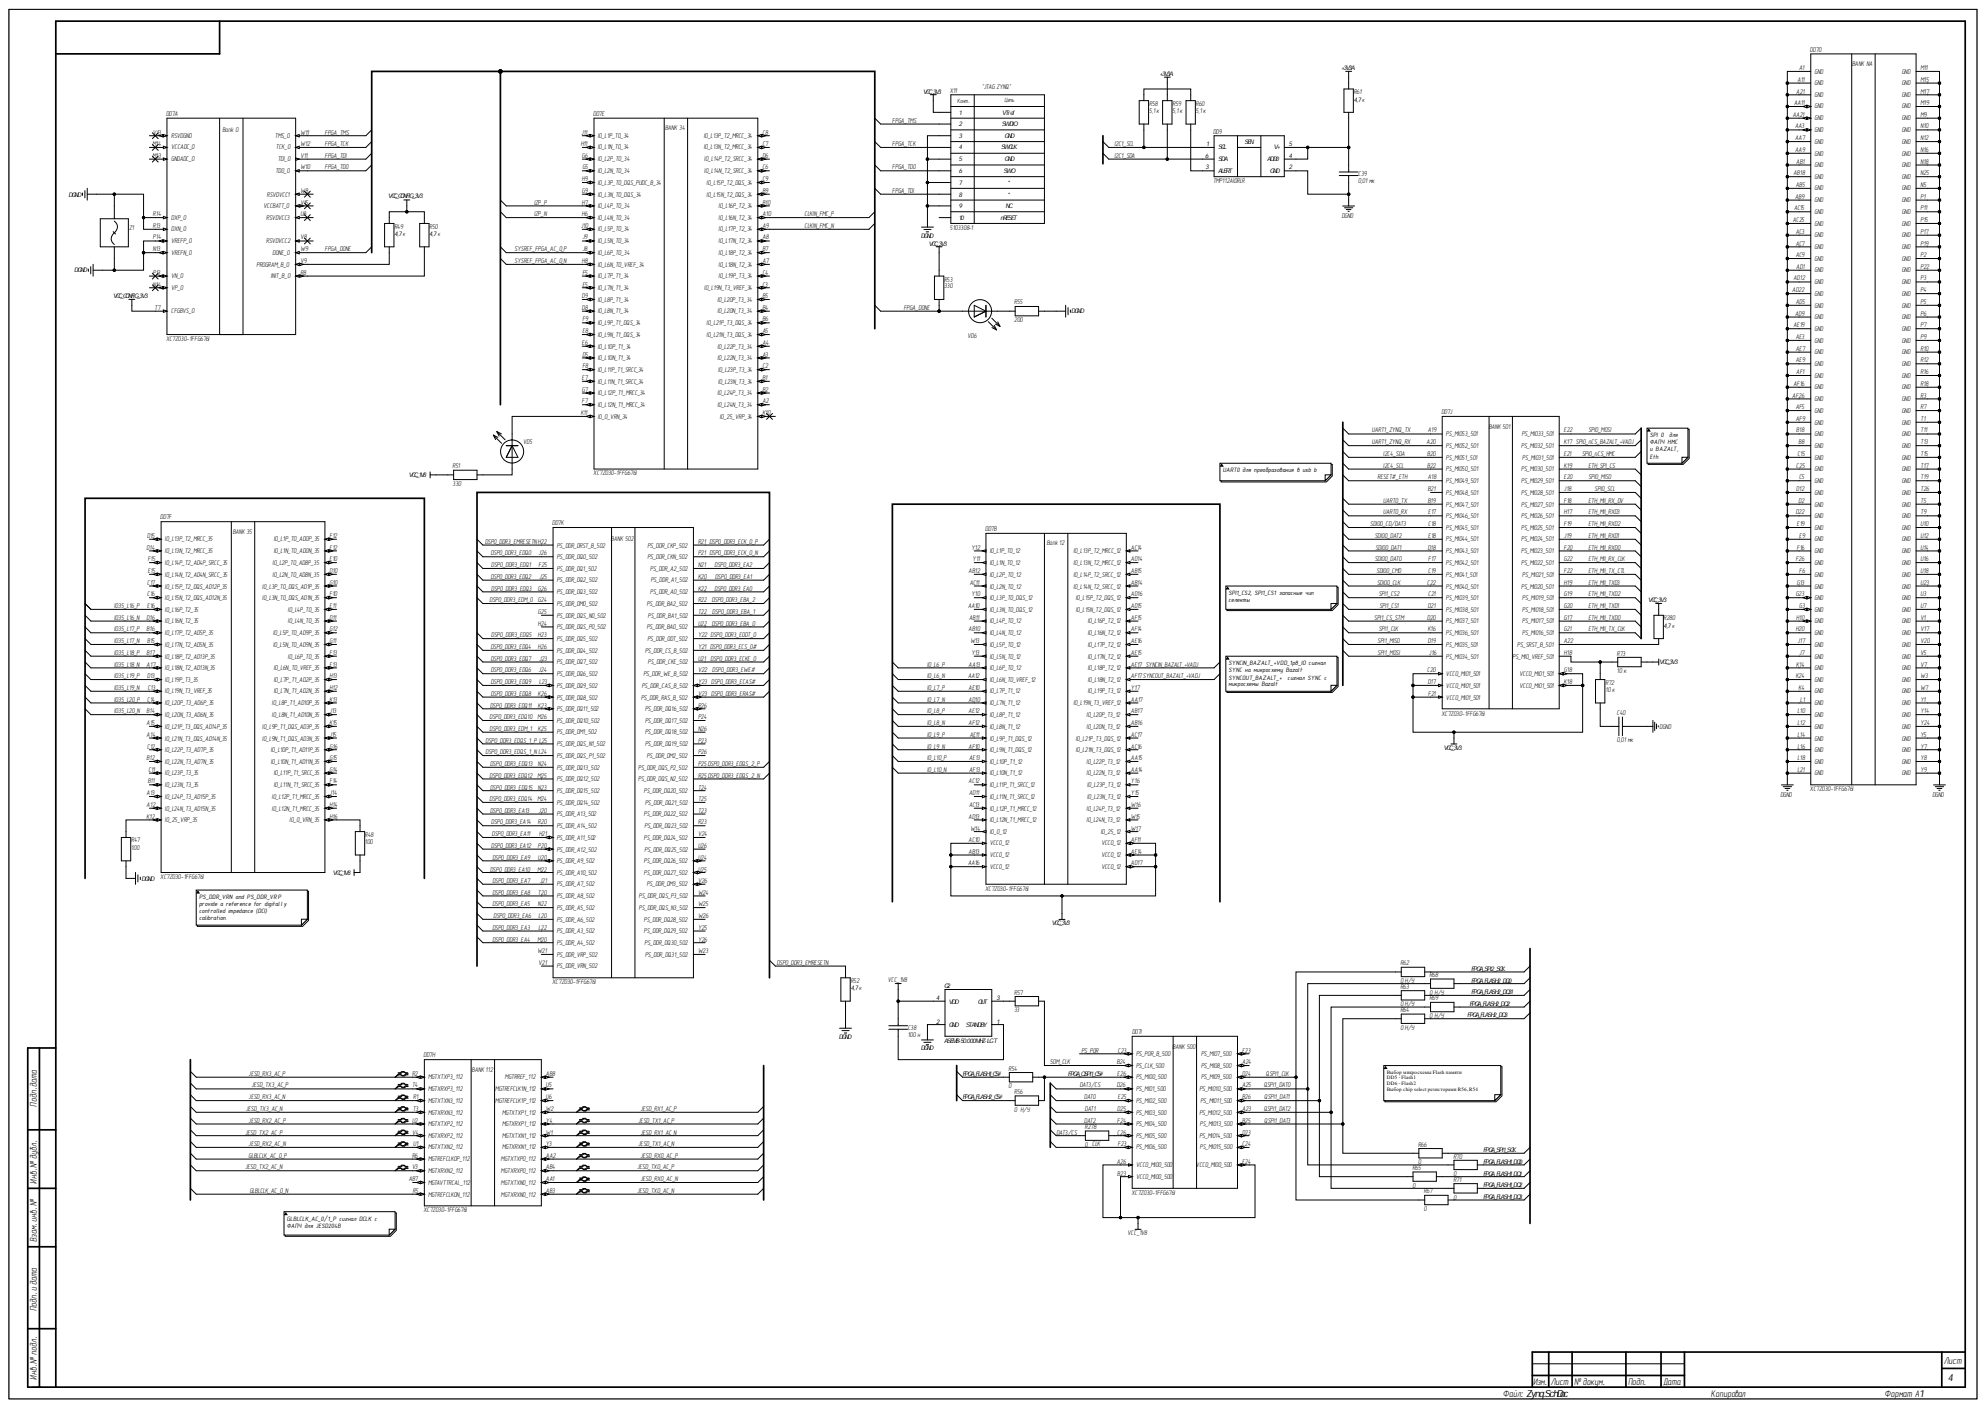
[picture p93: page 4]

GND A1

SYNCIN_BAZALT_+VDD_1p8_IO сигнал
SYNC на микросхему Bazalt
SYNCOUT_BAZALT_+ сигнал SYNC с

PS_DDR_VRN and PS_DDR_VRP
provide a reference for digitally
controlled impedance (DCI)
calibration.

4 нв.№ подл. Подп.и дата Взам.инв.№ Инв.№ дубл. Подп.дата

Выбор микросхемы Flash памяти

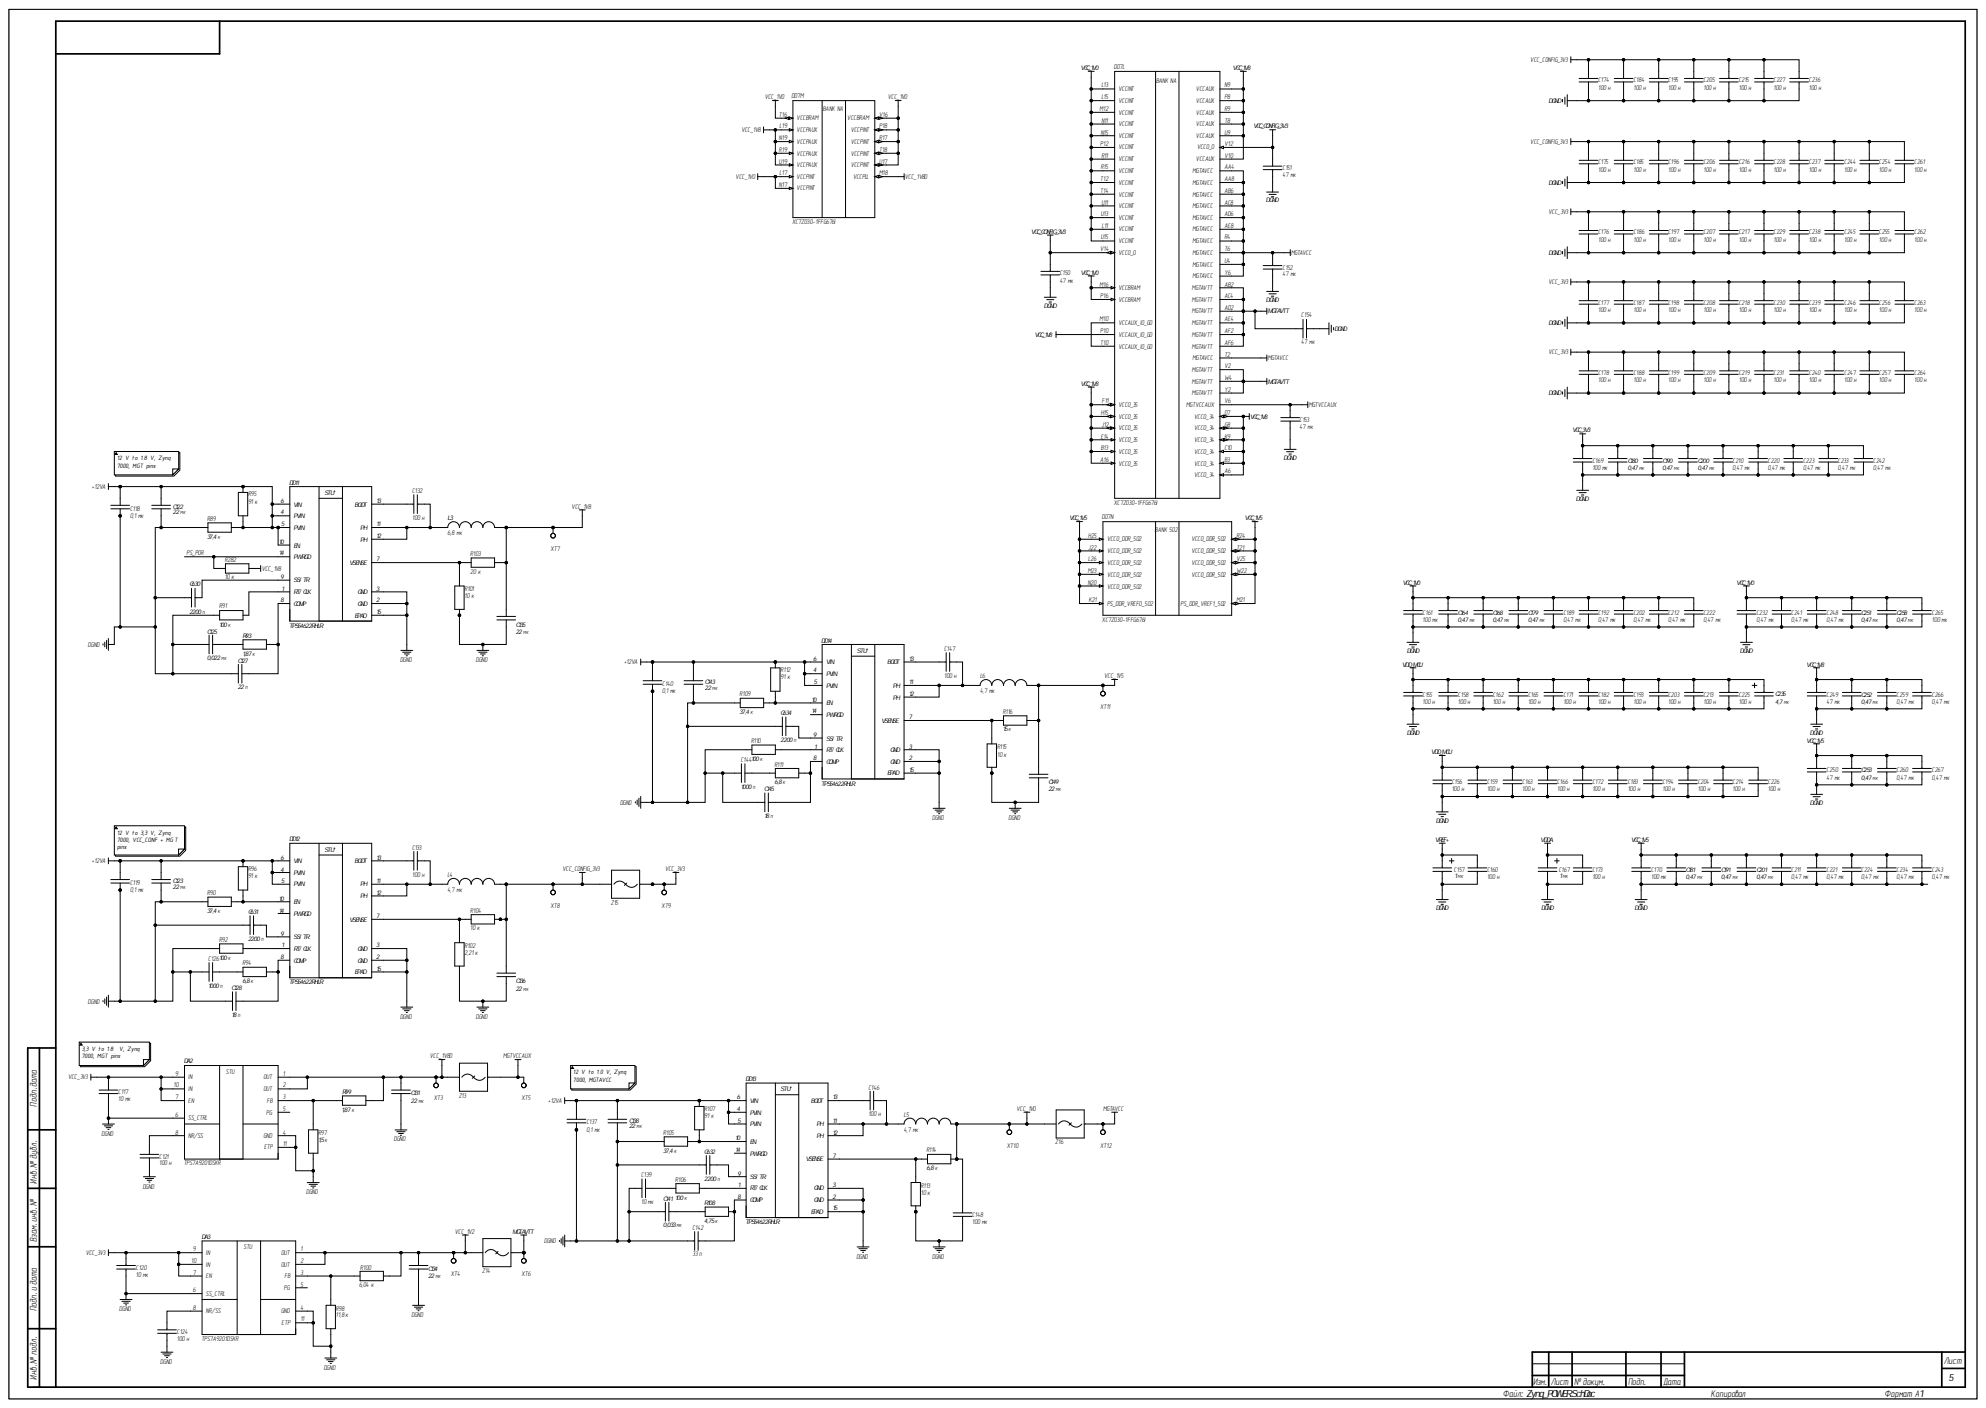
[picture p94: page 5]

VCCINT U11 | DGND

VCCINT L11 | C176 C186 C197 C207 C217 C229 C238 C245 C255

VCCAUX_IO_G0 P10

VCCAUX_IO_G0 T10

VIN 6 | STU* | GND EPAD
PVIN 4 | | | XC7Z030-1FFG676I

R91 | | | COMP 8 | | 2

VIN 6 | STU* | GND

PVIN 4

COMP 8 | | | 2

100 к | | COMP 8 | 2

5 нв.№ подл. Подп.и дата Взам.инв.№ Инв.№ дубл. Подп.дата

IN 10 | STU

SS_CTRL 6

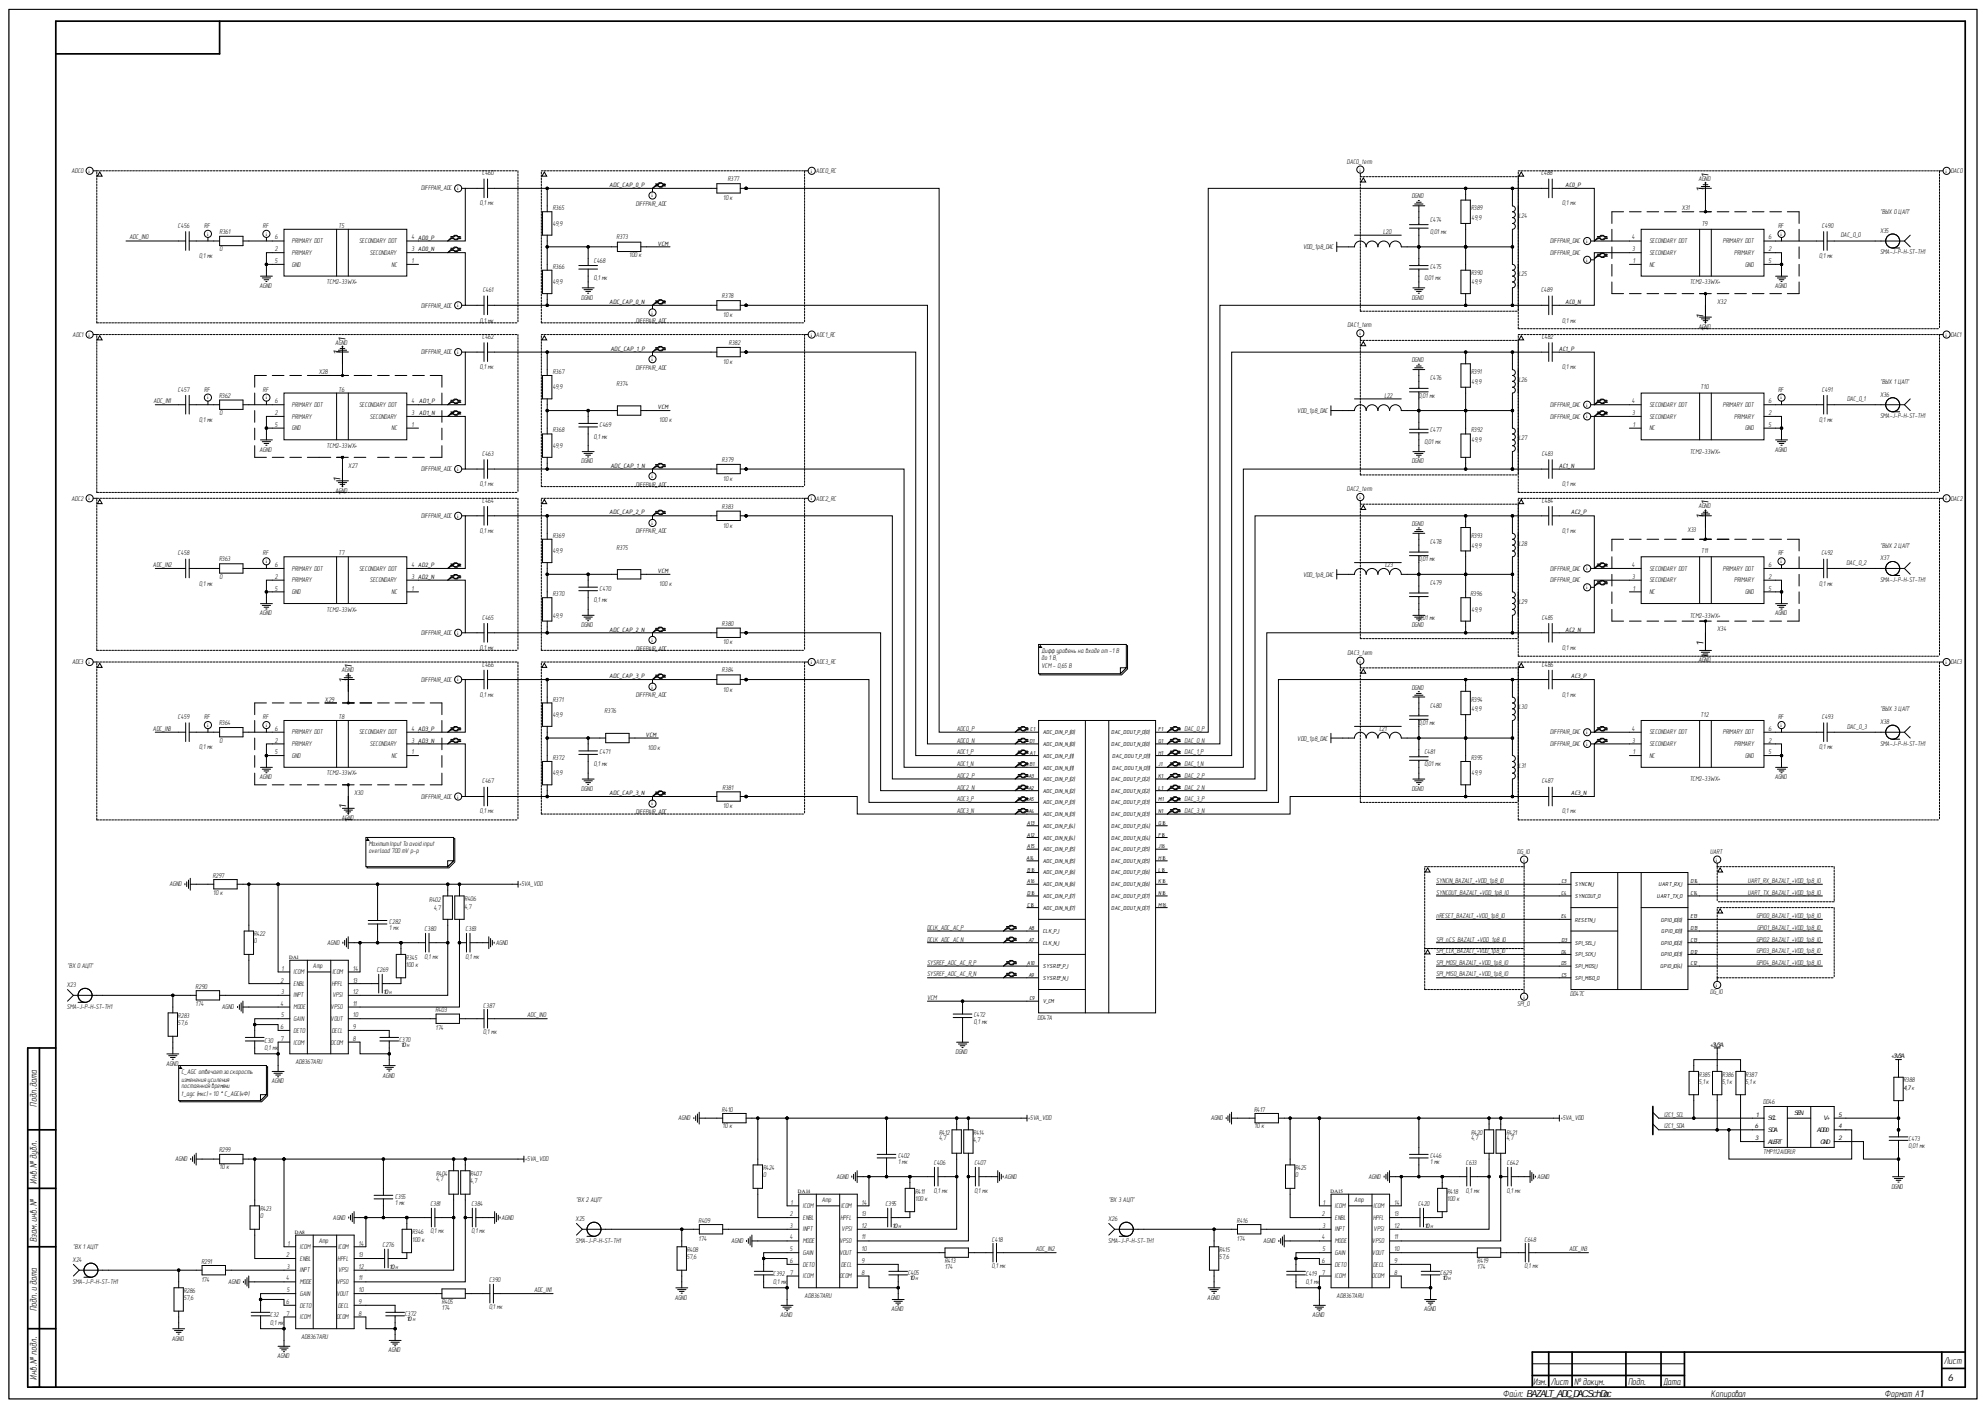
[picture p95: page 6]

DGND DGND DGND DGND

DGND DGND

нв.№ подл. Подп.и дата Взам.инв.№ Инв.№ дубл. Подп.дата

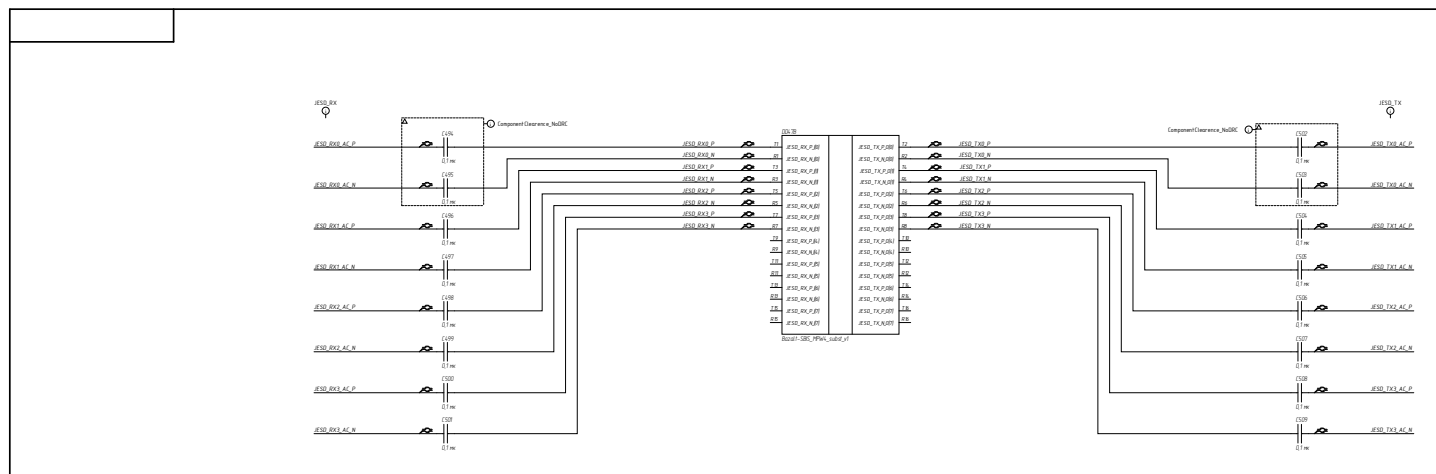
[picture p96: page 7]

J ESD_RX 1_ P | T3 | T4 | J ESD_TX 1_ P

J ESD_RX 1_ N | R3 | R4 | J ESD_TX 1_ N

J ESD_RX 2_ P мк J ESD_RX 2_ N | T5 R5 | T6 R6 | J ESD_TX 2_ P J ESD_TX 2_ N

J ESD_RX 3_ P | T7 | T8 | J ESD_TX 3_ P

J ESD_RX 3_ N | R7 | R8 | J ESD_TX 3_ N

нв.№ подл. Подп.и дата Взам.инв.№ Инв.№ дубл. Подп.дата

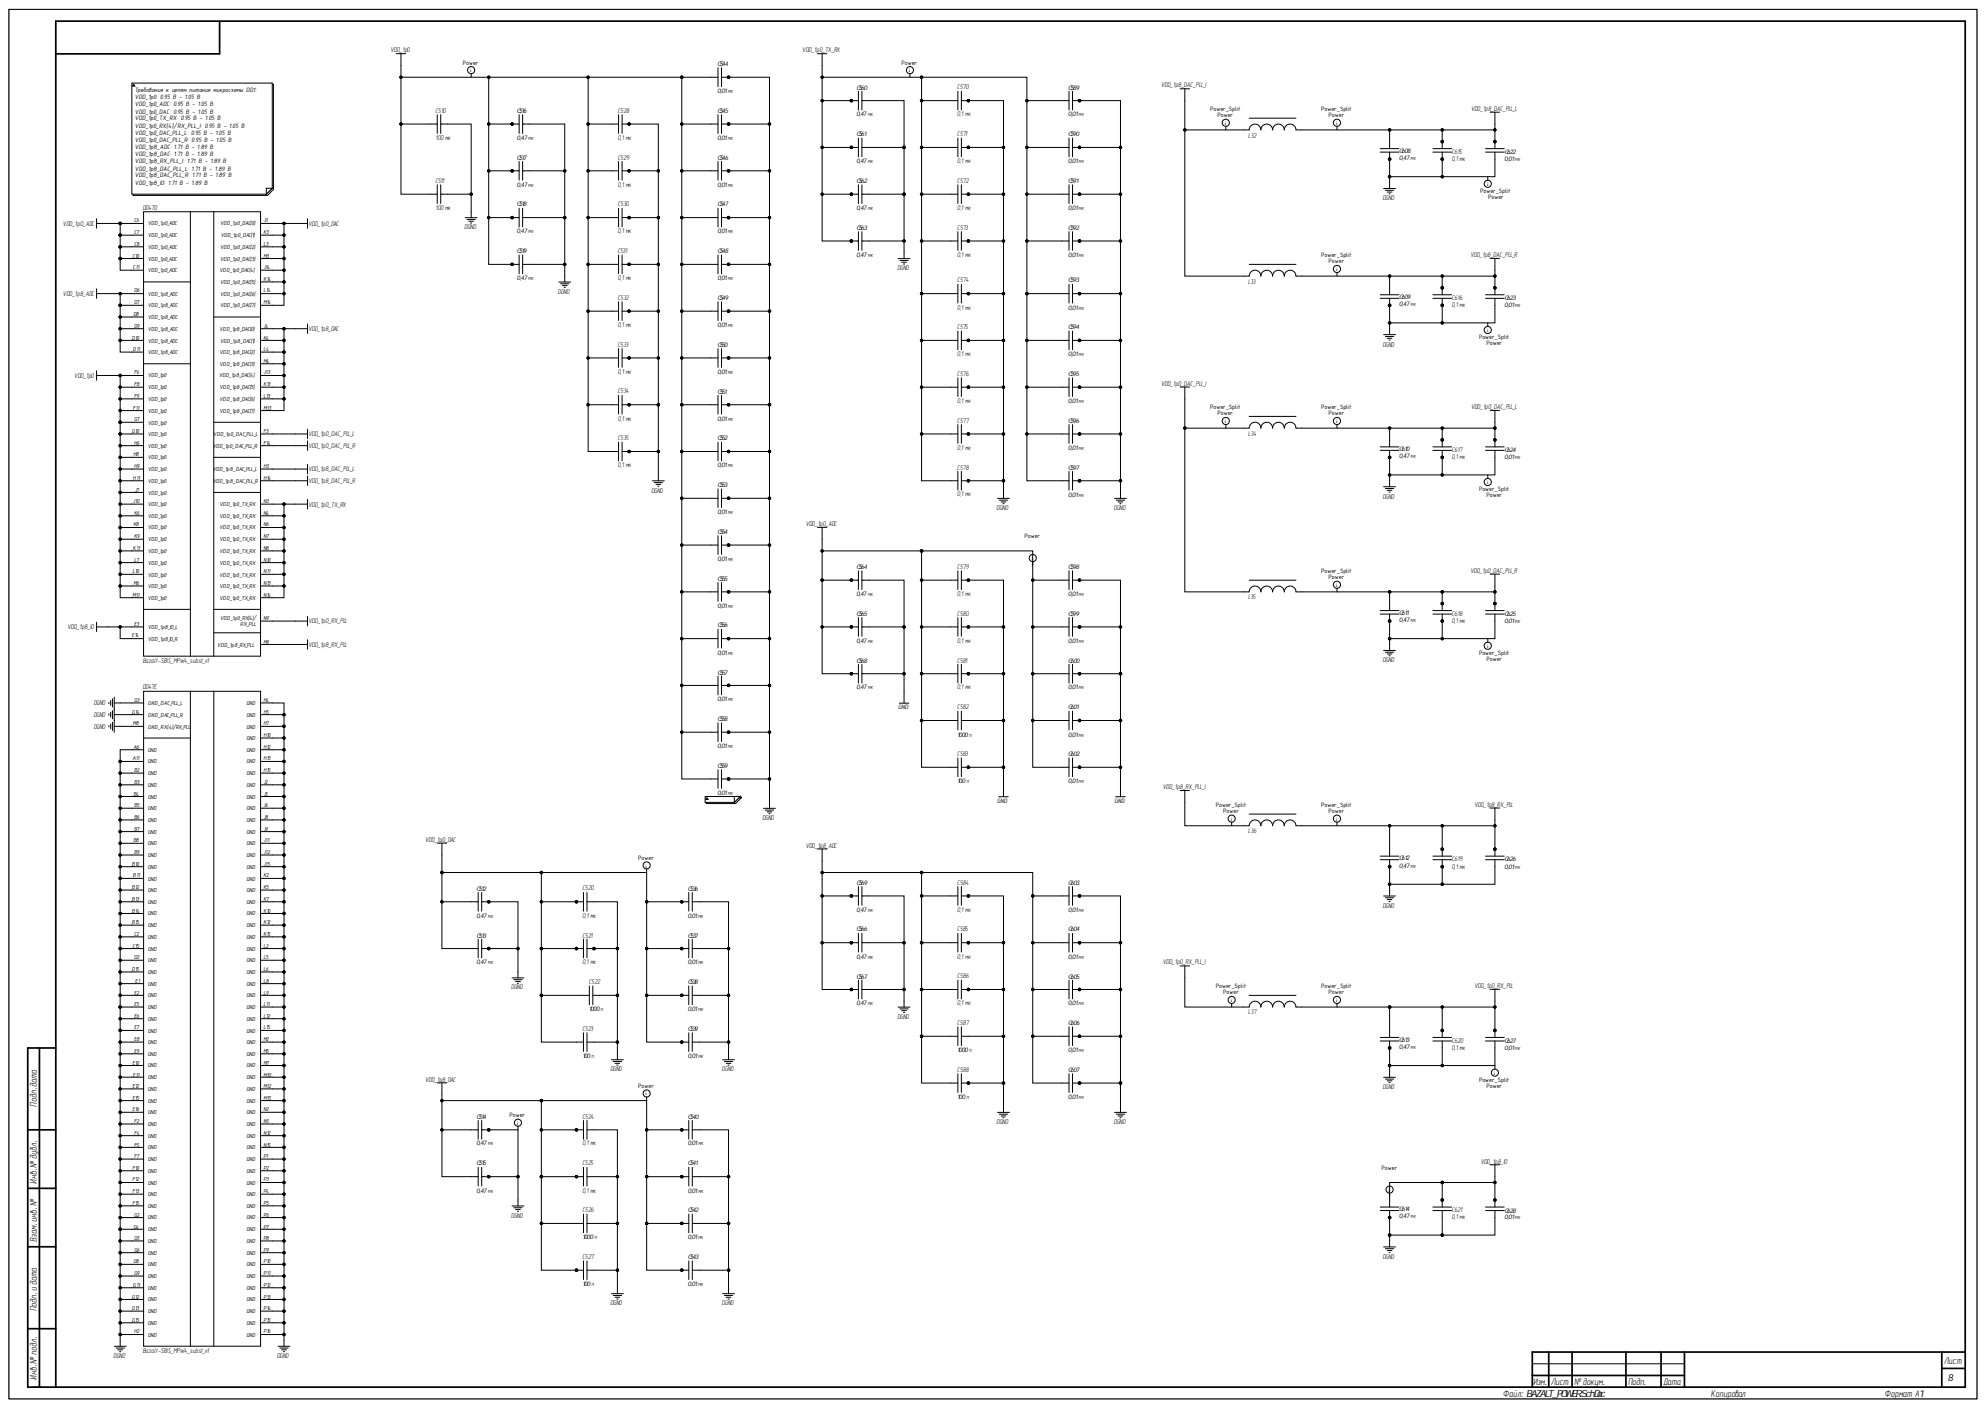
[picture p97: page 8]

DGND DGND DGND DGND DGND DGND DGND

нв.№ подл. Подп.и дата Взам.инв.№ Инв.№ дубл. Подп.дата

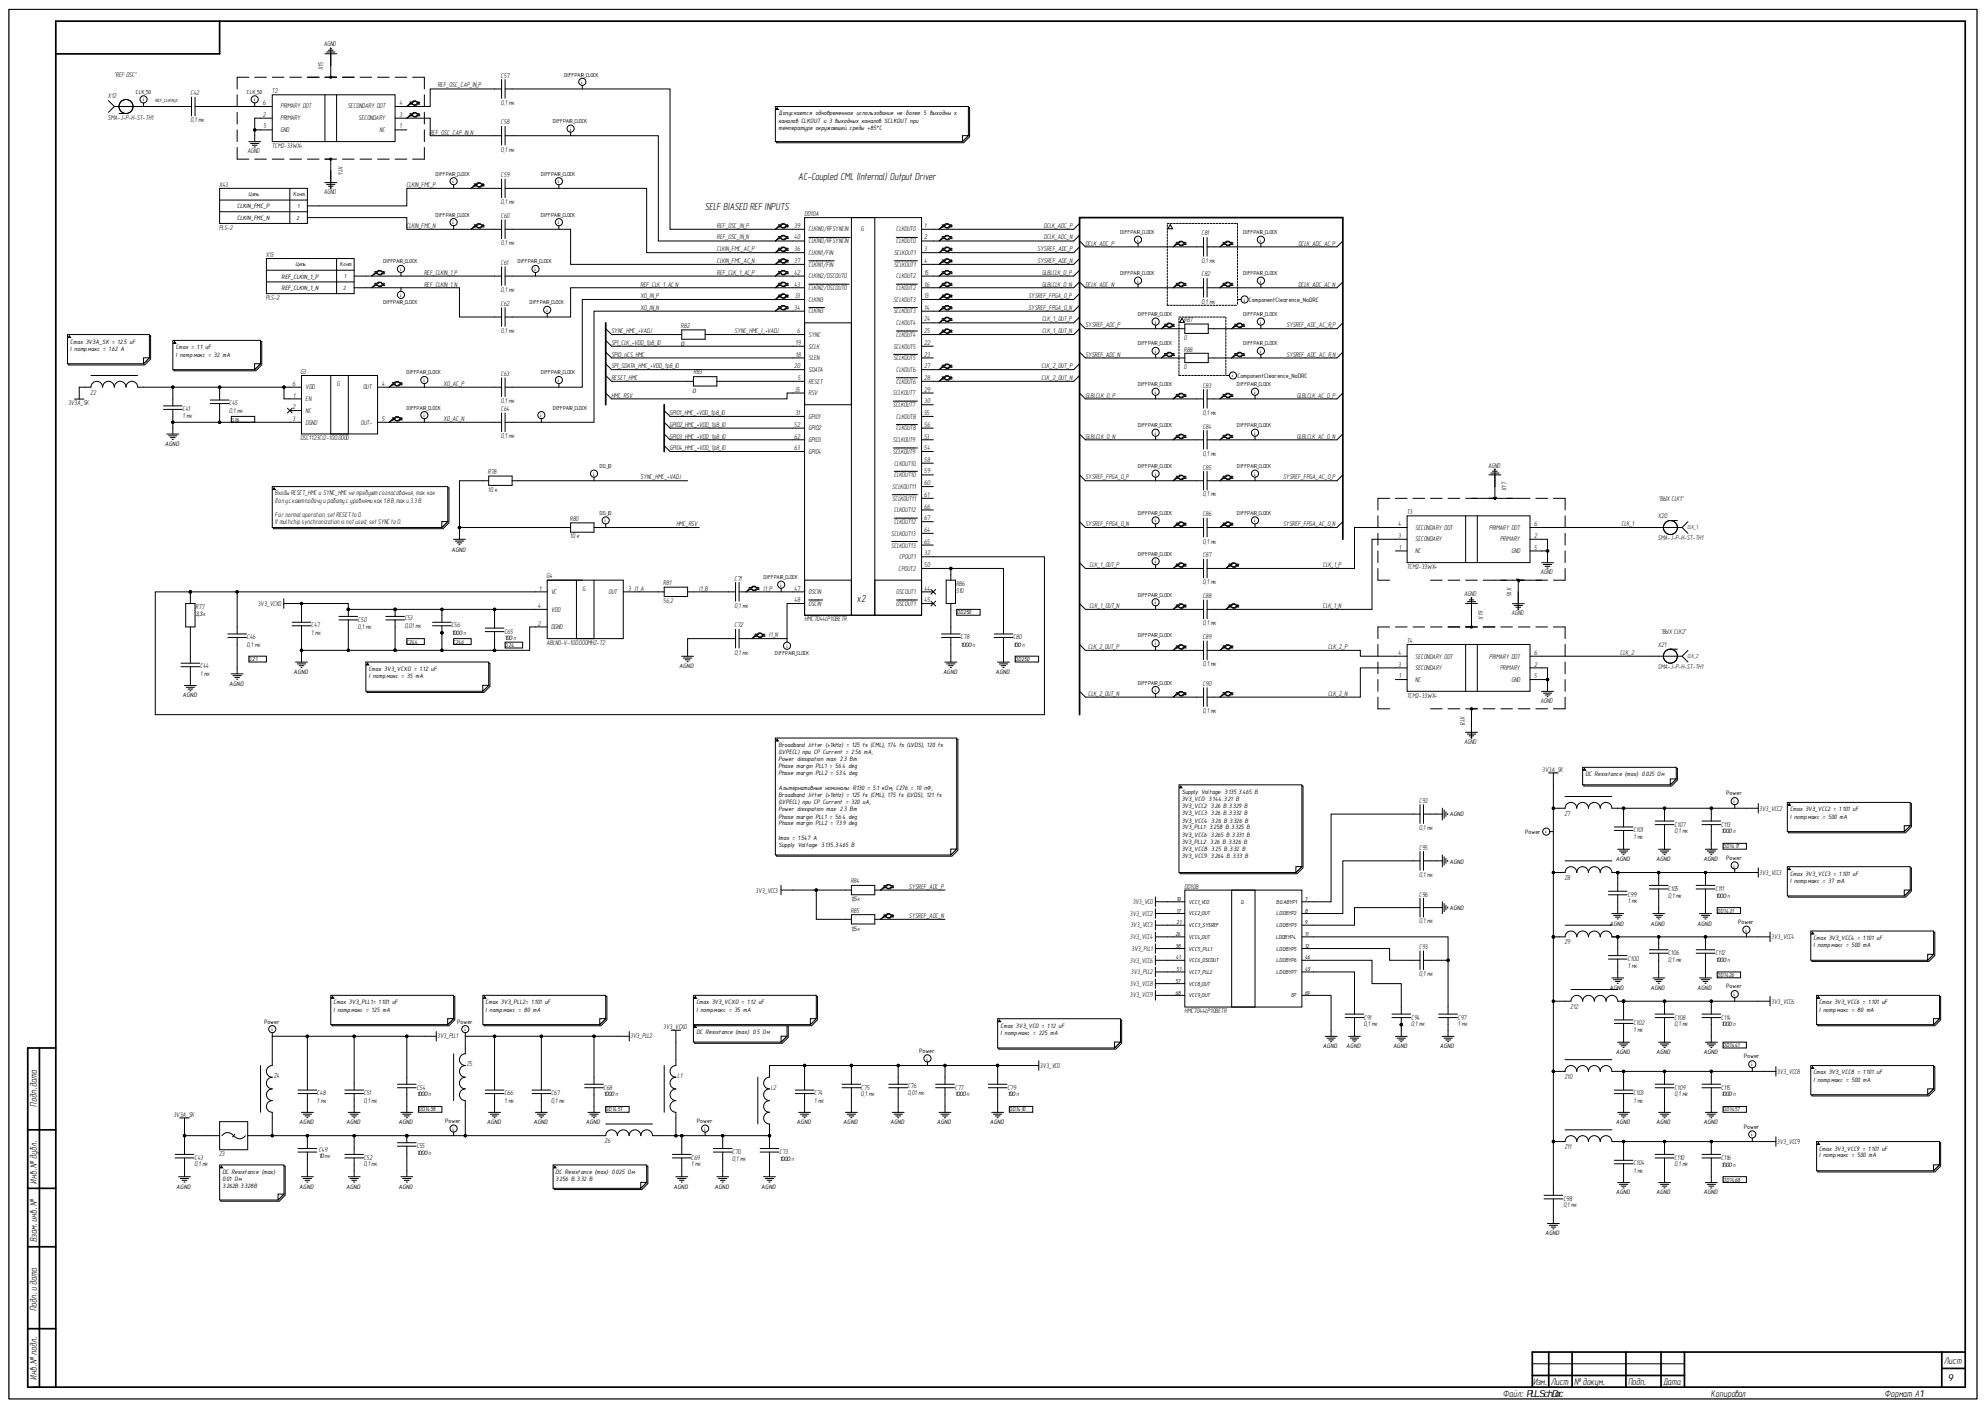
[picture p98: page 9]

PRIMARY DOT 6

PRIMARY 2

Допускается одновременное использование не более 5 выходных
каналов CLKOUT и 3 выходных каналов SCLKOUT при
температуре окружающей среды +85°C

AC-Coupled CML (Internal) Output Driver

SELF BIASED REF INPUTS

DIFFPAIR_CLOCK | HMC_RSV 0

R78 | DG_IO i SYNC_HMC_+VADJ | GPIO2_HMC_+VDD_1p8_IO GPIO3_HMC_+VDD_1p8_IO | GPIO3 62

Входы RESET_HMC и SYNC_HMC не требуют согласования, так как
допускаютподачуиработусуровнямикак1.8 В, таки3.3 В.

For normal operation,set RESET to 0.
If multichipsynchronizationisnot used,set SYNCto 0.

Broadband Jitter (>1kHz) = 125 fs (CML), 174 fs (LVDS), 120 fs
(LVPECL) при CP Current = 2.56 mA;
Power dissipation max: 2.3 Вт
Phase margin PLL1 = 56.4 deg
Phase margin PLL2 = 53.4 deg

Альтернативные номиналы: R130 = 5.1 кОм, С276 = 10 пФ;
Broadband Jitter (>1kHz) = 125 fs (CML), 175 fs (LVDS), 121 fs
(LVPECL) при CP Current = 320 uA;
Phase margin PLL2 = 73.9 deg

DC Resistance (max): 0.025 Ом

DC Resistance (max): 0.5 Ом

9 нв.№ подл. Подп.и дата Взам.инв.№ Инв.№ дубл. Подп.дата

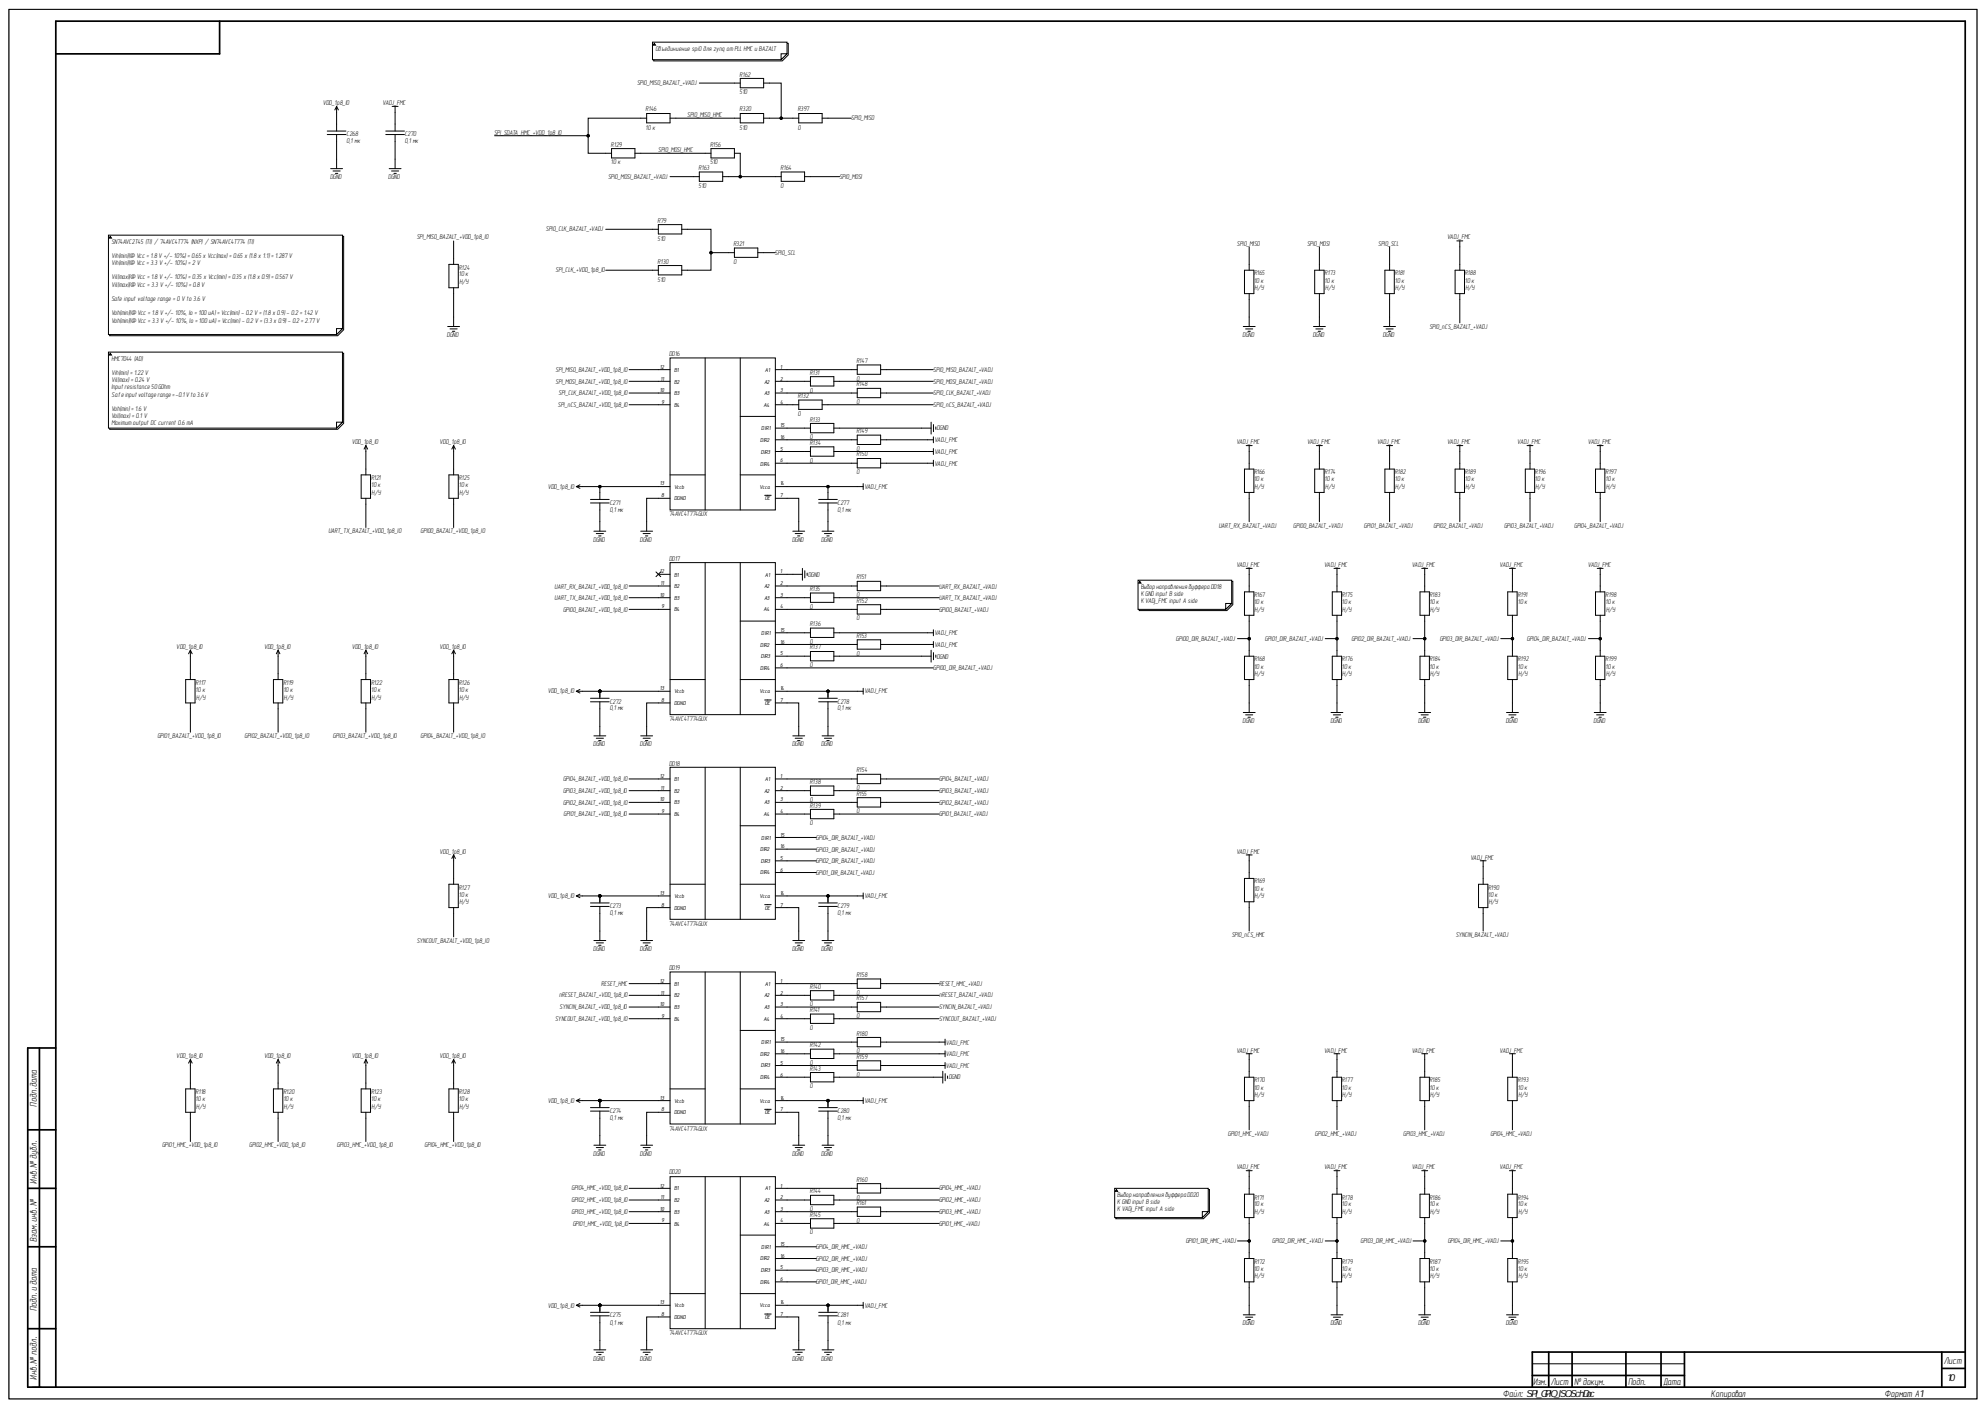
[picture p99: page 10]

Объединиение spi0 для zynq от PLL HMC и BAZALT

Vih(min)(@ Vcc = 1.8 V +/- 10%) = 0.65 x Vcc(max) = 0.65 x (1.8 x 1.1) = 1.287 V
Vih(min)(@ Vcc = 3.3 V +/- 10%) = 2 V

Vil(max)(@ Vcc = 1.8 V +/- 10%) = 0.35 x Vcc(min) = 0.35 x (1.8 x 0.9) = 0.567 V
Vil(max)(@ Vcc = 3.3 V +/- 10%) = 0.8 V

Voh(min)(@ Vcc = 1.8 V +/- 10%, Io = 100 uA) = Vcc(min) - 0.2 V = (1.8 x 0.9) - 0.2 = 1.42 V
Voh(min)(@ Vcc = 3.3 V +/- 10%, Io = 100 uA) = Vcc(min) - 0.2 V = (3.3 x 0.9) - 0.2 = 2.77 V

Safe input voltage range = 0 V to 3.6 V

Vol(max)(@ Io = 100 uA) = 0.2 V

Voh(min) = 1.6 V Vol(max) = 0.1 V

Maximum output DC current 0.6 mA

10 нв.№ подл. Подп.и дата Взам.инв.№ Инв.№ дубл. Подп.дата

Выборнаправлениябуффера DD20 К GND input B side

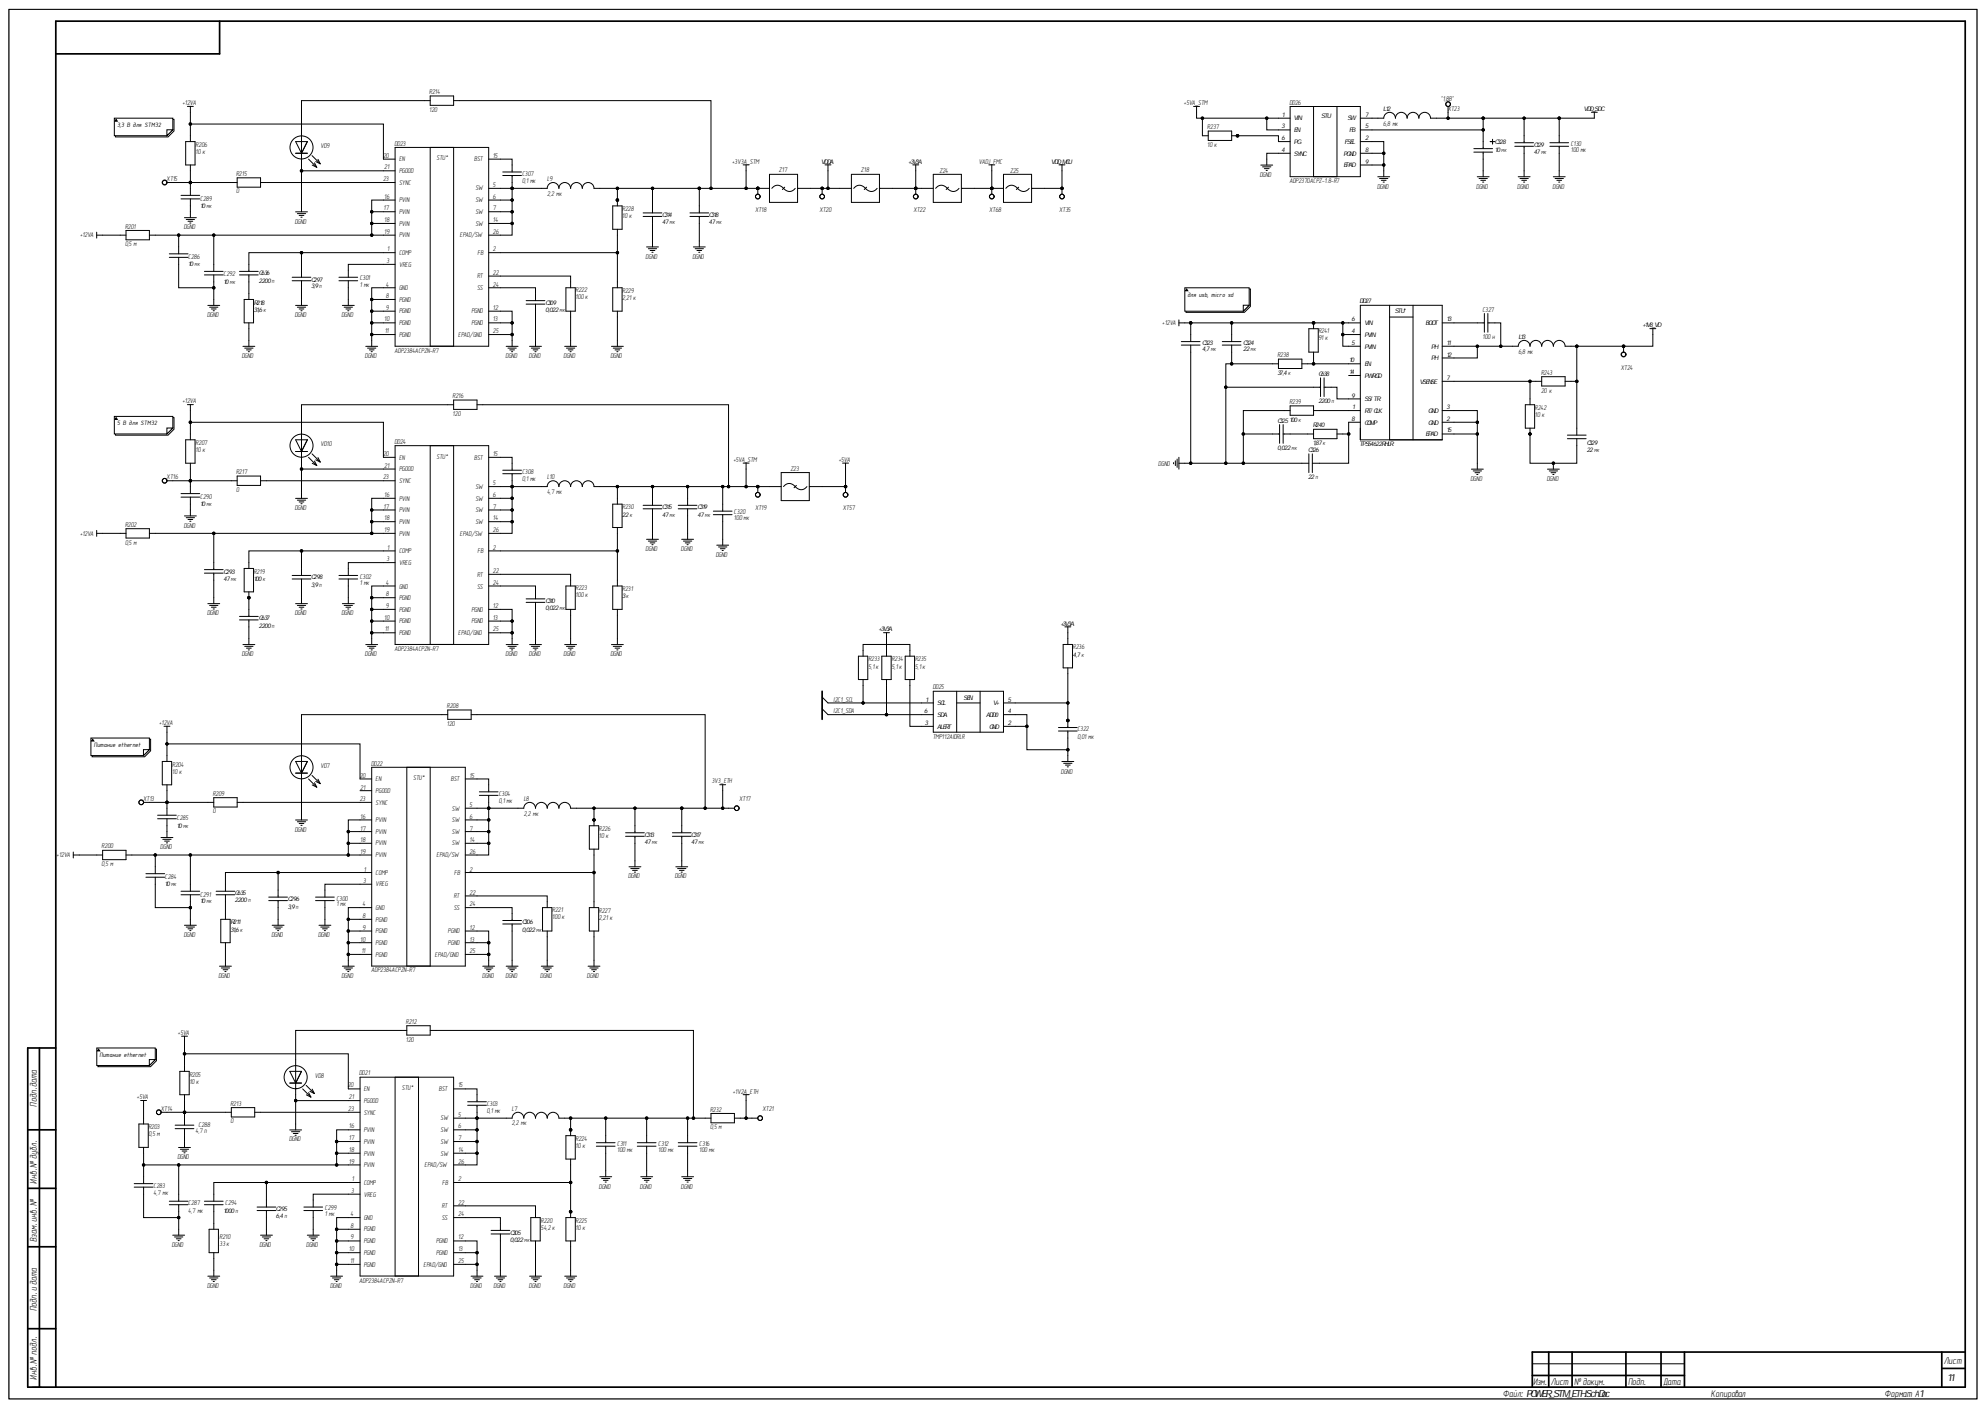
[picture p100: page 11]

I 2C 1_ SDA | | | 6 | 4

SCL SDA ALERT | SEN | V+ ADD0 GND

нв.№ подл. Подп.и дата Взам.инв.№ Инв.№ дубл. Подп.дата

21 | 5
23 | C

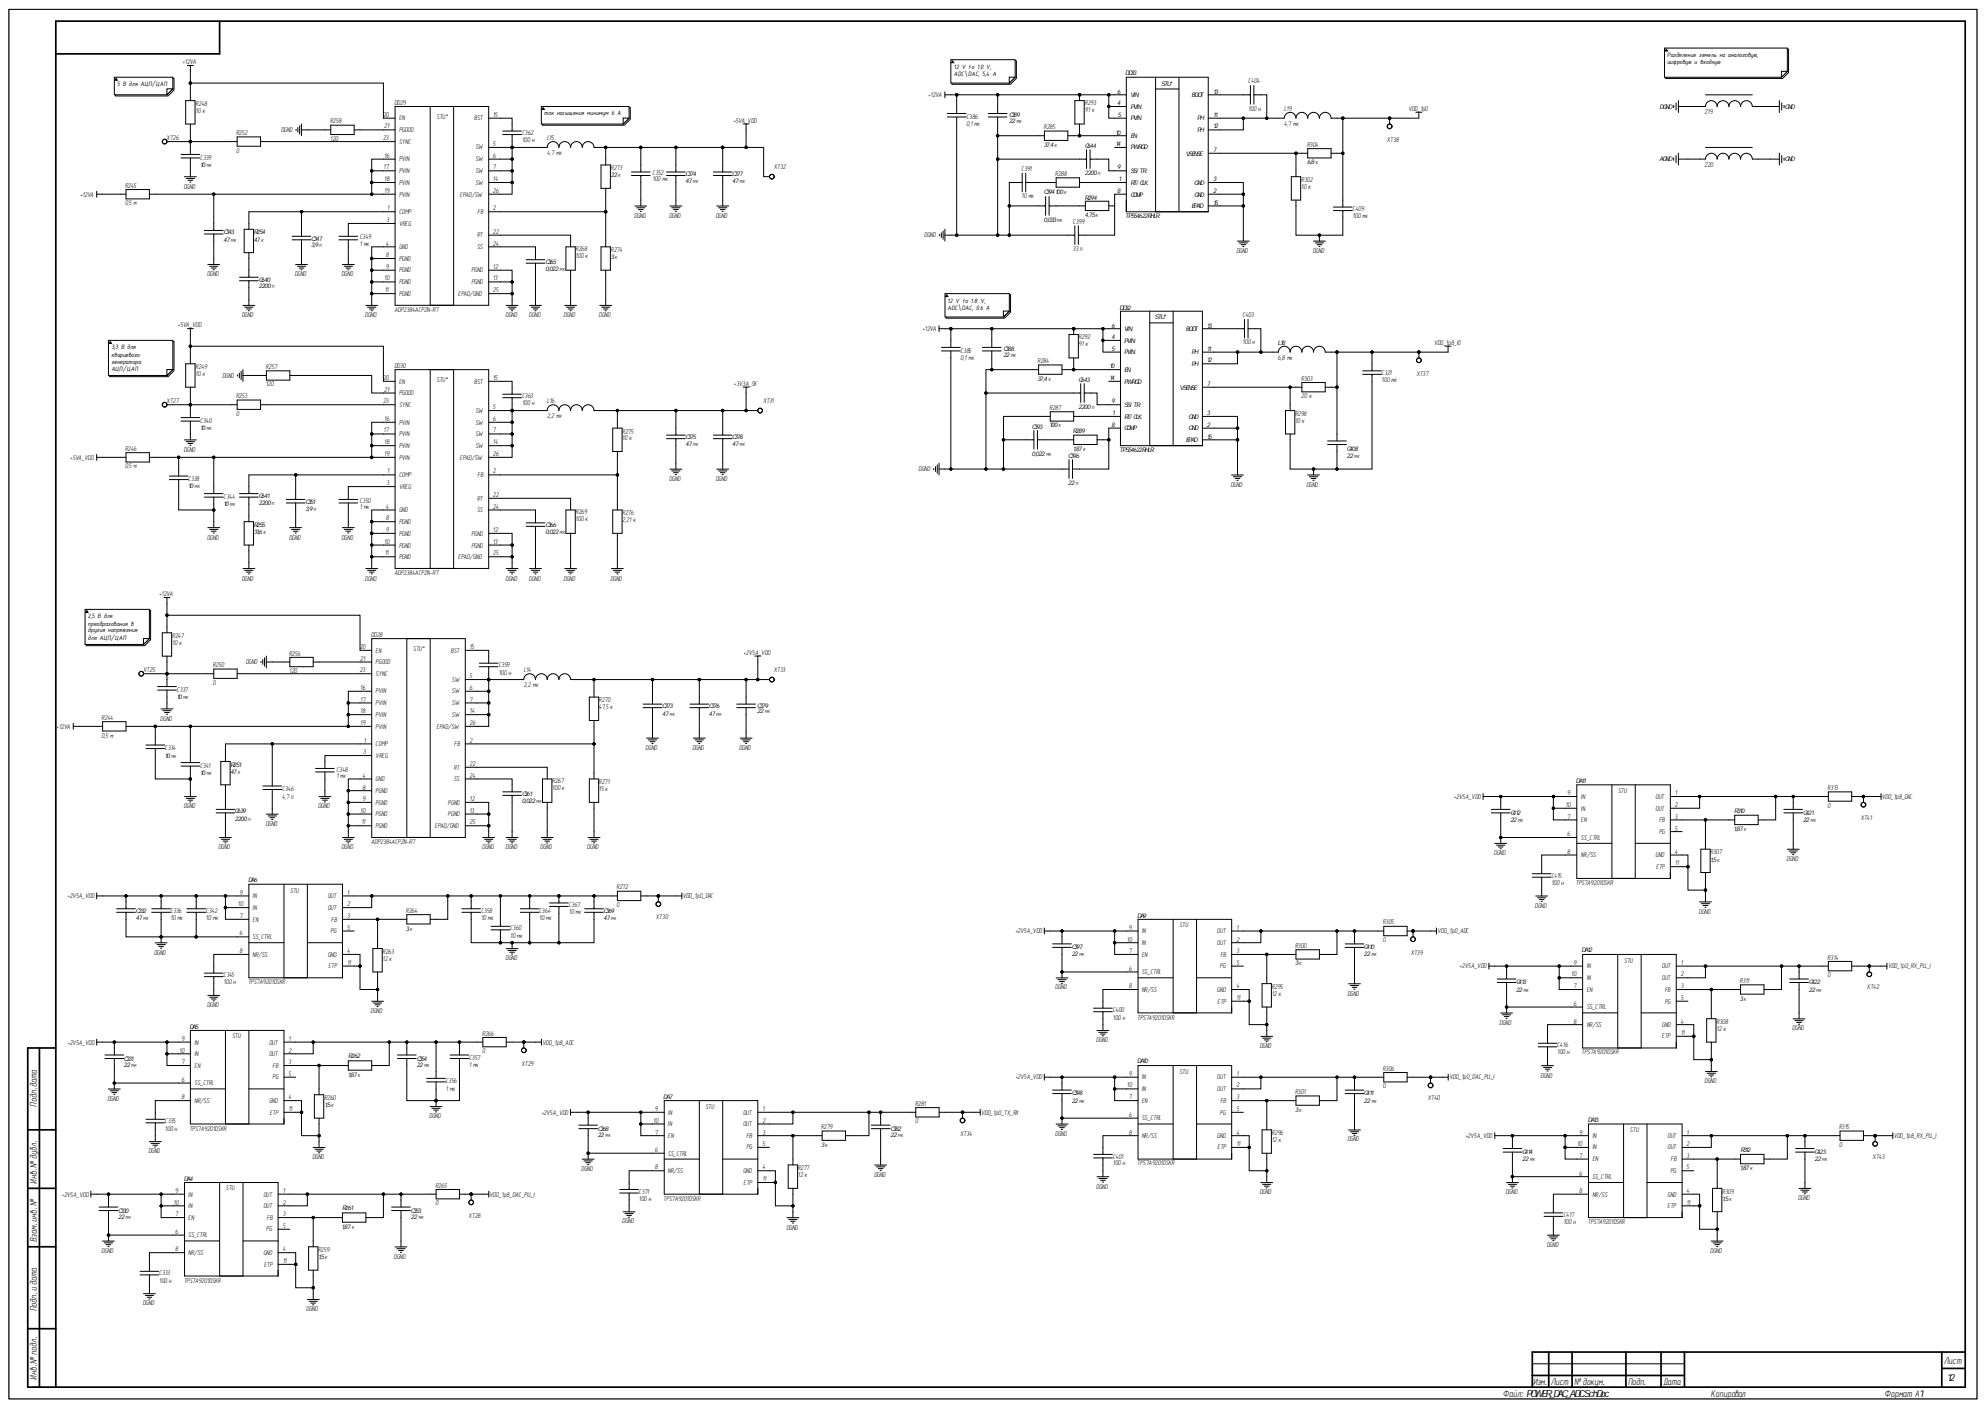
[picture p101: page 12]

E N PGOOD SY NC PV I N PV I N PV I N PV I N C OMP V RE G GND PGND PGND PGND PGND | STU * | BST SW SW SW SW E PA D/SW F B RT SS PGND PGND E PA D/GND

TPS54622RHLR DD32 VIN PVIN PVIN EN PWRGD SS/ TR RT/ CLK COMP | STU* | BOOT PH PH VSENSE GND GND EPAD

NR/SS | GND E TP

I N I N E N SS_ C TRL | STU | OUT OUT F B PG

нв.№ подл. Подп.и дата Взам.инв.№ Инв.№ дубл. Подп.дата
