prod1cys-cmd/RVN/Документы/АРБМ_468157.011СБ - Плата ПОС.pdf

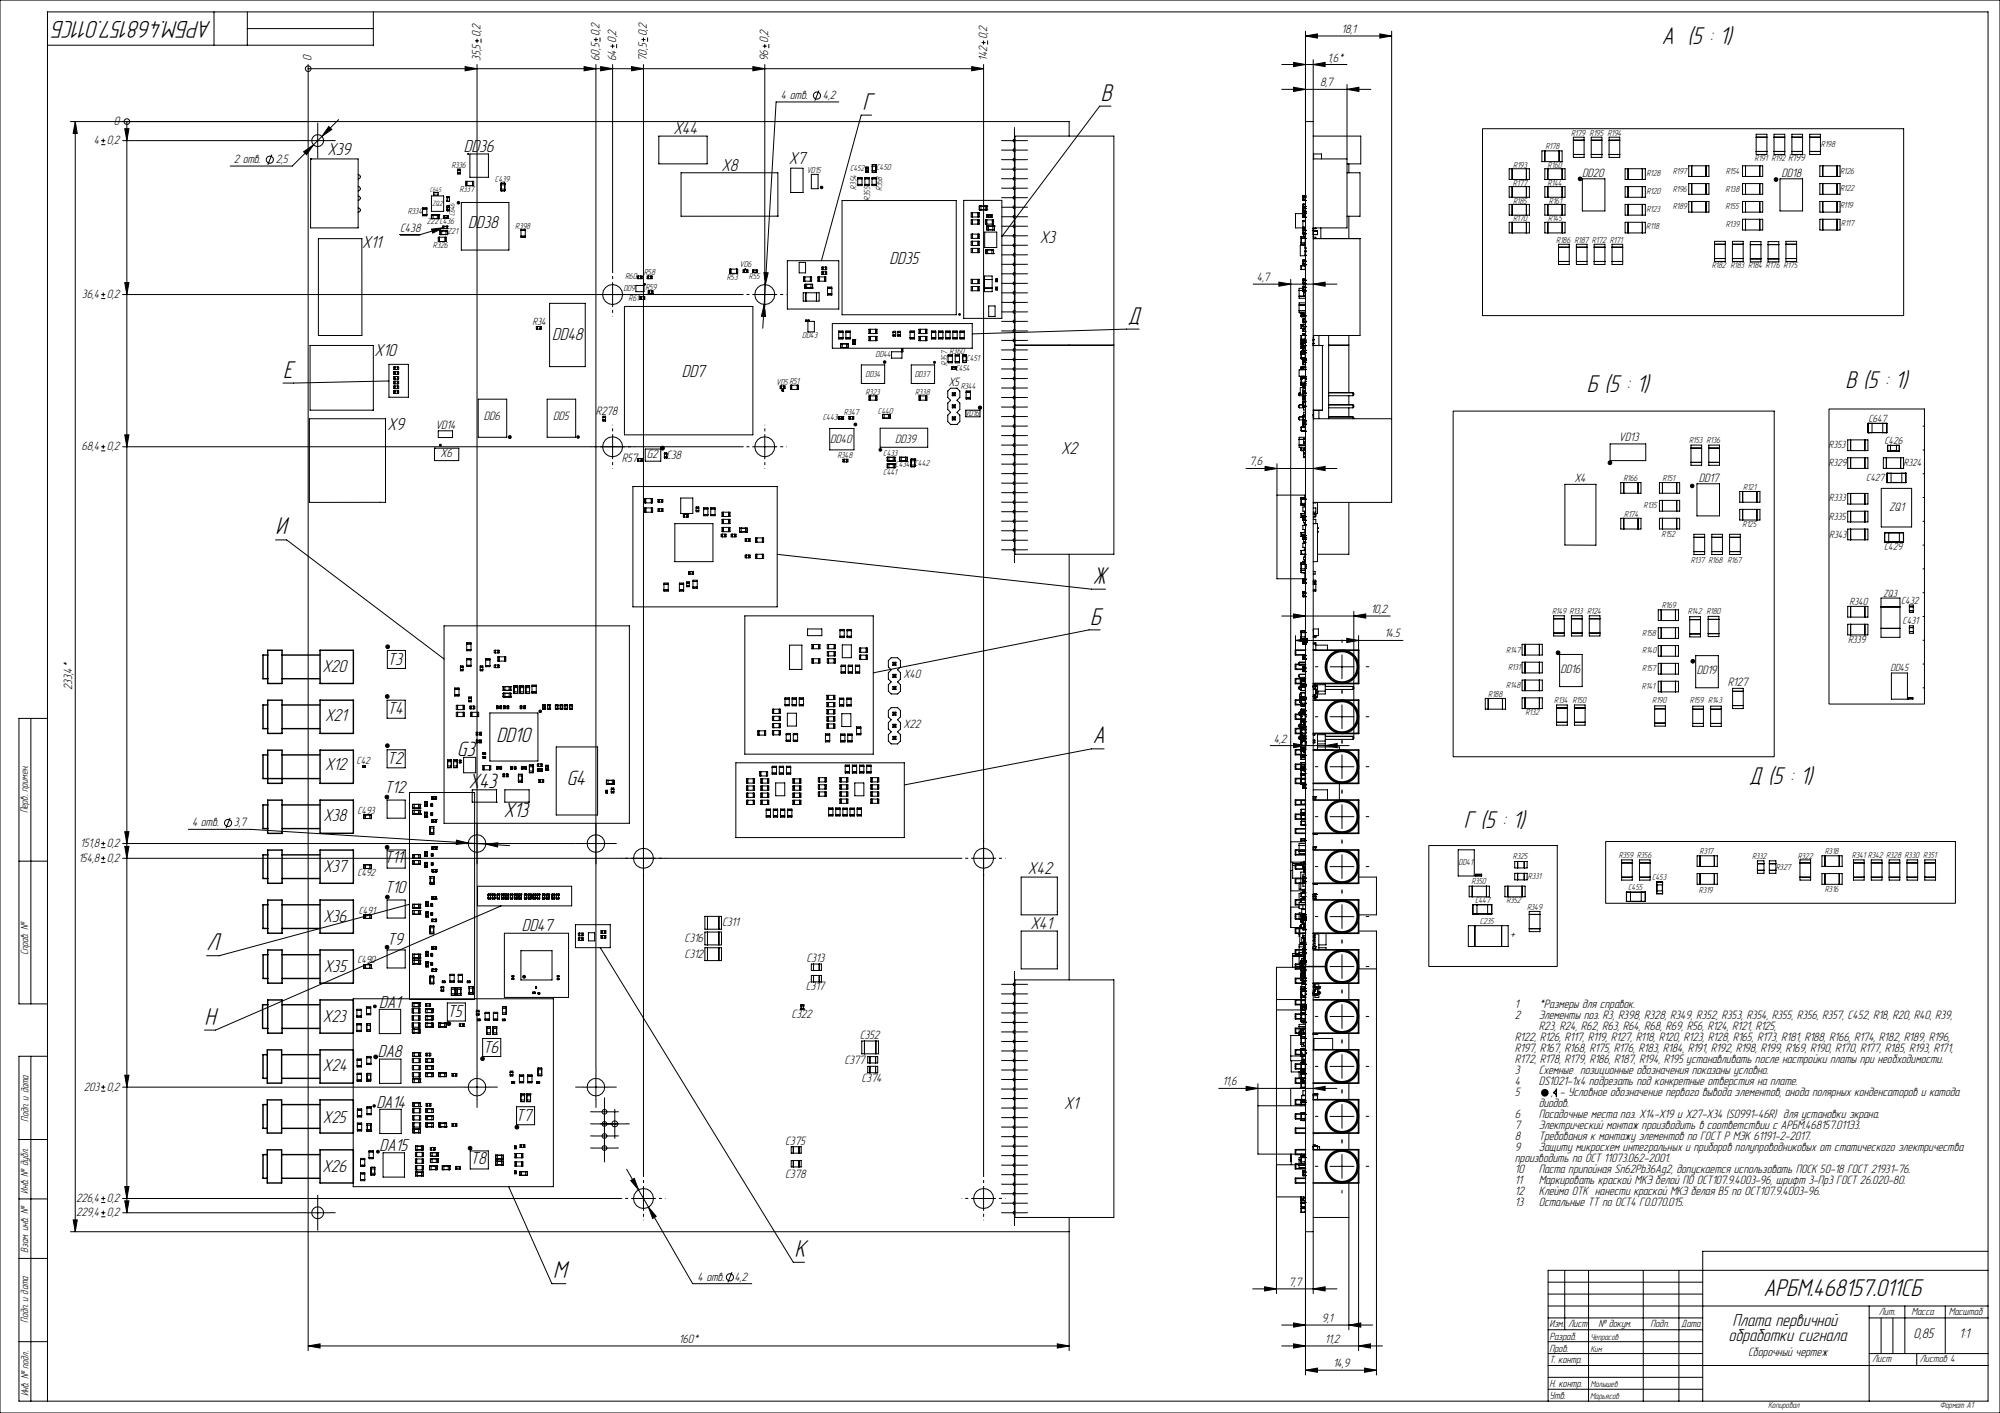
[picture p102: page 1]

Ïåðâ. ïðèìåí. Èíâ. ¹ ïîäë. Ïîäï. è äàòà Âçàì. èíâ. ¹ Èíâ. ¹ äóáë. Ïîäï. è äàòà Ñïðàâ. ¹

2 Ýëåìåíòû ïîç. R3, R398, R328, R349, R352, R353, R354, R355, R356, R357, C452, R18, R20, R40, R39,
R172, R178, R179, R186, R187, R194, R195 óñòàíàâëèâàòü ïîñëå íàñòðîéêè ïëàòû ïðè íåîáõîäèìîñòè.
4 DS1021-1x4 ïîäðåçàòü ïîä êîíêðåòíûå îòâåðñòèÿ íà ïëàòå.
äèîäîâ.
6 Ïîñàäî÷íûå ìåñòà ïîç. X14-X19 è X27-X34 (S0991-46R) äëÿ óñòàíîâêè ýêðàíà.
7 Ýëåêòðè÷åñêèé ìîíòàæ ïðîèçâîäèòü â ñîîòâåòñòâèè c ÀÐÁÌ.468157.011Ý3.
8 Òðåáîâàíèÿ ê ìîíòàæó ýëåìåíòîâ ïî ÃÎÑÒ Ð ÌÝÊ 61191-2-2017.
9 Çàùèòó ìèêðîñõåì èíòåãðàëüíûõ è ïðèáîðîâ ïîëóïðîâîäíèêîâûõ îò ñòàòè÷åñêîãî ýëåêòðè÷åñòâà
ïðîèçâîäèòü ïî ÎÑÒ 11073.062-2001.
10 Ïàñòà ïðèïîéíàÿ Sn62Pb36Ag2, äîïóñêàåòñÿ èñïîëüçîâàòü ÏÎÑÊ 50-18 ÃÎÑÒ 21931-76.
11 Ìàðêèðîâàòü êðàñêîé ÌÊÝ áåëîé ÏÎ ÎÑÒ107.9.4003-96, øðèôò 3-Ïð3 ÃÎÑÒ 26.020-80.
12 Êëåéìî ÎÒÊ íàíåñòè êðàñêîé ÌÊÝ áåëàÿ Â5 ïî ÎÑÒ107.9.4003-96.
13 Îñòàëüíûå ÒÒ ïî ÎÑÒ4 ÃÎ.070.015.

ÀÐÁÌ.468157.011ÑÁ
Ïëàòà ïåðâè÷íîé îáðàáîòêè ñèãíàëà Ñáîðî÷íûé ÷åðòåæ | Ëèò. | Ìàññà | Ìàñøòàá

Èçì. Ëèñò | ¹ äîêóì. | Ïîäï. | Äàòà | | | | | 0,85 | 1:1
Ðàçðàá. | ×åïðàñîâ
Ïðîâ. | Êèì
Ò. êîíòð. | | | | Ëèñò | Ëèñòîâ 4

Í. êîíòð. | Ìàëûøåâ
Óòâ. | Ìàðüÿñîâ

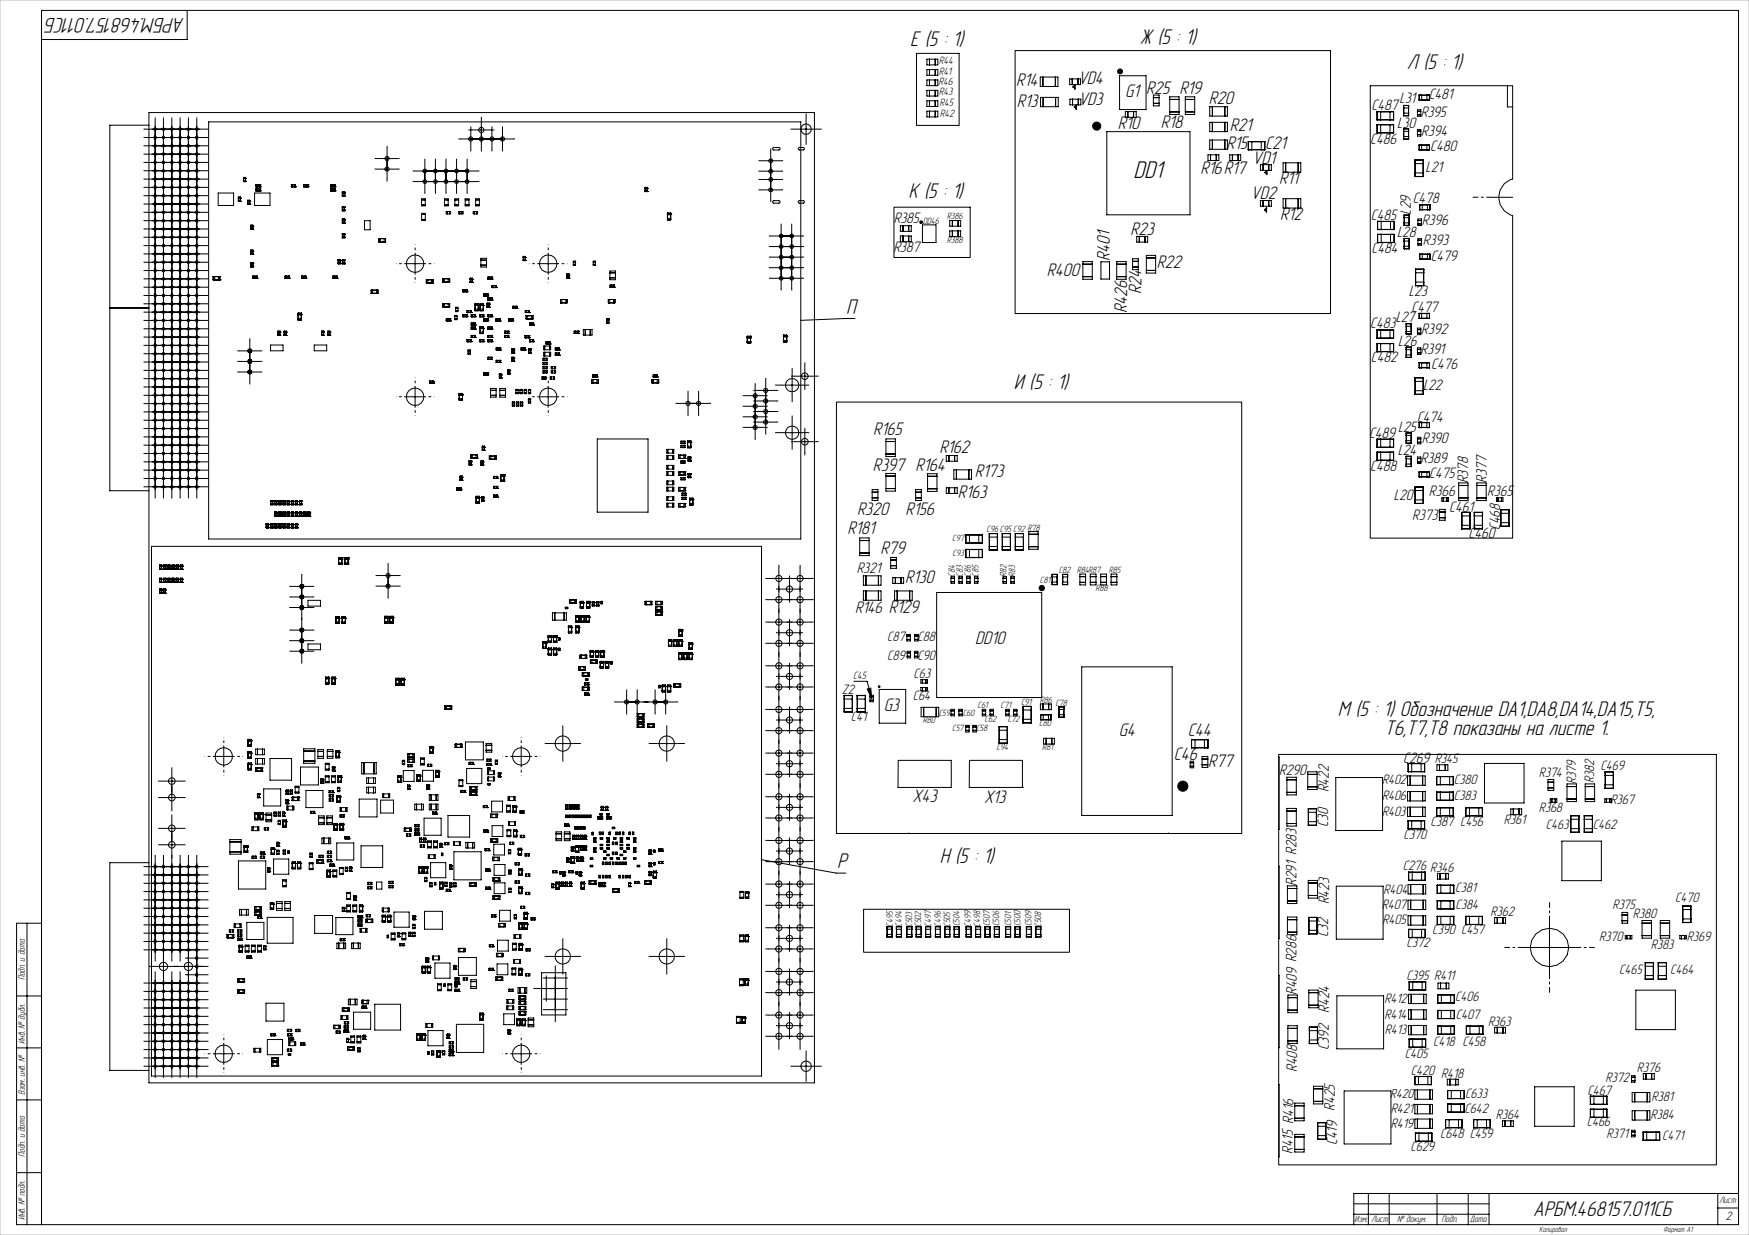
[picture p103: page 2]

Ïîäï. è äàòà Èíâ. ¹ äóáë. Âçàì. èíâ. ¹ Ïîäï. è äàòà Èíâ. ¹ ïîäë.

ÀÐÁÌ.468157.011CÁ Èçì. Ëèñò

¹ äîêóì. | Ïîäï. | Äàòà

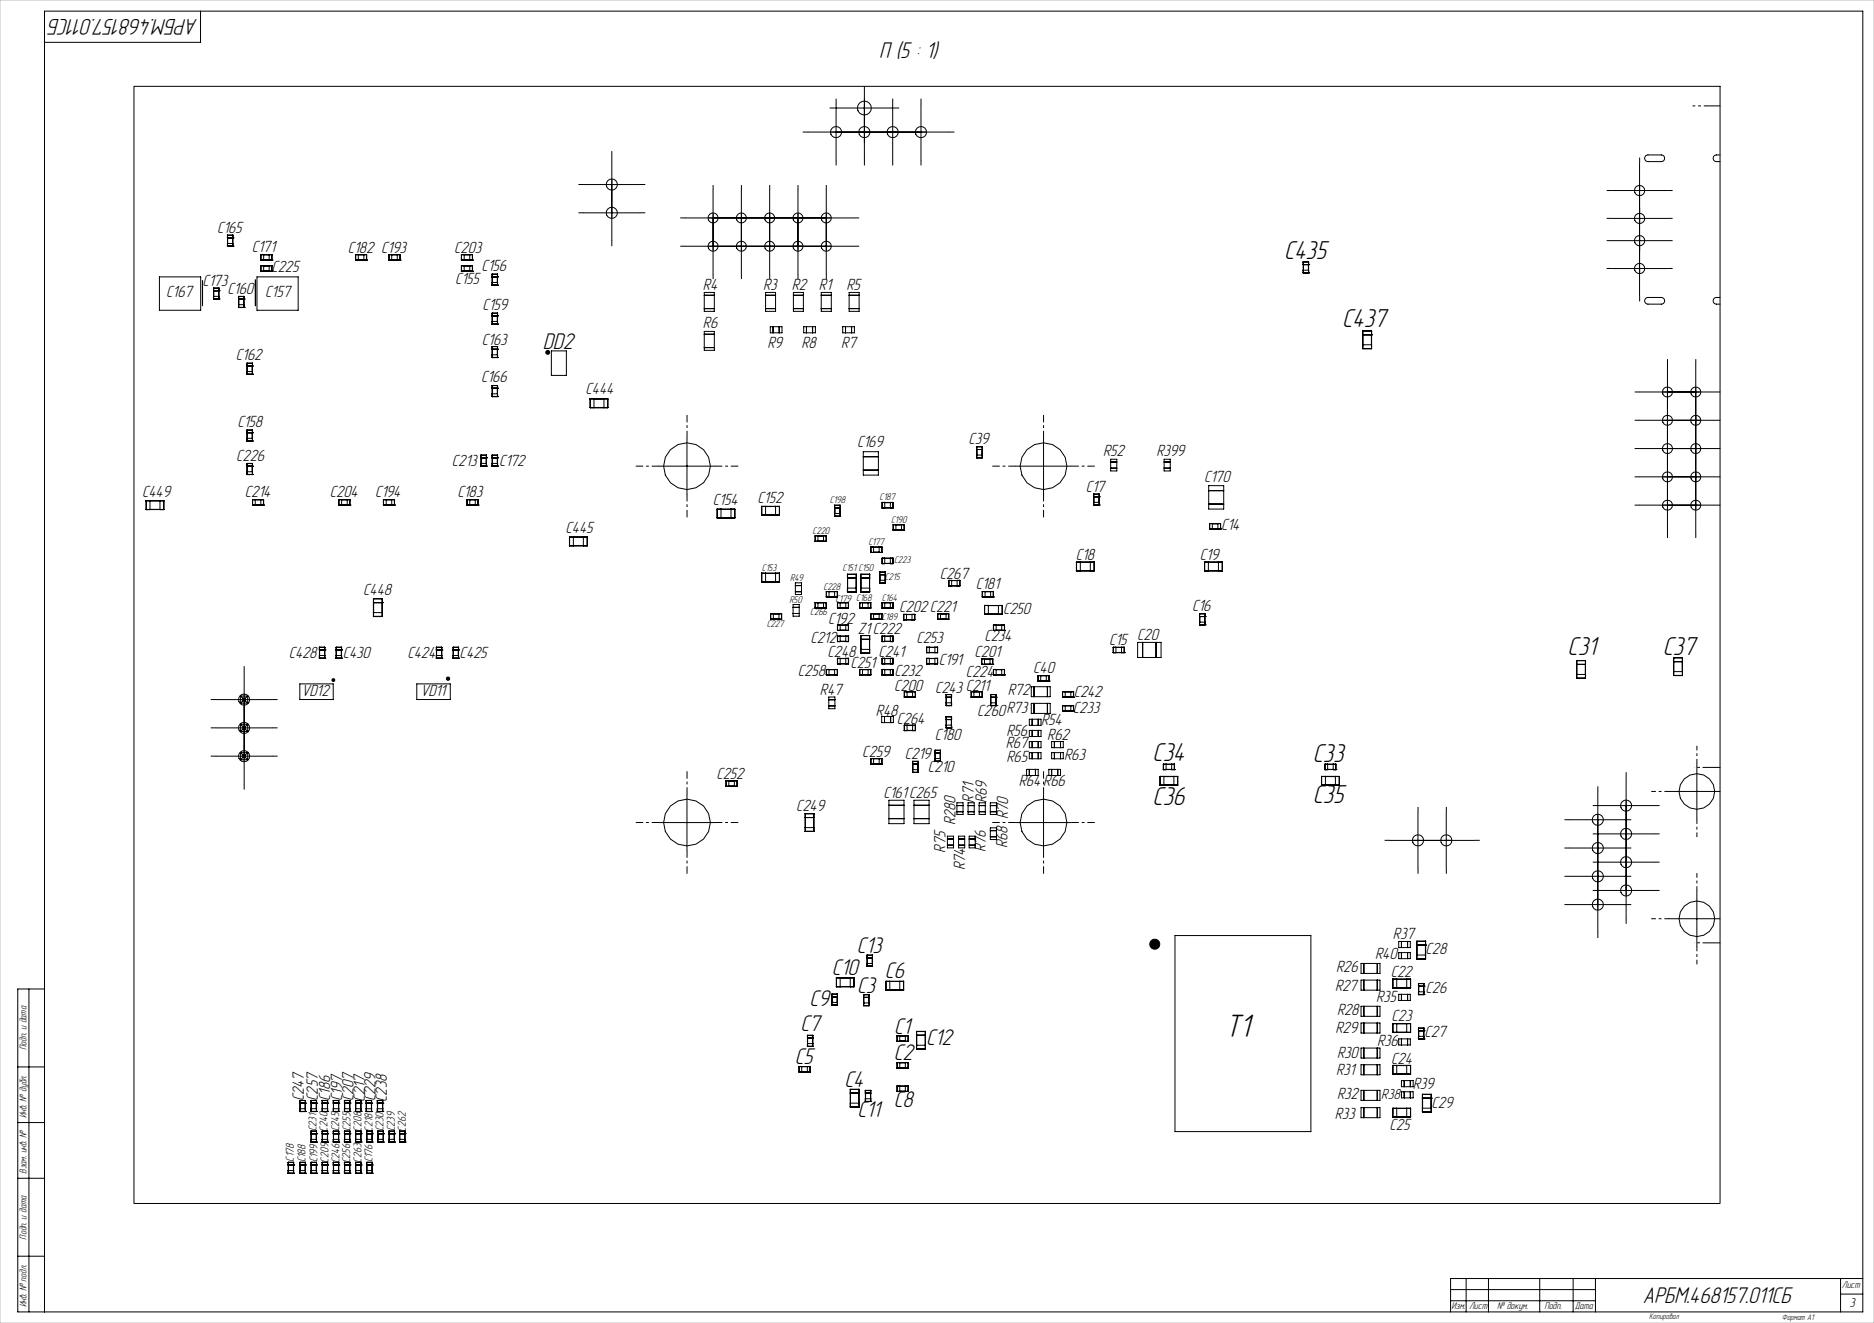
[picture p104: page 3]

Ïîäï. è äàòà Èíâ. ¹ äóáë. Âçàì. èíâ. ¹ Ïîäï. è äàòà Èíâ. ¹ ïîäë.

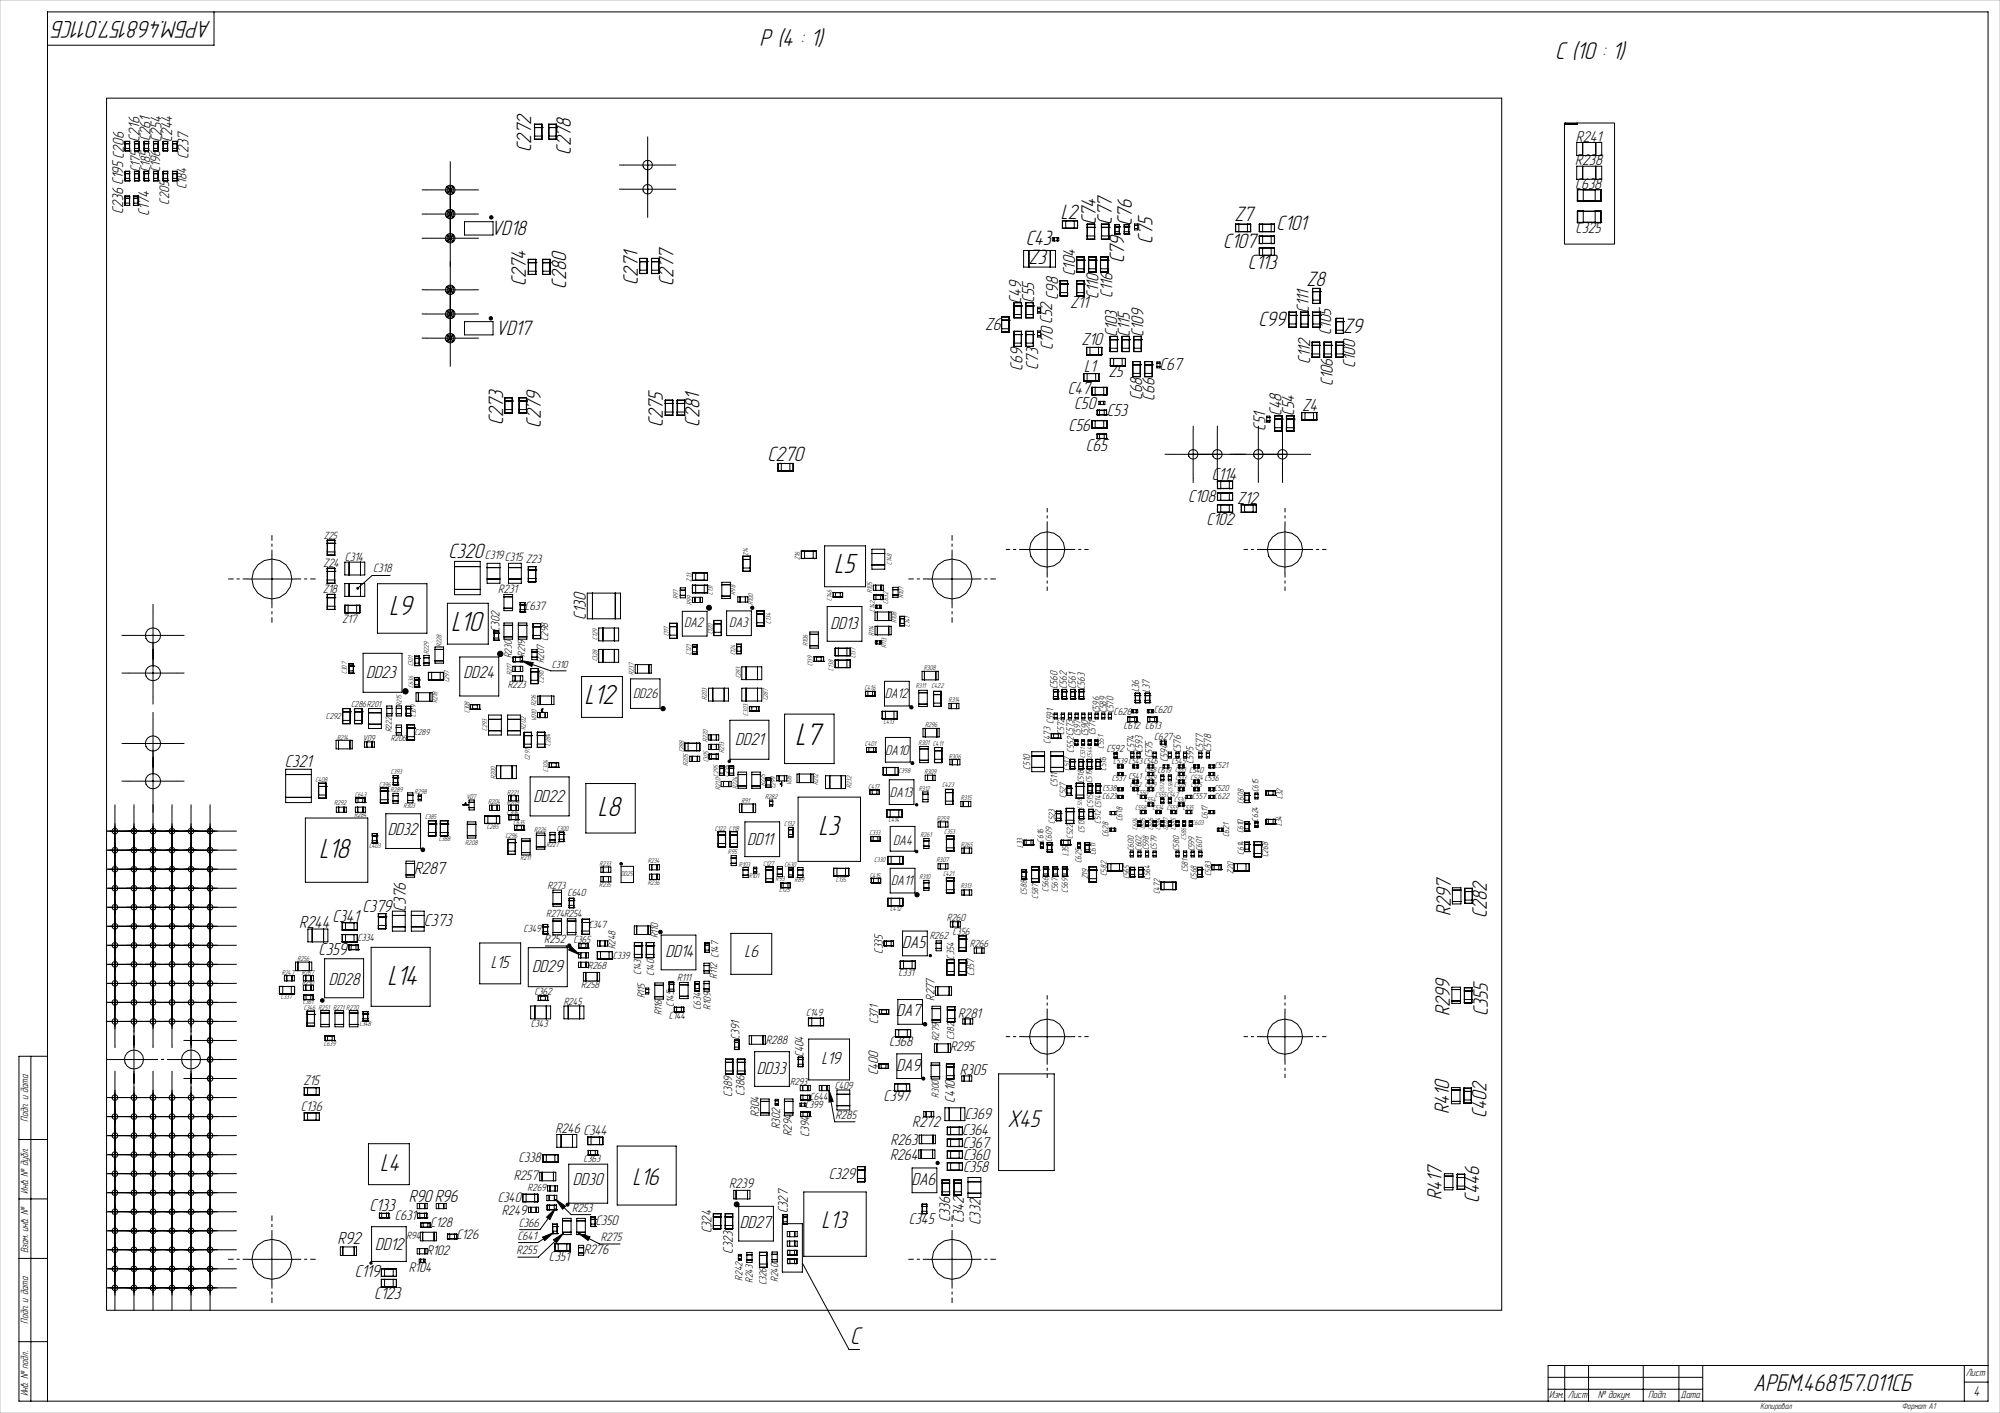
[picture p105: page 4]

Ïîäï. è äàòà Èíâ. ¹ äóáë. Âçàì. èíâ. ¹ Ïîäï. è äàòà Èíâ. ¹ ïîäë.
