prod1cys-cmd/RVN/(commit log)

2026-11-10 README для всех папок; книга 3 «Техническая реализация и описание макетов»
    - README.md в корне и в каждой папке: состав, обозначения, навигация
    - Книга 3 переоформлена как книга отчёта о НИР по ГОСТ 7.32-2017
    - Новый раздел 11 (макеты на плате АРБМ.468157.011) и раздел 12
    (расчёт стоимости основных компонентов)
    - Ссылки на книги приведены к новой нумерации (1–4)
    - Исправлены замечания сверки; А-ЦАП заменён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
2026-11-11 Книга 3: правка стиля, опорный сигнал диапазоном, раздел 11 от модуля к макетам
    - внешний опорный сигнал: 10-800 МГц, 0 дБм ± 3 дБ на 50 Ом (таблица 1.3, 5.3, таблица 5.5, рисунки 2.1 и 5.3)
    - раздел 11: характеристики макетов и характеристики модуля, проверяемые на макетах по ПМ
    - убраны ссылки на исключённые приложения и таблицу 12.2, внутренние замечания
    - таблица 12.1: исправлен итог (96 296,52), пересчитаны д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
